freethought101/RackBotGen3/cad/src/README.md

# Models

Frame for all bay-side parts: x = across the bay (0 = centerline), y = into the bay
(0 = rack face), z = up (0 = shelf floor top). Shared numbers: `lib/dims.py`
(source of truth: `docs/spec/01-mechanical.md` §1).

| Script | Output | Purpose | Print |
| --- | --- | --- | --- |
| caddy.py | STEP/caddy.step, STL/caddy.stl | 3.5" drive caddy with hook notch and tag/QR recesses | PETG ×6, floor down, no supports |
| dummy_drive_shell.py | STEP/…, STL/dummy_drive_shell.stl | Ballast shell, 3.5" envelope, heat-set inserts | PLA ×6, floor down |
| dummy_drive_lid.py | STEP/…, STL/dummy_drive_lid.stl | Screw-on lid with label recess | PLA ×6, flat |
| bay_shelf.py | STEP/bay_shelf.step, STL/bay_shelf.stl | Bay shelf: guide walls, lead-in, back stop, switch bracket, M5 flanges | PETG ×6 (4 rack + 2 spare), floor down |
| fit_coupons.py | STEP/fit/…, STL/fit/{shelf_slice,caddy_slice,hole_coupon}.stl | Fit test 1 coupons: 40 mm shelf and caddy slices (channel clearance) and a hole-size coupon — see docs/fit-test-01.md | PETG, < 1 h each |
| bay_fit.py | STEP/bay_fit.step | Fit check: 2 shelves + caddy + dummy + 2020 stubs | — |
| dock_block.py | STEP/…, STL/dock_block.stl | Dock: V-funnel + 10 mm throat, stop at y = −30, charging-contact recesses, dock switch bracket | PETG ×2, floor down |
| tag_fin.py | STEP/…, STL/tag_fin.stl | 50 mm approach tag (ID 0 rack / ID 10 spare) on the front-right upright | PLA ×2 |
| tag_strip_rack.py | STEP/…, STL/tag_strip_rack.stl | Bay tags IDs 1–4 on the front-left upright | PLA ×1 |
| tag_strip_spare.py | STEP/…, STL/tag_strip_spare.stl | Slot tags IDs 11–12 | PLA ×1 |
| rack.py | STEP/rack.step | Rack assembly: 2020 frame, 4 shelves, caddies, dock, tags, Delta PSU/PLC placeholders | — |
| spare_station.py | STEP/spare_station.step | Spare station assembly: S1 GOOD / S2 RMA | — |

| robot/*.py | STEP/robot/…, STL/robot/… | 19 printed robot parts: nose, caster_spacer_rear (×2) + caster_spacer_front (for the bought 20 mm casters), deck, drive_bracket (×2, one mirrored), drive_hub (×2, PETG, outboard face down) + drive_tire (×2, TPU 95A), mast_collar (socket + flange + rear gusset), mast_top_plate (KFL08), z_motor_mount, z_carriage (nut block on a fin + shelf), tray_stack (print on its back plate), rail_bracket, y_idler_bracket, y_carriage (gantry plate, frame, arm, belt clamp), finger (×2, 10 mm), electronics_tray, pi_tray, battery_box | PETG |
| robot_assembly.py | STEP/robot_assembly.step | Robot at a travel pose (Z 210, extractor home) | — |
| robot_docked.py | STEP/robot_docked.step | Rack + robot docked, extracting from bay 2 (Y = Y_PULL = 177, finger B engaged) | — |

Robot frame = rack frame with the robot docked (nose tip on the stop at y = −30). Dimensions:
`lib/robot_dims.py`; assembly factory `lib/robot_build.py` (`robot_parts(Z, Y, fingers)`); purchased parts
are envelope stand-ins in `lib/vendor.py` (NEMA17, MG90S, casters, mini V-wheels, KFL08, Pi, battery…), and the motion
board is the real KiCad STEP export. Robot nested scripts run as `PYTHONPATH=src python src/robot/<part>.py`.

2020 cut list: rack 2 × 220, 4 × 320, 2 × 180; spare station 2 × 220, 4 × 215, 2 × 180;
robot 2 × 300 (rails), 3 × 110 (cross members), 1 × 285 (Y rail); 2040 × 420 (mast). 4.96 m of cuts + kerf → buy 6 × 1 m.

Build (from `cad/`): `PYTHONPATH=src python src/<model>.py` (with `python` = the cadgen uvx Python).
Checks: `PYTHONPATH=src python checks/bay_fit_check.py`, `checks/station_check.py` (station vs robot probe boxes) and
`checks/robot_check.py` (overlap **and ≥ 1 mm running clearance** for every moving pair over 42 poses incl. intermediate
Y and the hard stop; docked lift sweep carrying two caddies; full pull/push strokes at every bay and spare slot with
the caddy moving with the finger, the idle finger parked and the other caddy on the tray; push seats the caddy; camera
sight lines and FOV; mass/CG/tip-over; packing; print bed — see docs/spec/01 §6.8), and `checks/fastener_check.py`:
every screw, nut, T-nut and insert (`lib/robot_fasteners.py`, step.parts models in `cad/vendor/fasteners`) against the
parts: no fastener hits a part it does not thread into (missing / misplaced / blocked holes), heads and nuts seated,
thread engagement without bottoming out (T-nut ≥ 3 mm and short of the slot core, inserts, pilots, motor threads), and
≥ 1 mm from parts moving relative to it over 19 poses. It prints the modeled fastener bill. `robot_assembly.step`
shows the fasteners.

To verify on real hardware: 3.5" bottom hole positions (`HDD_HOLE_Y`, slotted ±3 mm),
KW11-3Z switch hole pitch and actuation point (bracket slotted ±2 mm).
