freethought101/RackBotGen3/docs/cart-batch-2.md

# Tokopedia cart, batch 2 (to add after batch 1 is checked out)

Batch 1 (≈ Rp5.2M incl. shipping, 373 units) filled most of the cart; Tokopedia allows 400 units per cart, so these
go in once batch 1 is paid. Prices are search / listing prices checked on 2026-10-24 and change often. "Min" not
checked unless stated. Rajacell is closed, so it is not used.

## Priced

| # | Item | Qty | Listing (shop, city) | Unit Rp | Line Rp | Notes |
|---|---|---|---|---|---|---|
| 1 | 2020 corner bracket (gusset) | 48 | [Angle Corner Bracket 2020 90° Gusset](https://www.tokopedia.com/rajawali3d/angle-corner-bracket-2020-90-degree-gusset-element-siku-aluminium) (Rajawali3D, Temanggung) | 1,940 | 93,120 | Confirmed on the product page; 50k+ sold |
| 2 | M3 × 8 socket head | 16 | [M3 × 8 socket head](https://www.tokopedia.com/centi-store/baut-hex-hexagonal-l-screw-socket-head-cap-m3-x-8mm-3mm-8-mm) (CENTI Store, Surakarta) | 600 | 9,600 | Alt: 3Din Jakarta DIN912 SS304, Rp700 (already in batch 1 for M5, shares shipping) |
| 4 | M3 heat-set insert, OD 4.5 × L4 | 60 | [PrintfyLabs brass M3](https://www.tokopedia.com/printfylabs/brass-hot-melt-heat-set-insert-nuts-knurled-m3-berbagai-ukuran-untuk-inset-baut-drat-3d-print-1731185180283733698) (Cimahi) | ≈ 1,450 | ≈ 87,000 | Check the M3 × 4 × 4.5 variant and whether the price is per piece |
| 5 | M5 heat-set insert, OD ≈ 7 | 15 | [Ciptakarya3d M2–M8](https://www.tokopedia.com/ciptakarya3d/brass-hot-melt-thread-inserts-nut-m2-m2-5-m3-m4-m5-m6-m8-double-twill-knurled-varian-1-x-100pcs-free-box-1729797896345322881) | ≈ 1,900 | ≈ 28,500 | M5 variant price not confirmed |
| 7 | microSD 32 GB SanDisk Ultra A1 | 1 | [EAONLINE](https://www.tokopedia.com/eaonlineofficial/sandisk-ultra-micro-sd-uhs-i-a1-120mbps-32gb-qua4) (Jakarta) | 217,300 | 217,300 | Not the official store; the official SanDisk Indonesia store shows ≈ Rp227,500. A local shop is likely cheaper (≈ Rp60–130k in sourcing-options) |
| 9 | Servo extension 30 cm, 3-pin | 3 | [Arduino Store](https://www.tokopedia.com/arduinoid/kabel-extension-sensor-servo-3pin-wire-female-to-female-10cm-30cm-50cm-1729640693361902744) (Bekasi) | 6,081 | 18,243 | Same shop as the camera cable in batch 1 |
| 11 | Pi 3 heatsink set | 1 | [Mechatron](https://www.tokopedia.com/mechatron/set-heatsink-raspberry-pi-3-thermal-tape-4pcs-pendingin-heat-sink) (Depok) | 10,500 | 10,500 | |
| 13 | Silicone wire 18 AWG, red + black 1 m | 2 | [My Aladin](https://www.tokopedia.com/alladinshop/1meter-kabel-silikon-18awg-silicone-wire-18-awg-merah-atau-hitam-awg18-rc-1730879276904908043) (Bekasi) | 7,372 | 14,744 | Red and black were **sold out** on 24 Oct; recheck or buy locally |
| 16 | Inline blade fuse holder | 1 | [pln-original](https://www.tokopedia.com/pln-original/fuse-blade-holder-waterproof-rumah-sekring-tancap-small-kecil-dengan-kabel-merah-untuk-keamanan-listrik-17338236263444982) (Bandung) | 5,099 | 5,099 | 7.5 A blade fuses not found: buy at a local auto/electrical shop |
| 17 | SS54 Schottky (SMA) | 2 | [Elektro Bar](https://www.tokopedia.com/elektrobar/ss54-1n5824-schottky-diode-sma-ss-54-1n-5824-1733751768989205551) (Jakarta Barat) | 550 | 1,100 | |
| 18 | 1N4007 | 5 | [Putra Niaga](https://www.tokopedia.com/putraniagabdg/dioda-1n4007-1a-1000v-in4007-high-quality-1730886221138658600) (Bandung) | 250 | 1,250 | Already a batch-1 shop |
| 19 | 5 × 20 fuse T3.15 A slow-blow | 3 | [Tektron, Littelfuse ceramic](https://www.tokopedia.com/tektron/fuse-3-15a-250v-littelfuse-keramik-ceramic-slowblow-5x20-5-20-3-15a) (Bandung) | 5,000 | 15,000 | |
| 20 | 22 mm pilot lamp 24 V DC, R/Y/G | 3 | [Kanglistrik, EWIG red](https://www.tokopedia.com/kanglistrik/lampu-indikator-pilot-lamp-24v-dc-22mm-premium-quality-ewig-merah) (Jakarta Barat) | 10,000 | 30,000 | Only the red listing seen; check yellow/green. Central Electrindo EWIG: min 5 per colour (≈ Rp110k for 15) |
| 22 | Brass sheet 0.5 mm, 10 × 10 cm | 1 | [SOEMBER-SUKSES](https://www.tokopedia.com/soember-suksess/plat-kuningan-0-5mm-x-10cm-x-10cm) (Jakarta Barat) | 22,000 | 22,000 | |

Priced subtotal ≈ **Rp553k** (≈ Rp336k without the microSD).

**Added to the cart on 24 Oct** (fit under the 400-unit cap): #7, 9, 11, 16, 17, 18, 19, 22 (≈ Rp290k).
**Still to add after batch 1 is paid:** #1, 2, 4, 5 (don't fit), #20 (minimum 5 per colour = 15 lamps, ≈ Rp110k),
#13 (red/black sold out; buy locally), plus everything under "Still to find".

## Still to find

| # | Item | Qty | Notes |
|---|---|---|---|
| 3 | M3 × 16 socket head + M3 nuts | 1 + ≈ 20 | 3Din Jakarta (DIN912) or Rajawali3D |
| 6 | M2 × 8 self-tapping screws | 1 pack | [Ada Hardware M2 × 8](https://www.tokopedia.com/adahardware/baut-pa-phillips-head-micro-screws-round-head-self-tapping-sekrup-elektronik-kayu-ujung-runcing-m2-m2-8-c9490) (from sourcing-options, price not rechecked) |
| 8 | Micro-USB male pigtail, bare wires | 1 | Search found only full cables; cutting a cheap micro-USB cable works |
| 10 | Heat-shrink assortment | 1 | Candidates: mutiaratokped (580 pcs), CASTA (164/328/530 pcs) |
| 12 | Drag chain 7 × 7 or 10 × 10 mm, 1 m | 1 | Lajarus only has 20–35 mm wide ones (Rp140k, too big) |
| 14–15 | 22 AWG and 26 AWG wire | few m | Local electronics shop is fine |
| 21 | 8-ch optocoupler 24 V → 3.3 V | 1 | None in stock; an 8-ch PC817 board (≈ Rp24k, seller not captured) or PC817 ×10 + resistors |
| 23–24 | 4-core and 2-core 0.75 mm² cable | 2 m each | Local electrical shop |
| 25 | XT60 female with 14 AWG lead | 1 | Not found at Pit stop hobby; cut one end off a spare XT60 pigtail or buy locally |
| 26 | JST-XH crimp tool SN-28B | 1 | Optional, only if the team has none |
