freethought101/RackBotGen3/docs/poster/poster.html

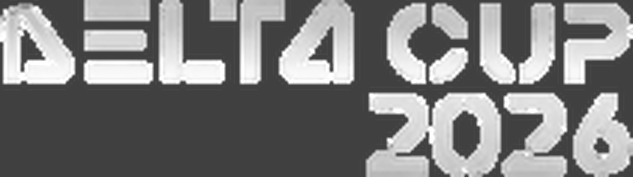
[picture p9: docs/poster/img/deltacup.png]
Delta Cup 2026
AUTOMATION TRACK 

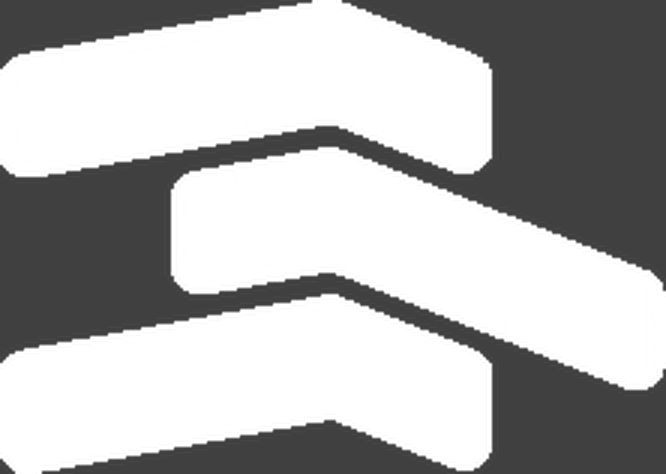
[picture p10: docs/poster/img/logo.png]


# CORVIN

Reducing manual downtime in data centers with an autonomous robot that replaces failed hard drives, with real-time operator control

The problem

### Drives fail, people walk

Until a technician swaps the drive, the RAID array runs without redundancy.

Our solution

### Corvin swaps them itself

It fetches a spare, swaps the drive and returns the failed one for RMA.

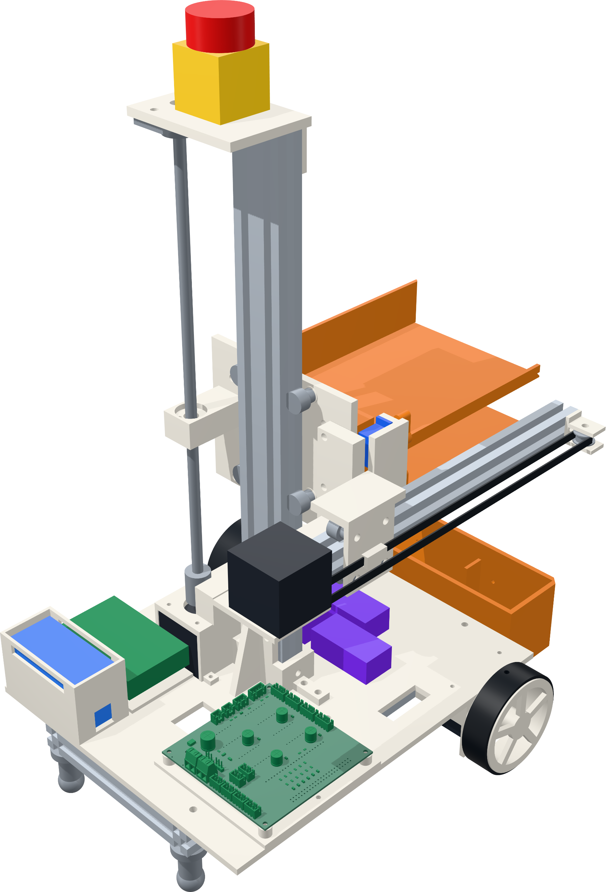
[picture p11: docs/poster/img/robot.png]
Corvin robot CAD render


Corvin at the rack

CAD model · docked at a 4-bay rack

One swap, start to finish

1

DetectDashboard flags a failing drive in bay N.

2

Pick the sparePulls a good drive into the upper slot.

3

Drive and dockAprilTag approach, V-funnel to ±2 mm.

4

ExtractChecks the caddy tag, pulls the failed drive.

5

InsertLift drops 45 mm, pushes the spare in.

6

Return for RMALeaves the failed drive in the RMA slot.

7

Charge and logCharges on the dock, logs time and Wh.

System architecture

Delta inside

### Industrial-style control

- Delta 24 V PSU: rack and dock power
- ESP32 controller: 24 V I/O, safety
- Same Modbus TCP map as a Delta PLC

IIoT + energy

### Every swap, live

- Bays, jobs and camera, 5 updates/s
- Energy (Wh) measured per swap
- Sleeps on the dock between jobs

≤3min

per full swap
(107 s simulated)

48/50

swaps with no help:
our test target

±2mm

docking repeatability
with the V-funnel

2

trips per job:
home → rack → home

50Wh

battery, under the
100 Wh flight limit

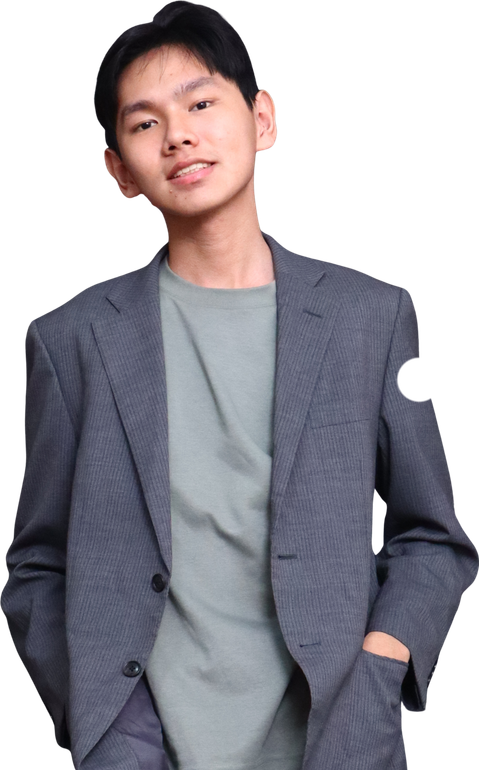
[picture p12: docs/poster/img/richard.png]
richard


Richard

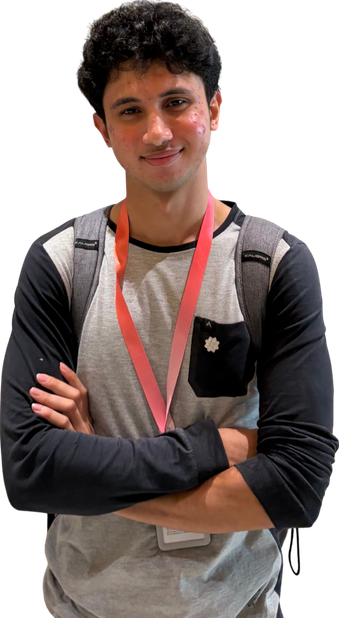
[picture p13: docs/poster/img/saleh.png]
saleh


Saleh

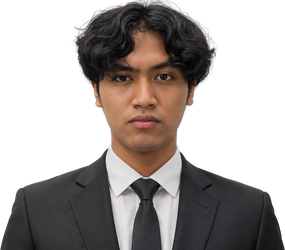
[picture p14: docs/poster/img/bagus.png]
bagus


Bagus

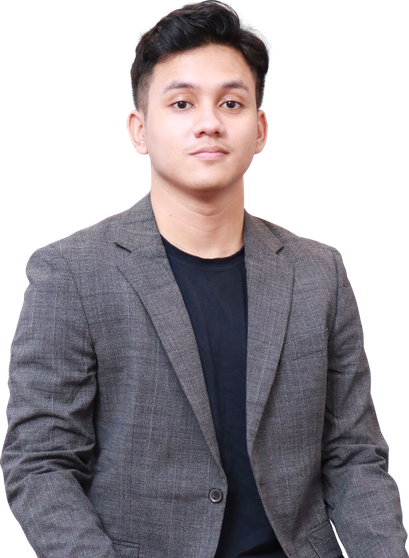
[picture p15: docs/poster/img/rangga.png]
rangga


Rangga

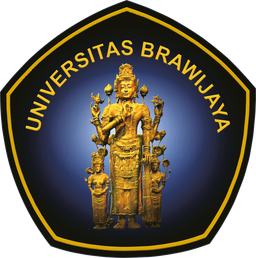
[picture p16: docs/poster/img/ub.png]
Universitas Brawijaya


Team

## Boys Go To Thailand

University of Brawijaya, Indonesia
