freethought101/RackBotGen3/pcb/system/rbg3-system.pdf

1 | 2 | 3 | 4 | 5 | 6
1 | 2 | 3 | 4 | 5 | 6

AB

C

D

AB

C

### D Date: 2026-10-24

Size: A4 | Rev: 1
KiCad E.D.A. 10.0.5 | Id: 1/4

# Title: RBG3 system wiring: overview

### File: rbg3-system.kicad_sch

### Sheet: /

## RackBotGen3 (Delta Cup 2026)

### Generated by pcb/system/scripts/gen_system.py; edit the script, not these files

### Board-level circuit: pcb/motion-board/rbg3-motion.kicad_sch

Robot harness File: robot.kicad_sch | Rack and spare station

File: rack.kicad_sch

ESP32 rack controller (PLC fallback) File: rack-esp32.kicad_sch

# RackBotGen3 (Corvin) system wiring

Sheet 2: robot harness (battery, fuse, switch, INA226, E-stop relay, bucks, charger, Pi, motion board connectors, motors, switches, servos, LED, buzzer).
Sheet 3: rack and spare station (mains, 24 V PSU, rack controller terminals, bay switches, E-stop, dock relay, lamps, station cables, dock contacts and station switches).
Sheet 4: ESP32 rack controller, the PLC fallback (P40), wired to the same terminal names. The two sides meet only at the spare-station dock: robot pads J102 ↔ station contacts J202

(24 V charging, switched by the rack's dock relay), and over Wi-Fi (Pi AP RACKBOT ↔ rack controller).

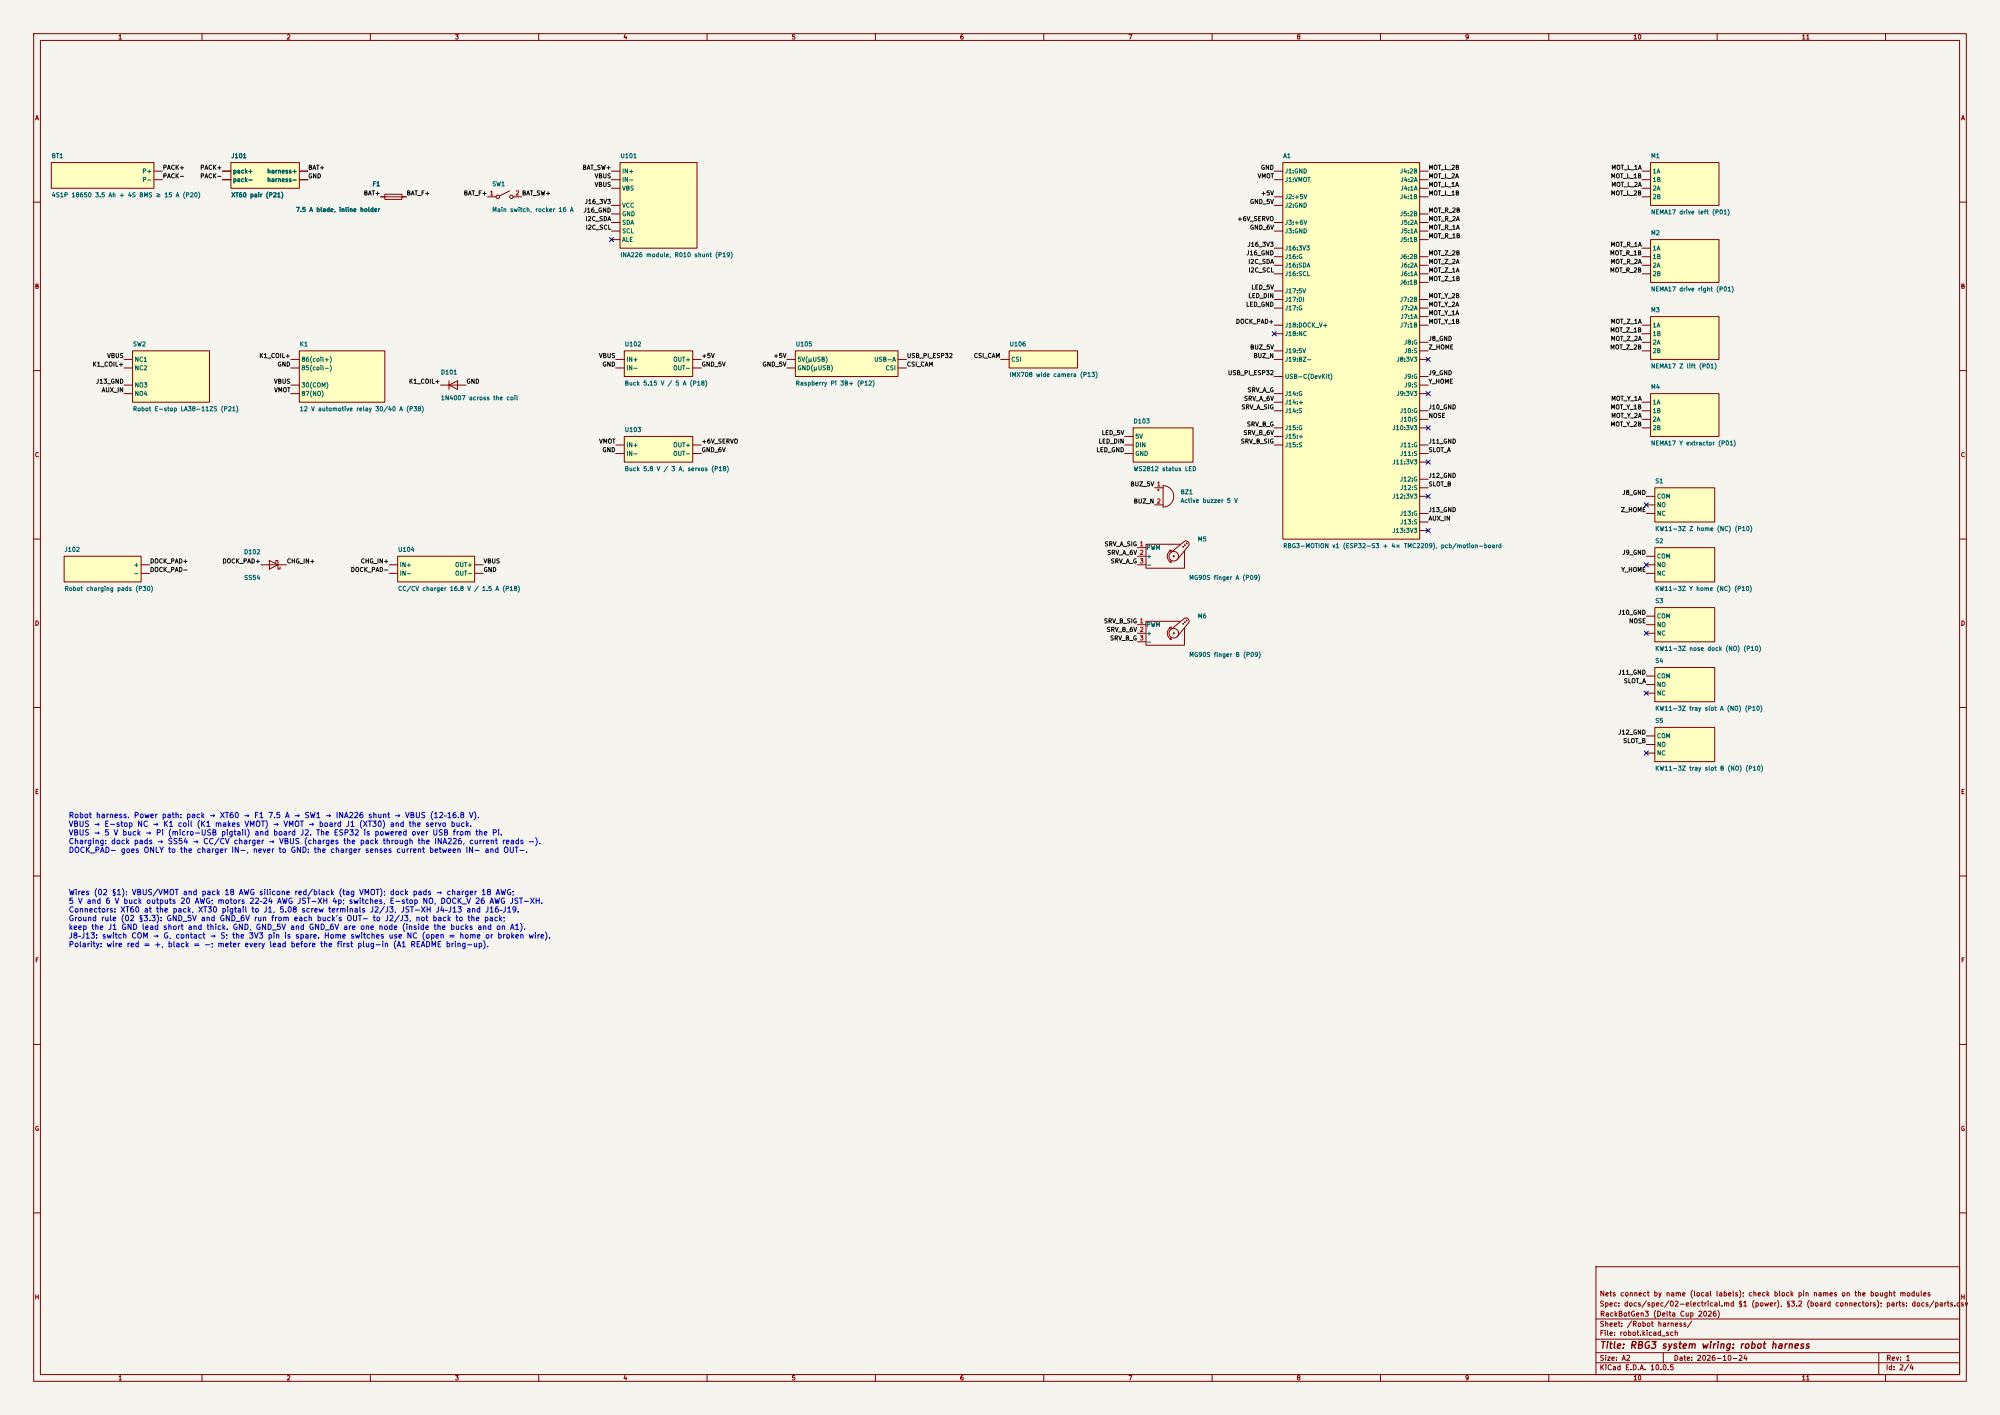
[picture p20: page 2]

A1RBG3-MOTION v1 (ESP32-S3 + 4× TMC2209), pcb/motion-board 1

SRV_A_6V Robot harness. Power path: pack → XT60 → F1 7.5 A → SW1 → INA226 shunt → VBUS (12–16.8 V).

VBUS → E-stop NC → K1 coil (K1 makes VMOT) → VMOT → board J1 (XT30) and the servo buck.
VBUS → 5 V buck → Pi (micro-USB pigtail) and board J2. The ESP32 is powered over USB from the Pi.
Charging: dock pads → SS54 → CC/CV charger → VBUS (charges the pack through the INA226, current reads −).
DOCK_PAD− goes ONLY to the charger IN−, never to GND: the charger senses current between IN− and OUT−.

Wires (02 §1): VBUS/VMOT and pack 18 AWG silicone red/black (tag VMOT); dock pads → charger 18 AWG;
5 V and 6 V buck outputs 20 AWG; motors 22–24 AWG JST-XH 4p; switches, E-stop NO, DOCK_V 26 AWG JST-XH.
Connectors: XT60 at the pack, XT30 pigtail to J1, 5.08 screw terminals J2/J3, JST-XH J4–J13 and J16–J19.
Ground rule (02 §3.3): GND_5V and GND_6V run from each buck's OUT− to J2/J3, not back to the pack;
keep the J1 GND lead short and thick. GND, GND_5V and GND_6V are one node (inside the bucks and on A1).
J8–J13: switch COM → G, contact → S; the 3V3 pin is spare. Home switches use NC (open = home or broken wire).
Polarity: wire red = +, black = −; meter every lead before the first plug-in (A1 README bring-up).

Nets connect by name (local labels); check block pin names on the bought modules
Spec: docs/spec/02-electrical.md §1 (power), §3.2 (board connectors); parts: docs/parts.csv
RackBotGen3 (Delta Cup 2026)
Sheet: /Robot harness/
File: robot.kicad_sch
Title: RBG3 system wiring: robot harness

1 | 2 | 3 | 4 | 5 | 6 | 7 | 8
1 | 2 | 3 | 4 | 5 | 6 | 7 | 8

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
### F Date: 2026-10-24

Size: A3 | Rev: 1

# Title: RBG3 system wiring: rack and spare station

### File: rack.kicad_sch

### Sheet: /Rack and spare station/

## RackBotGen3 (Delta Cup 2026)

### Spec: docs/spec/02-electrical.md §4 (rack), §5 (safety); 03 §4 (Modbus); 01 §5 (stations)

### U201 terminals are the PLC's; the ESP32 fallback (sheet 4) exposes the same functions

LN

PE

J201 Mains 220 V cord + plug | COM

NO
NC

S207 KW11-3Z S2 RMA present (X7) (P10) COM NO
NC

S206 KW11-3Z S1 GOOD present (X6) (P10) COM NO
NC

S205 KW11-3Z dock: robot home (X4) (P10) H203 RED 24 V 22 mm (P27) DOCK+

DOCK−

DOCK+
DOCK−

W202

2-core 0.75 mm² dock lead ≈ 1.5 m (P30) +24V X4

X6

X7 | +24V X4
| X6

X7 W201

4-core signal cable ≈ 1.5 m (P30) | H202

YELLOW 24 V 22 mm (P27) H201 GREEN 24 V 22 mm (P27) 24V 0VS/S

X0
X1
X2
X3
X4
X5
X6
X7 | UP ZP
| Y0 Y1 Y2 Y3
| LAN

U201 Rack controller: Delta DVP-12SE11T (P25) or ESP32 fallback (P40) NC-A1 NC-A2 NC-B1 NC-B2

SW201 Rack E-stop 2 × NC (P28) COM NO
NC

S204 KW11-3Z bay 4 caddy present (P10) COM NO
NC

S203 KW11-3Z bay 3 caddy present (P10)

+(right)

−(left) J202 Dock contacts, spare station (P30)

F201

3.15 A slow-blow, UK5-HESI DC+ DC−
IN

COM
NO
NC

K201
24 V relay module, low-level trigger (P26) COM NO
NC

S202 KW11-3Z bay 2 caddy present (P10) COM NO
NC
S201 KW11-3Z bay 1 caddy present (P10) | LN
PE | +V −V PS201 Delta DRL-24V120W1EN 24 V 5 A (P24) X3

STN_X7

AC_N

PE | 0V

Y0

AC_L AC_N

PE | +24V DOCK_RLY_24V0V

Y0 +24V X0

STN_DOCK−

+24V X1

0V+24V

Y1 +24V | +24V_F | +24V +24V_F DOCK+

X7

0V +24V | STN_24V +24V | X6

X2

X5

X4

0V X0 DOCK_RLY_24V +24V X5 +24V

X3

STN_X4

STN_DOCK+ Y1 +24V

Y3 | +24V Y2 | +24V Y3

# Y2 +24V X4

X6

# X7 DOCK+

0V | STN_DOCK−

STN_24V
STN_X4
STN_X6
STN_X7

X2

STN_DOCK+

X1

STN_24V STN_X6

STN_24V

AC_L

LAN: only with the PLC (Wi-Fi client bridge to
the Pi AP RACKBOT, 02 §4.3). The ESP32 uses Wi-Fi. Rack DIN rail: PSU, U201, K201, F201, terminal blocks for +24V / 0V. Spare station: S205–S207 and J202.

Inputs: switches connect +24V to Xn, S/S to 0V (sourcing). Outputs Y0–Y3 sink (NPN): lamps and K201 IN go between +24V and Yn. UP = +24V, ZP = 0V power the PLC's transistor outputs.
Dock power: K201 closes only while Y0 = M0 AND X4 AND X5 AND watchdog OK (ladder, 03 §4). The E-stop's second NC contact feeds K201's DC+, so a pressed E-stop drops the relay in hardware.
J202 mates with the robot's charging pads (robot sheet J102): + on the right, − on the left, viewed from the robot. 24 V reaches the pads only while the robot is docked and X4 is closed.
The rack's own dock has no switch and no contacts (01 §4): the robot's NOSE switch confirms docking there.
PE: also bond the aluminium rack frame to PE. | H202
YELLOW 24 V 22 mm (P27) | H203 RED 24 V 22 mm (P27)

1 | 2 | 3 | 4 | 5 | 6 | 7 | 8
1 | 2 | 3 | 4 | 5 | 6 | 7 | 8

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
### F Date: 2026-10-24

Size: A3 | Rev: 1

# Title: RBG3 system wiring: ESP32 rack controller (PLC fallback)

### File: rack-esp32.kicad_sch

### Sheet: /ESP32 rack controller (PLC fallback)/

## RackBotGen3 (Delta Cup 2026)

### Spec: docs/spec/02-electrical.md §4.4; parts: P40

### GPIO choice is a proposal: confirm it when the rack firmware is written

IN1
IN2
IN3
IN4
IN5
IN6
IN7
IN8 COM

# OUT1 OUT2 OUT3 OUT4 OUT5 OUT6 OUT7 OUT8

VCC

GND U303

8-ch 24 V opto input board (P40) | DC+ DC−
| TRIG1
TRIG2 GND | OUT1− OUT2−

U304 Dual MOSFET D4184 (P40): Y0, Y1

VIN(5V) GND

3V3 GPIO32 GPIO33 GPIO25 GPIO26 GPIO27 GPIO14 GPIO13 GPIO4 | GPIO16 GPIO17 GPIO18 GPIO19 U302

ESP32 DevKit V1 WROOM-32 (P40) +24V 0VX0

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
X301

Terminal row = rack sheet U201 terminals

IN+
IN−

OUT+
OUT−
U301 Buck 24 → 5 V (P40) | DC+

DC−

TRIG1

TRIG2 GND | OUT1− OUT2−

U305

0V | Dual MOSFET D4184 (P40): Y2, Y3

0V X2
X3
X4
X5
X6
X7

0V

IN_X0
IN_X1
IN_X2

# IN_X3 +3V3

X0

IN_X4
IN_X5
IN_X6
IN_X7
0V +24V | Y0

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
IN_X5

X5
X6
X7
Y2 +5V | +5V0V +3V3

IN_X6
IN_X7

0V

IN_X0
IN_X1
IN_X2
IN_X3
IN_X4

TRIG_Y3

TRIG_Y0
TRIG_Y1
TRIG_Y2 | +24V0V

TRIG_Y0
TRIG_Y1

Y0 +24V

Y3

0V

Y1 +24V | Y2

0V

TRIG_Y2
TRIG_Y3

X1 Replaces U201 on the rack sheet: the wires that went to the PLC's X0–X7, Y0–Y3, 24V and 0V land on X301.

Inputs: opto IN1–IN8 take the +24 V switch signals with COM to 0V; the opto outputs pull the GPIOs low when an input is on (use INPUT_PULLUP if the board has no pull-ups; check its jumper/polarity).
Outputs: the D4184 modules sink like the PLC's NPN outputs, so lamps and the dock relay module (low-level trigger) keep their +24V common wiring. GPIO16–19 drive the triggers (3.3 V logic).

Proposed pins avoid the ESP32 strapping pins 0, 2, 5, 12, 15 and the flash pins 6–11; GPIO34–39 are left
free (input-only, no pull-ups). The firmware exposes the same Modbus TCP map as the PLC (03 §4) over Wi-Fi. Module pin names vary by vendor: check the bought boards before wiring.
