freethought101/RackBotGen3/.deck-publish/video/corvin-pitch-still.jpg

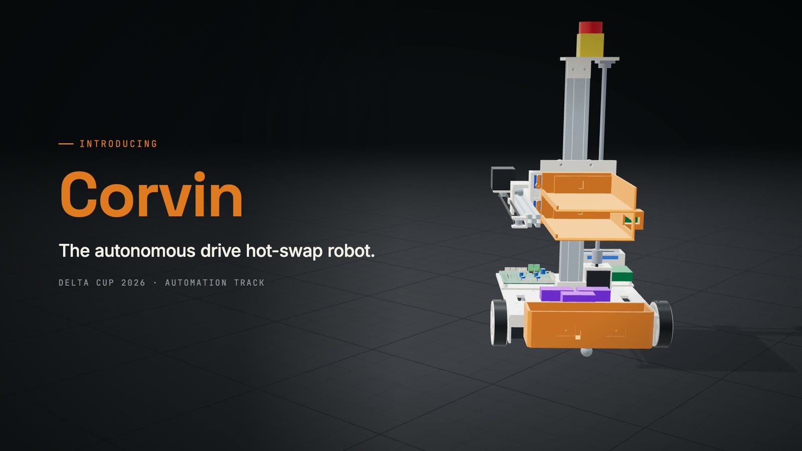
.deck-publish/video/corvin-pitch-still.jpg
