freethought101/RackBotGen3/.deck-publish/video/sheet.jpg

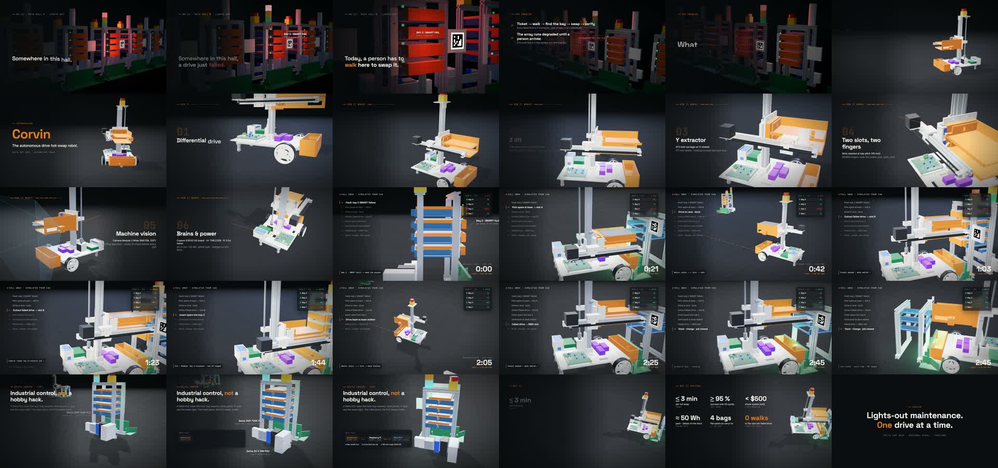
.deck-publish/video/sheet.jpg
