freethought101/RackBotGen3/.deck-publish/video/title-check.jpg

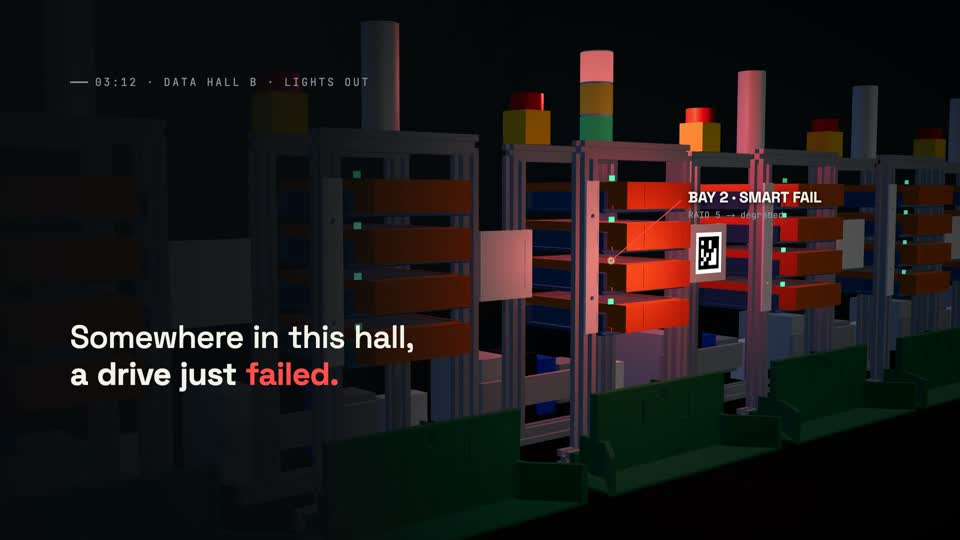
.deck-publish/video/title-check.jpg
