freethought101/RackBotGen3/docs/datasheets/P05_anti-backlash-nut-block_drawing.jpg

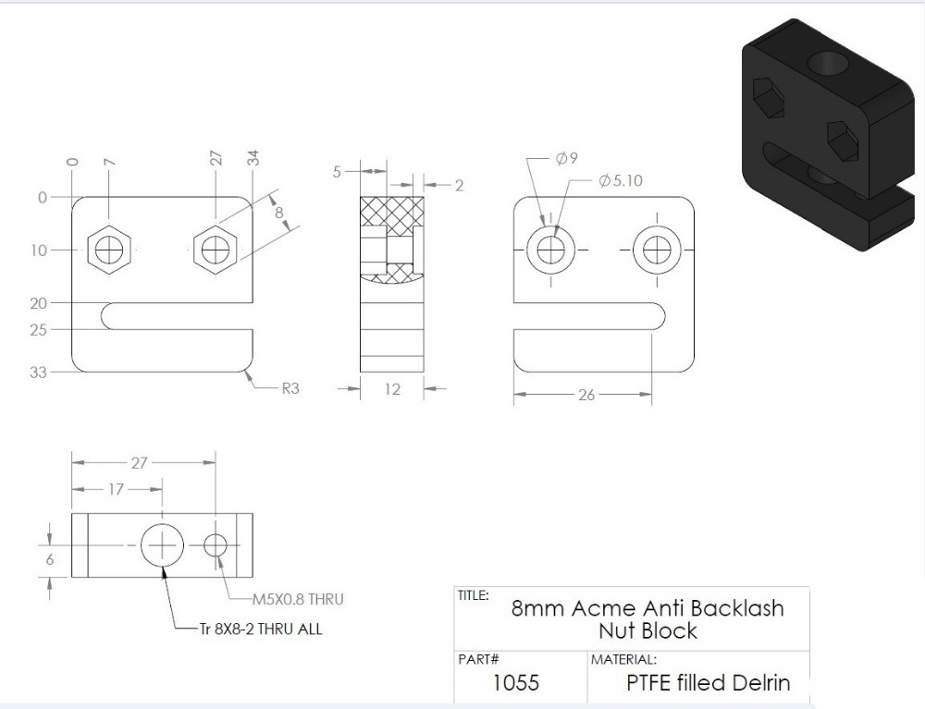
docs/datasheets/P05_anti-backlash-nut-block_drawing.jpg
