freethought101/RackBotGen3/docs/datasheets/P11_heat-set-inserts_3din.jpg

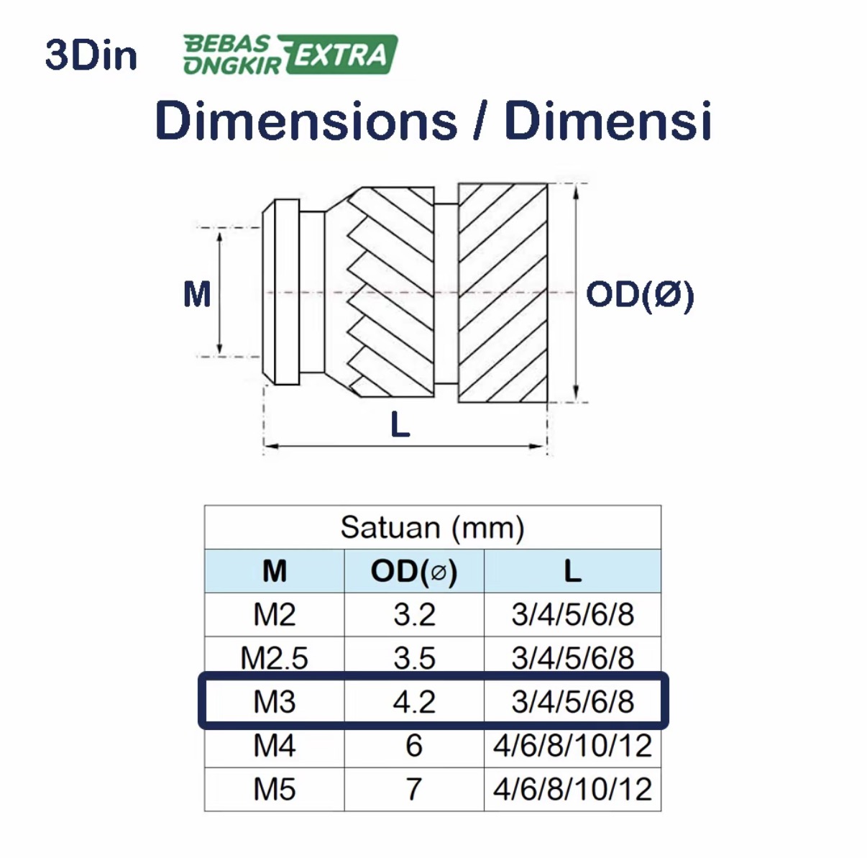
docs/datasheets/P11_heat-set-inserts_3din.jpg
