freethought101/RackBotGen3/docs/poster/Corvin-poster-A2.png

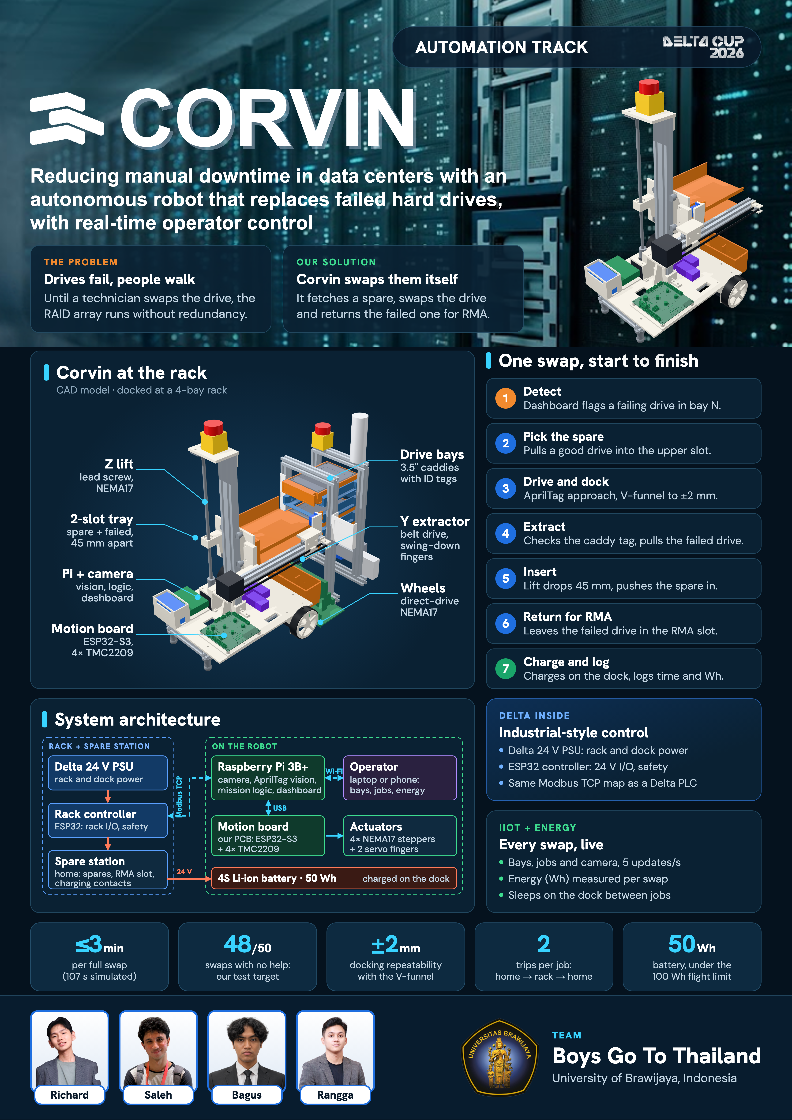
docs/poster/Corvin-poster-A2.png
