freethought101/RackBotGen3/docs/poster/img/bg.png

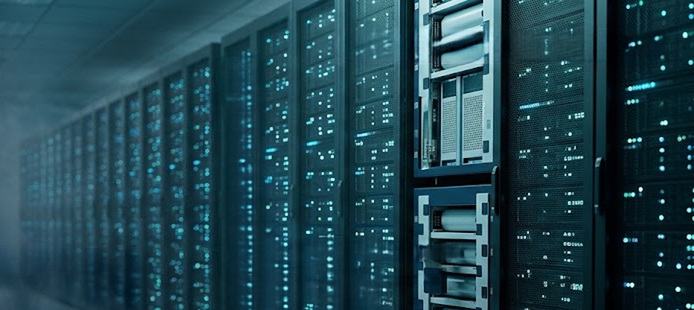
docs/poster/img/bg.png
