freethought101/RackBotGen3/docs/poster/img/docked.png

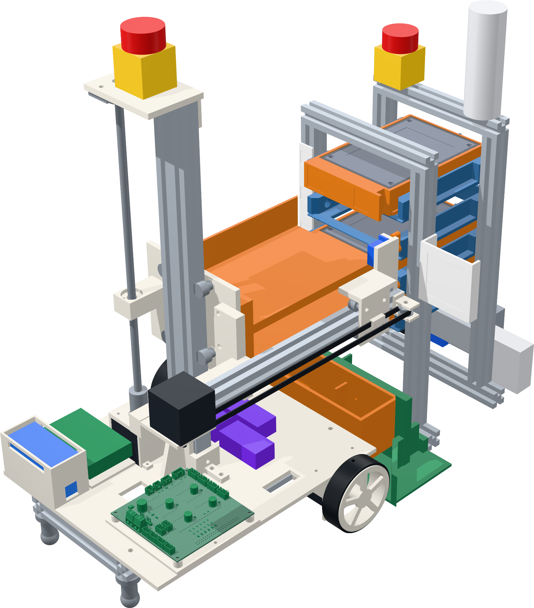
docs/poster/img/docked.png
