freethought101/RackBotGen3/docs/review/img/robot-simple.png

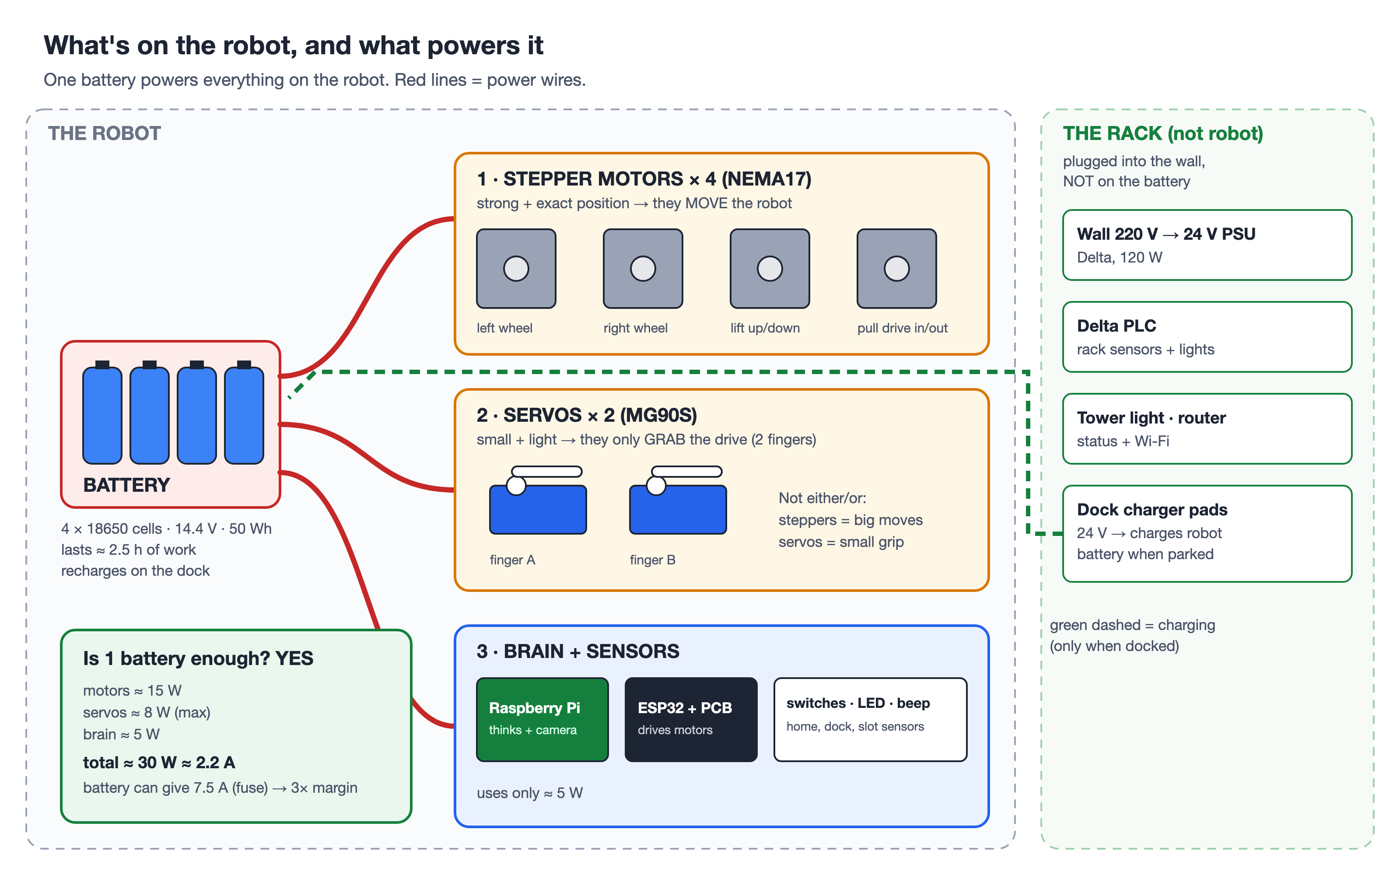
docs/review/img/robot-simple.png
