freethought101/RackBotGen3/docs/review/img/system-map.png

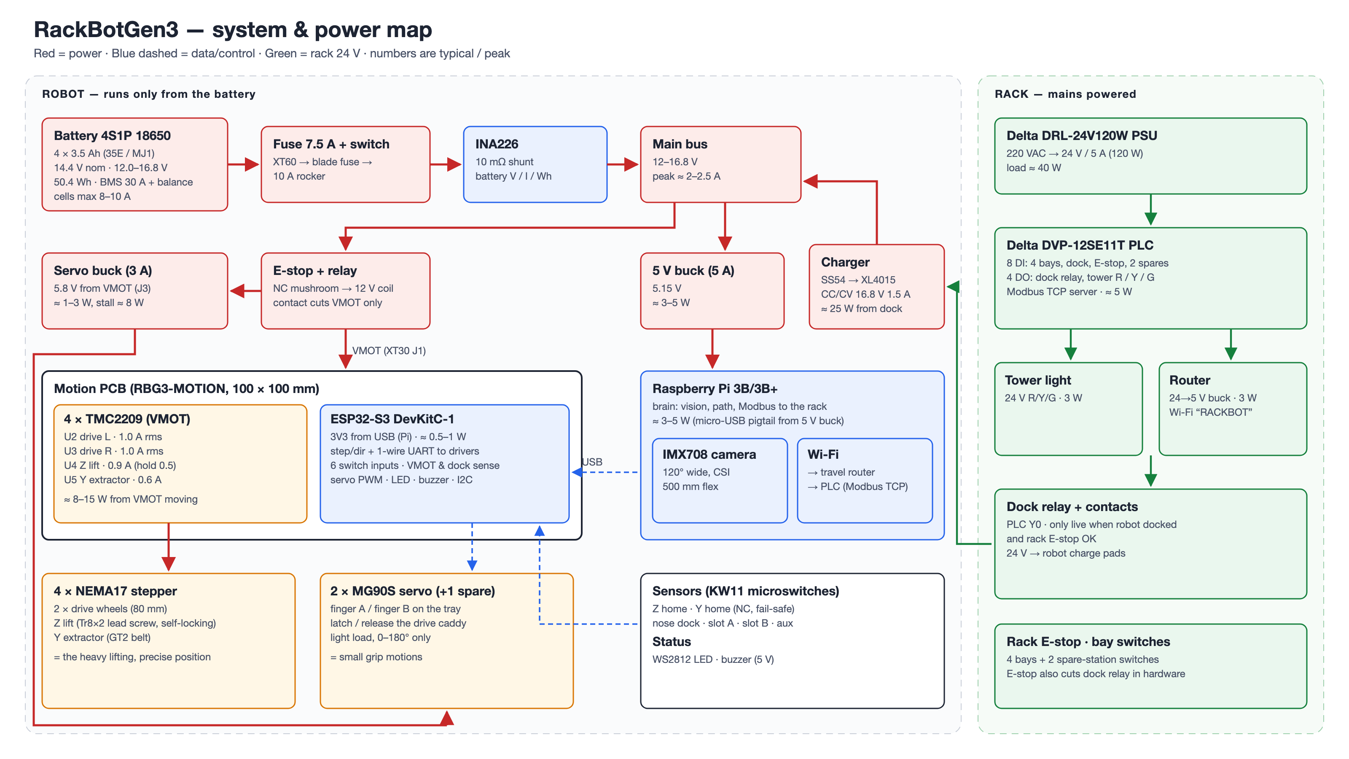
docs/review/img/system-map.png
