freethought101/RackBotGen3/pcb/motion-board/fab/rbg3-motion-3d-top.png

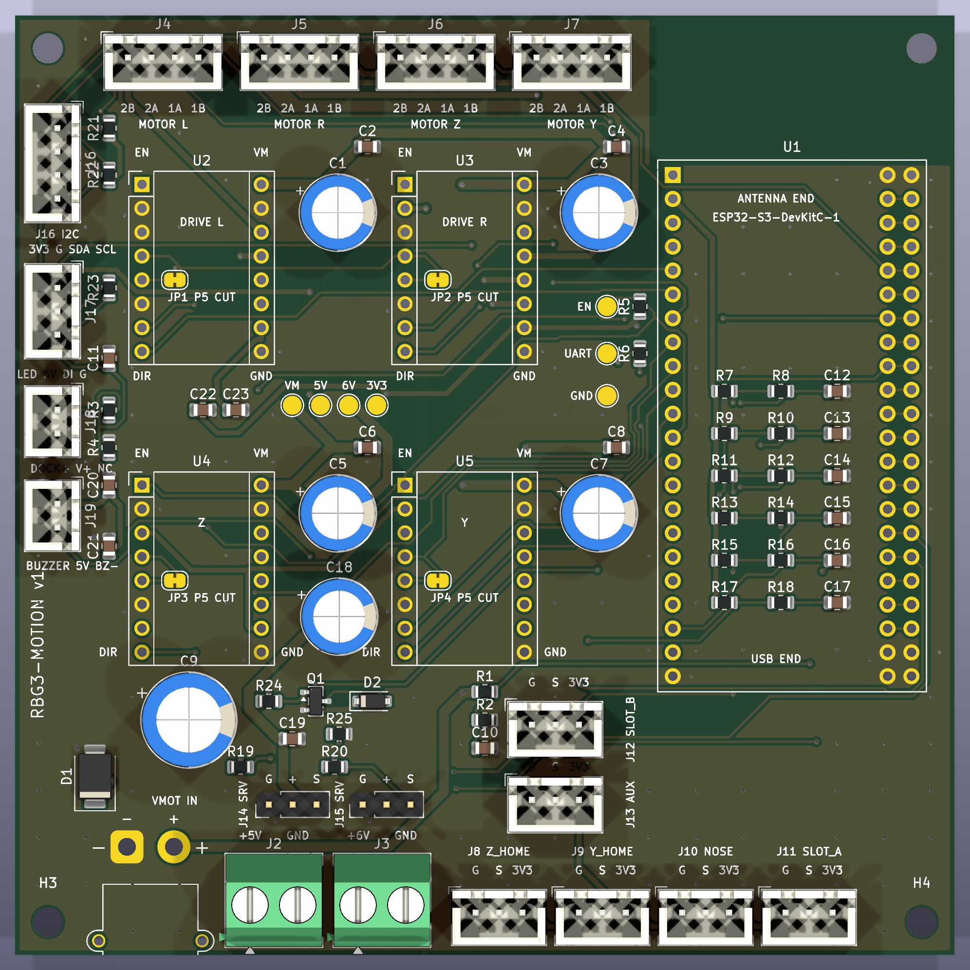
pcb/motion-board/fab/rbg3-motion-3d-top.png
