freethought101/RackBotGen3/docs/parts.csv

id | part | category | qty | est_cost_usd | spec | used_in | supplier | status | order_by | link | spec_rev
P01 | NEMA17 stepper motor | Robot mechanical | 4 | 42 | 42x42x40 mm, >= 0.4 N·m holding, 1.5-1.7 A, 5 mm D-shaft >= 22 mm, 31 mm hole pitch; Tokopedia: JK42HS40-1704 (1.7 A, 40 mm), ~Rp168k each | Drive L/R (direct drive), Z lift, Y extractor | Tokopedia | To order | 2026-10-08 |  | v0.1.12
P02 | 2020 V-slot extrusion | Robot mechanical | 6 | 19 | ~4.96 m total + ~3 mm kerf per cut (5.02 m) -> buy 6 x 1 m (or cut-to-length). Cuts: rack 2x220 4x320 2x180; spare 2x220 4x215 2x180; robot 2x300 3x110 1x285; Tokopedia: Lajarus Teknik 2020 V-slot per metre (~Rp50k/m) or per 10 cm cut to the list | Rack frame, spare station frame, robot chassis, Y rail | Tokopedia | To order | 2026-10-08 |  | v0.1.16
P03 | 2040 V-slot extrusion | Robot mechanical | 1 | 4 | 1 x 420 mm; Tokopedia: Lajarus Teknik 2040 V-slot per 10 cm (~Rp13k), cut to 420 mm | Robot mast | Tokopedia | To order | 2026-10-08 |  | v0.1.16
P04 | Mini V-wheel kit | Robot mechanical | 8 | 10 | 8 mini V-wheels with 105zz, for 20xx V-slot; axle stack plate -> 6 mm spacer -> 1 mm shim -> wheel: 4 mini eccentric spacers (8 mm hex, 6 mm, 5 mm bore, boss for a 7.12 mm hole), 4 plain 6 mm M5 spacers, 10 precision shims 5 x 8 x 1 (inner ring only); Tokopedia: Rajawali3D mini V-wheel with 105zz (~Rp13k each) + Rajawali3D mini eccentric spacer 8HEX (~Rp7k each); plain spacers and shims ~Rp30k | Z carriage (4), Y carriage (4) | Tokopedia | To order | 2026-10-08 |  | v0.1.23
P05 | Tr8x2 lead screw set | Robot mechanical | 1 | 7 | Tr8x2 (lead 2 mm) x 350 mm + anti-backlash nut + 5-8 mm flexible coupler + KFL08 2-bolt flange bearing (not KP08 pillow block); Tokopedia, all Lajarus Teknik: T8 1-start lead 2 mm screw per 10 cm (cut to 350 mm, ~Rp67k), anti-backlash nut block lead 2 (OpenBuilds 1055 copy, 34 x 33 x 12, 2 x M5 20 apart), KFL08, 5x8 coupler; ~Rp118k total | Z lift | Tokopedia | To order | 2026-10-08 |  | v0.1.31
P06 | GT2 belt drive set (Y axis) | Robot mechanical | 1 | 3 | GT2 6 mm open belt >= 1 m, 20T pulley 5 mm bore, GT2 idler (toothless, M5 / 5 mm bore); Tokopedia: Lajarus Teknik GT2 6 mm belt per metre (~Rp20k) + toothless idler 20T bore 5 W10 (~Rp15k); Rajawali3D 20T 5 mm pulley for 6 mm belt (~Rp12k) | Y extractor | Tokopedia | To order | 2026-10-08 |  | v0.1.16
P07 | Wheel 80 mm with 5 mm hub | Robot mechanical | 2 | 0 | Ø80 x ~24 mm rubber wheel, 5 mm set-screw hub (or printed hub + TPU tire); v0.1.13: replaced by a printed PETG hub (M3 set screw + insert on the D-shaft) and a TPU 95A tire, 80 x 24 mm, from P32/P34 | Drive wheels (direct on motor shaft) | AliExpress | Not needed | 2026-10-08 |  | v0.1.13
P08 | Ball caster | Robot mechanical | 3 | 3 | Metal ball caster; rear total height 42 mm (x2), front anti-tip 23.5 mm (x1; 6.5 mm under the nose floor so it clears the 3 mm dock plate); spacers OK; Tokopedia: bought: bustan ball caster, 20 mm tall, Ø15 ball, 48 x 32 base, 2 holes 40 apart; printed PETG spacers (caster_spacer.py) 22 mm rear / 3.5 mm front, holes slotted +/-2 mm | Robot base | Tokopedia | To order | 2026-10-08 |  | v0.1.31
P09 | MG90S metal-gear micro servo | Robot mechanical | 3 | 4 | 22.8x12.2x28.5 mm, 2 + 1 spare; Tokopedia: TowerPro MG90S, ~Rp23k each | Extractor fingers A/B | Tokopedia | To order | 2026-10-08 |  | v0.1.12
P10 | KW11-3Z lever microswitch | Robot mechanical | 15 | 3 | 20x10x6.4 mm, 3-pin (COM/NO/NC), lever; 12 + 3 spare; Tokopedia: Rajacell micro limit switch, lever, 5 A SPDT 3-pin (~Rp3.5k each) | 4 bays, 2 spare slots, spare-station dock (the rack dock has no switch), robot nose, tray slots A/B, Z/Y home (12) + 3 spare | Tokopedia | To order | 2026-10-08 |  | v0.1.22
P11 | Fastener kit | Robot mechanical | 1 | 30 | Buy list (v0.1.31; robot quantities from the CAD fastener model, cad/checks/fastener_check.py, 115 joints; rack/dock/dummy/bracket counts estimated from the CAD). M2 self-tapping pan head: x6 (10; 4 used, finger to horn), x8 (10; 4, servo tabs), x10 (30; 10 robot switches + ~14 shelf and dock switches); M2.5x6 self-tapping (10; 4, Pi). M3: set screw x5 (4; 2, drive hubs); socket x6 (6) + button x6 (24, dummy-drive lids) = 40; socket x8 (25; 16 NEMA17 + 4 deck to drive brackets); self-tapping x8 (30; 24, caddy floor to dummy drives); socket x10 (5; 2, belt clamp); socket x12 (15; 8 deck to Z mount, trays, battery box + 4 rear casters); socket x16 (10; 2 front caster + ~4 dock contacts); hex nuts (25; ~18). M4: socket x16 + hex nut (4 + 4; 2 + 2, KFL08, its holes are 4.8 mm, too small for M5). M5 button head (ISO 7380): x8 (100; ~96, 2 per 2020 inside corner bracket, ~48 brackets); x10 (50; ~41: deck, drive brackets, top plate tab, nose, bay shelves 6x4, docks 2x2); x10 countersunk (2; 1, idler bracket); x12 (20; ~18: mast collar, rear caster spacers, tags); x16 (15; 11: collar, 7 tray bolts, rail bracket); x20 (4; 2, nut block); x25 (6; 4: 3 tray bolts through the rail bracket + idler axle); x30 (10; 8, V-wheel axles). M5 drop-in T-nuts slot 6 (170; ~160: 28 robot + ~96 brackets + 24 shelves + 4 docks + ~8 tags); M5 nylock (15; 11). 2020 inside corner brackets ~48 (count the frame joints). Heat-set inserts 3Din (Tokopedia): M3 x4, OD 4.2 (50; 38: 14 robot, 24 dummy drives), 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 | Everything | Local store | To order | 2026-10-08 |  | v0.1.31
P12 | Raspberry Pi 3B/3B+ | Robot electronics | 1 | 70 | Not team-owned after all (23 Oct): buy a Raspberry Pi 3 Model B+, Tokopedia ~Rp1.06-1.19M (~70 USD; tokosalim, Rajacell or Keranjang IT, see sourcing-options P12); avoid the very cheap listings | Robot compute | Tokopedia | To order |  |  | v0.1.27
P13 | IMX708 camera board, 120° FOV (Camera Module 3 Wide class) | Robot electronics | 1 | 37 | Sony IMX708 12 MP, ~120° diagonal / ~102° H FOV, CSI 15-pin (Pi 3); AF if fitted, else fixed focus set at ~150 mm; confirm board size/hole pattern fits the tray camera mount (25 x 24 mm Pi camera pattern). Tokopedia wirogix Rp595k; backups in docs/sourcing-options.md | Robot vision | Tokopedia | To order | 2026-10-08 |  | v0.1.11
P14 | microSD 32 GB A1 | Robot electronics | 1 | 8 | SanDisk Ultra or Samsung microSD 32 GB A1 from a known shop (avoid unbranded cards) | Pi OS | Local store | To order | 2026-10-08 |  | v0.1.17
P15 | CSI camera cable 1 m | Robot electronics | 1 | 1 | 15-pin 1 mm pitch FFC, 1 m (v0.1.31: the route from the tray down the drag chain to the Pi is ~530 mm at Z max, so 500 mm is too short); Tokopedia ~Rp15-25k: the Rajacell listing stops at 50 cm, find a 1 m listing | Camera on the moving carriage | Tokopedia | To order | 2026-10-08 |  | v0.1.31
P16 | ESP32-S3-DevKitC-1 | Robot electronics | 2 | 14 | 1 + 1 spare; N8R2 (8 MB flash, 2 MB quad PSRAM) or N16R8: the firmware needs 8 MB flash and no PSRAM; NOT the -V (1.8 V) variants (R8V/R16V); the listed boards are a 2x USB-C DevKitC-1 clone ("ESP32-23 V1.3", same pin order) with the RGB LED on GPIO48 = BUZZER (leave its RGB jumper open); measure header row spacing on arrival; Tokopedia: Rajacell ESP32-S3 N8R2 (~Rp112.5k; N16R8 sold out 23 Oct), ordered with the motors | Motion controller | Tokopedia | To order | 2026-10-08 |  | v0.1.28
P17 | TMC2209 StepStick driver | Robot electronics | 5 | 15 | BTT v1.3 / FYSETC style, UART on PDN pin; 4 + 1 spare; Tokopedia: MKS TMC2209 V2.0, ~Rp49k each (UART on pin 5: JP1-JP4 are bridged on the board by default) | Motion board U2-U5 | Tokopedia | To order | 2026-10-08 |  | v0.1.28
P18 | Buck converters + charger | Robot electronics | 1 | 4 | 5 V / 5 A buck (Pi + board), 5.8 V / 3 A buck (servos; MG90S max 6.0 V), CC/CV 16.8 V / 1.5 A charger (XL4015-type); on arrival check charger IN- to OUT- (low-side shunt) before wiring; Tokopedia: XY-3606 5 V/5 A fixed (EasyWare), 2 x XL4015 5 A CC/CV (CNC Store Bandung): one as the charger, one set to 5.8 V CV with CC at max for the servos (the MP2482/SY8205 module is fixed at 5 V); ~Rp69k total | Robot power | Tokopedia | To order | 2026-10-08 |  | v0.1.29
P19 | INA226 module | Robot electronics | 1 | 2 | Must be the 10 mOhm (R010) shunt version, +/-8 A; many listings ship R100 (+/-0.8 A); Local modules ship the R100 shunt: buy any INA226 module (~Rp22k) + a 2512 R010 1 % shunt (WKH Elektronik, ~Rp3k) and swap the shunt before use | Energy logging | Tokopedia | To order | 2026-10-08 |  | v0.1.13
P20 | Battery: 4S1P 18650 pack | Robot electronics | 1 | 33 | 4 x 18650 3.5 Ah (Samsung 35E / LG MJ1) + 4S BMS >= 15 A + nickel strip = 50.4 Wh; cells from a local battery shop (genuine ~Rp100-140k each; they spot-weld the pack); 4S 30 A BMS from Rajacell (~Rp27k); pure nickel strip 0.12 x 8 mm from CNC Store Bandung (~Rp21k / 10 m) | Robot power (airline < 100 Wh) | Local store | To order | 2026-10-08 |  | v0.1.17
P21 | Connectors & wiring | Robot electronics | 1 | 25 | XT60 pair and XT30 pair as ready-made pigtails (leads soldered at the factory, red/black, 14-16 AWG; removes the main reverse-polarity risk), 7.5 A blade fuse (+ spares) + holder, 10 A rocker switch, robot E-stop (mushroom, twist release, 1 NO + 1 NC: NC switches the VMOT relay coil, NO to motion board J13 so the firmware sees a press at once), SS54, silicone wire 18/22/26 AWG, JST-XH crimp kit; Tokopedia: XT30/XT60 (teknoza), JST-XH 230 pcs kit (easy-go-512), robot E-stop LA38-11ZS 22 mm self-locking (CNC Store Bandung ~Rp14k; use both contacts); 16 A 3-pin rocker switch (CNC Store Bandung ~Rp3k); 18 AWG silicone wire (alladinshop ~Rp7.4k/m); blade fuse + inline holder and SS54 from a local electronics shop | Robot power + harness | Tokopedia | To order | 2026-10-08 |  | v0.1.26
P22 | Motion PCB (JLCPCB) | Robot electronics | 5 | 40 | pcb/motion-board/fab/rbg3-motion-gerbers.zip; 2 layers, 1.6 mm, 1 oz, 100x100 mm; + Economic SMD assembly of 2 boards (45 parts: fab/rbg3-motion-jlc-bom.csv + -jlc-cpl.csv; Q1/D1/D2 orientation checked in the preview); ordered 23 Oct, FedEx, paid 32 USD after discount (43 USD list) incl. assembly, extended-part fees and shipping | Motion board | JLCPCB | Ordered | 2026-10-14 |  | v0.1.27
P23 | Motion PCB components | Robot electronics | 1 | 5 | Per pcb/motion-board/fab/rbg3-motion-bom.csv, through-hole parts (the SMD parts, 0805 R/C, SMBJ18A, MMBT3904 and 1N4148W, are assembled by JLCPCB on 2 boards, P22; buy them only to build a bare spare): StepStick sockets 2x8 (x8), 1x22 female headers (x2), 1x3 male headers (x2, servo), 100 µF/35 V (x4), 470 µF/35 V, 220 µF/25 V (servo rail), JST-XH 2/3/4-pin, 5.08 terminals (x2), XT30PW-M, WS2812, buzzer; Tokopedia, itemised in docs/sourcing-options.md §3.1: Putra Niaga Bandung (passives, THT elcos incl. 470 µF and 220 µF/25 V, SMBJ18A, MMBT3904, 5.08 terminals, 1x40 female + male headers); buzzer from CNC Store Bandung; XT30PW-M, 1N4148W and WS2812 from other shops; JST-XH board headers from the P21 kit; ~Rp55k + shipping | Motion board | Tokopedia | To order | 2026-10-08 |  | v0.1.25
P24 | Delta 24 V DIN-rail PSU | Rack electrical | 1 | 39 | 24 V, >= 75 W, universal 100-240 VAC input; chosen: Delta LYTE II DRL-24V120W1EN (24 V / 5 A, 120 W); Mitra Otomasi ~Rp622k or the Delta distributor | Rack power + charging dock (spare station) | Delta distributor | To order | 2026-10-08 |  | v0.1.22
P25 | Delta DVP-12SE11T PLC | Rack electrical | 1 | 0 | 8 DI / 4 DO (NPN), Ethernet Modbus TCP; any DVP-SE/AS with Ethernet OK. Loan requested; backup if it fails: Tokopedia DVP12SE11T ~Rp2.6-3.3M (~165-210 USD, e.g. panelplcinverter Rp2.62M); not in the budget | Rack controller | Delta loan | To order | 2026-10-13 |  | v0.1.16
P26 | DIN rail + terminal blocks + relay | Rack electrical | 1 | 5 | 35 mm DIN rail ~250 mm, terminal blocks, 24 V relay module (>= 5 A), UK5-HESI fuse terminal + 3.15 A slow-blow 5x20 fuse (+ spare) on the dock + line; Tokopedia, CNC Store Bandung: DIN rail 1 m (~Rp18k, cut), UK5N terminal blocks x10 (~Rp25k), 24 V relay module (~Rp27k, Songle SRD relay); UK5-HESI + 5x20 fuses from the same shop or a local electrical store (no local polyfuse rated >= 30 V was found, so the fuse terminal replaces it) | Rack electronics | Tokopedia | To order | 2026-10-08 |  | v0.1.28
P27 | Rack status lamps (R/Y/G) | Rack electrical | 1 | 3 | v0.1.27: replaces the tower light. 3 x 22 mm panel indicator lamps AD16-22DS, 24 V DC LED (red, yellow, green; EWIG ~Rp6-7.5k each) in a 3-hole 22 mm plastic control box (~Rp20k); common +24 V, sunk by Y1-Y3 | Rack status | Tokopedia | To order | 2026-10-23 |  | v0.1.27
P28 | Rack E-stop | Rack electrical | 1 | 3 | Mushroom, 2 x NC contacts; Tokopedia: 22 mm E-stop + box + gland (~Rp32k); confirm 2 x NC or add a second NC contact block | Rack safety + dock power interlock | Tokopedia | To order | 2026-10-08 |  | v0.1.13
P29 | 24 V to 5 V USB buck | Rack electrical | 1 | 0 | Not needed (v0.1.27): the travel router is dropped; the ESP32 rack controller buck is part of P40 | Travel router power | Tokopedia | Not needed |  |  | v0.1.27
P30 | Dock contacts + station cables | Rack electrical | 1 | 9 | Brass strip or 10 mm pogo pins, copper sheet for robot pads, 4-core signal cable ~1.5 m (+24 V, X4, X6, X7), 2-core 0.75 mm2 dock power lead ~1.5 m (rack relay to the spare-station dock, ~Rp15k); brass sheet 0.5 mm from a hardware store (online: soember-suksess 10 x 10 cm ~Rp22k) | Charging dock at the spare station, spare-station switches | Local store | To order | 2026-10-08 |  | v0.1.22
P31 | Travel router | Rack electrical | 1 | 0 | Not needed (v0.1.27): the Raspberry Pi is the Wi-Fi access point (AP RACKBOT) and the ESP32 rack controller joins it. If the Delta PLC loan comes through after all, its Ethernet port needs a Wi-Fi client bridge (borrow any router that supports client/WISP mode) | Rack Wi-Fi network | Tokopedia | Not needed |  |  | v0.1.27
P32 | PETG filament | Printing & demo | 2 | 36 | 2 kg | Structural printed parts | Local store | To order | 2026-10-08 |  | v0.1.5
P33 | PLA filament | Printing & demo | 1 | 15 | 1 kg | Dummy drives, tag carriers | Local store | To order | 2026-10-08 |  | v0.1.5
P34 | TPU 95A filament | Printing & demo | 1 | 8 | 0.25 kg; only if printing tires / bumper strip | Wheel tires, nose strip | Local store | To order | 2026-10-08 |  | v0.1.5
P35 | Steel ballast + epoxy | Printing & demo | 1 | 8 | ~530 g steel per dummy drive x 6 | Dummy drives | Local store | To order | 2026-10-08 |  | v0.1.5
P36 | Tag/label printing + table mat | Printing & demo | 1 | 10 | AprilTag tag36h11 + QR labels, matte vinyl; >= 1200x600 mat | Rack, spare station, caddies, arena | Local store | To order | 2026-10-08 |  | v0.1.5
P37 | USB-A to USB-C cable, right-angle C end | Robot electronics | 1 | 2 | 0.3 m, data-capable; 90° USB-C plug with the cable exiting up/away from the board (a straight plug hits connectors J10/J11); Tokopedia: USB-A to USB-C 90° L-shape data cable (~Rp29k); local ones are 1 m, coil the excess | Pi 3 -> ESP32 DevKit (power + serial) | Tokopedia | To order | 2026-10-08 |  | v0.1.13
P38 | VMOT relay (E-stop) | Robot electronics | 1 | 2 | 12 V automotive relay, SPST-NO 30/40 A, 4-pin, with socket/pigtail; + 1N4007 flyback diode across the coil; Tokopedia: Bosch 12 V 4-pin relay + ceramic socket (~Rp23k) | Robot E-stop: the E-stop opens the coil, the contact cuts VMOT | Tokopedia | To order | 2026-10-08 |  | v0.1.13
P39 | Claude Pro, 1 month | Printing & demo | 1 | 23 | Claude Pro subscription for 1 month, Rp360k (~23 USD at Rp16k/USD) | Design, CAD, firmware and documentation work | Anthropic (claude.ai) | To order |  |  | v0.1.27
P40 | ESP32 rack controller (PLC fallback) | Rack electrical | 1 | 18 | Contingency, likely needed (no PLC access expected): ESP32 DevKit V1 WROOM-32 30-pin (~Rp75k) + 8-ch 24 V to 3.3 V optocoupler input board (~Rp150k, thana maju / Lisu Instrument) + 2x dual MOSFET D4184 module, 3.3 V trigger, 5-36 V 15 A (~Rp15k each; low-side, same sinking wiring as the PLC NPN outputs) + 24 V to 5 V buck (~Rp15k); same Modbus TCP register map as the PLC (02 §4.4). Order with the 23 Oct batch unless the PLC loan is confirmed | Rack controller if no PLC (X0-X7, Y0-Y3) | Tokopedia | To order | 2026-10-23 |  | v0.1.27
P41 | Harness extras (robot) | Robot electronics | 1 | 6 | GPIO power lead for the Pi 3 (5 V buck -> header pins 2/4 + GND 6, 2 x 0.5 mm² into a 3-pin female Dupont housing; the micro-USB faces the battery box, 02 §2), servo extension leads 30 cm (x3), stepper extension cables 1 m (x2, only if the bought motor leads don't reach the board from the Z/Y carriages), heat-shrink assortment, Pi 3 heatsink set; Tokopedia, ~Rp100k total | Robot harness | Tokopedia | To order | 2026-10-24 |  | v0.1.31
P42 | Cable carrier (drag chain) 7x7 mm, 1 m | Robot mechanical | 1 | 2 | 7x7 or 10x10 mm plastic drag chain, 1 m, with end mounts (zip-tie to the mast and carriage); carries the Y motor, servo, switch and camera leads over 193 mm of Z travel; Tokopedia ~Rp30k | Z/Y moving harness | Tokopedia | To order | 2026-10-24 |  | v0.1.28
P43 | JST-XH crimp tool | Robot electronics | 1 | 7 | SN-28B or SN-2549 ratchet crimper for JST-XH / Dupont pins (the P21 kit has housings and pins only); skip if the team or lab has one; Tokopedia ~Rp100k | Robot harness | Tokopedia | To order | 2026-10-24 |  | v0.1.28
P44 | Tethered power lead (battery fallback) | Rack electrical | 1 | 2 | 2 m 2-core 0.75 mm2 lead with an XT60 female pigtail, from the rack 24 V to the robot charger input (~25 W); risk R7 fallback if the pack can't fly (04 §3); ~Rp30k | Robot power without the battery | Local store | To order | 2026-10-24 |  | v0.1.28
