freethought101/RackBotGen3/pcb/motion-board/fab/rbg3-motion-bom.csv

Reference | Value | Footprint | QUANTITY | DNP
C1,C3,C5,C7 | 100uF 35V | Capacitor_THT:CP_Radial_D8.0mm_P3.50mm | 4
C2,C4,C6,C8,C10-C17,C19,C21,C23 | 100nF | Capacitor_SMD:C_0805_2012Metric | 15
C9 | 470uF 35V | Capacitor_THT:CP_Radial_D10.0mm_P5.00mm | 1
C18 | 220uF 25V | Capacitor_THT:CP_Radial_D8.0mm_P3.50mm | 1
C20,C22 | 10uF | Capacitor_SMD:C_0805_2012Metric | 2
D1 | SMBJ18A | Diode_SMD:D_SMB | 1
D2 | 1N4148W | Diode_SMD:D_SOD-123 | 1
J1 | VMOT_IN XT30 (after E-stop) | Connector_AMASS:AMASS_XT30PW-M_1x02_P2.50mm_Horizontal | 1
J2 | 5V_IN (from 5V buck) | TerminalBlock_Phoenix:TerminalBlock_Phoenix_MKDS-1,5-2-5.08_1x02_P5.08mm_Horizontal | 1
J3 | 6V_SERVO_IN (from 6V buck) | TerminalBlock_Phoenix:TerminalBlock_Phoenix_MKDS-1,5-2-5.08_1x02_P5.08mm_Horizontal | 1
J4 | MOTOR_L | Connector_JST:JST_XH_B4B-XH-A_1x04_P2.50mm_Vertical | 1
J5 | MOTOR_R | Connector_JST:JST_XH_B4B-XH-A_1x04_P2.50mm_Vertical | 1
J6 | MOTOR_Z | Connector_JST:JST_XH_B4B-XH-A_1x04_P2.50mm_Vertical | 1
J7 | MOTOR_Y | Connector_JST:JST_XH_B4B-XH-A_1x04_P2.50mm_Vertical | 1
J8 | SW_Z_HOME | Connector_JST:JST_XH_B3B-XH-A_1x03_P2.50mm_Vertical | 1
J9 | SW_Y_HOME | Connector_JST:JST_XH_B3B-XH-A_1x03_P2.50mm_Vertical | 1
J10 | SW_NOSE | Connector_JST:JST_XH_B3B-XH-A_1x03_P2.50mm_Vertical | 1
J11 | SW_SLOT_A | Connector_JST:JST_XH_B3B-XH-A_1x03_P2.50mm_Vertical | 1
J12 | SW_SLOT_B | Connector_JST:JST_XH_B3B-XH-A_1x03_P2.50mm_Vertical | 1
J13 | SW_AUX_IN | Connector_JST:JST_XH_B3B-XH-A_1x03_P2.50mm_Vertical | 1
J14 | SERVO_A (GND,6V,SIG) | Connector_PinHeader_2.54mm:PinHeader_1x03_P2.54mm_Vertical | 1
J15 | SERVO_B (GND,6V,SIG) | Connector_PinHeader_2.54mm:PinHeader_1x03_P2.54mm_Vertical | 1
J16 | I2C INA226 (3V3,GND,SDA,SCL) | Connector_JST:JST_XH_B4B-XH-A_1x04_P2.50mm_Vertical | 1
J17 | WS2812 (5V,DIN,GND) | Connector_JST:JST_XH_B3B-XH-A_1x03_P2.50mm_Vertical | 1
J18 | DOCK_V+ (dock + pad, before SS54; pin 2 NC) | Connector_JST:JST_XH_B2B-XH-A_1x02_P2.50mm_Vertical | 1
J19 | BUZZER (5V, low-side) | Connector_JST:JST_XH_B2B-XH-A_1x02_P2.50mm_Vertical | 1
Q1 | MMBT3904 | Package_TO_SOT_SMD:SOT-23 | 1
R1,R3 | 100k | Resistor_SMD:R_0805_2012Metric | 2
R2 | 18k | Resistor_SMD:R_0805_2012Metric | 1
R4,R5,R7,R9,R11,R13,R15,R17,R25 | 10k | Resistor_SMD:R_0805_2012Metric | 9
R6,R8,R10,R12,R14,R16,R18,R24 | 1k | Resistor_SMD:R_0805_2012Metric | 8
R19,R20,R23 | 330 | Resistor_SMD:R_0805_2012Metric | 3
R21,R22 | 4.7k | Resistor_SMD:R_0805_2012Metric | 2
U1 | ESP32-S3-DevKitC-1 | rbg3:ESP32-S3-DevKitC-1_Socket | 1
U2 | TMC2209 DRV_L addr0 | Module:Pololu_Breakout-16_15.2x20.3mm | 1
U3 | TMC2209 DRV_R addr1 | Module:Pololu_Breakout-16_15.2x20.3mm | 1
U4 | TMC2209 Z addr2 | Module:Pololu_Breakout-16_15.2x20.3mm | 1
U5 | TMC2209 Y addr3 | Module:Pololu_Breakout-16_15.2x20.3mm | 1
