freethought101/RackBotGen3/docs/datasheets/P16_esp32-s3-devkitc-1_reference-design/05_BOM/BOM(V0.3)_ESP32-S3-DevKitC-1_XX_TTNNVV.xlsx

BOM(V0.3)_ESP32-S3-DevKitC-1
Item Number | Quantity | Part Reference | Value | PCB Footprint | Part Type | Description | Manufacturer | Manufacturer Part #
1 | 3 | C2,C8,C9 | 0.1uF/50V(10%) | C0402 | Capacitor | MLCC, X5R, H0.5, -55℃~85℃ | EYANG | C0402X5R104K500NTC
 |  |  |  |  | Capacitor | MLCC, X5R, H0.5, -55℃~85℃ | Sumsang | CL05A104KB5NNNC
 |  |  |  |  | Capacitor | MLCC, X7R, H0.5, -55℃~125℃ | muRata | GRM155R71H104KE14D
2 | 2 | C6,C12 | 1uF/16V(10%) | C0402 | Capacitor | MLCC, X6S, H0.5, -55℃~105℃ | muRata | GRM155C81C105KE11D
3 | 5 | C1,C3,C7,C10,C11 | 10uF/25V(20%) | C0603 | Capacitor | MLCC, X5R, H0.8, -55℃~85℃ | muRata | GRM188R61E106MA73D
4 | 5 | R7,R8,R9,R13,R17 | 0(1%) | R0402 | Resistor | Thick Film Resistors, SMD, 0(1%), 1/16w, H0.35, -55℃~155℃ | UniOhm | 0402WGF0000TCE
 |  |  |  |  | Resistor | Thick Film Resistors, SMD, 0(1%), 1/16w, H0.35, -55℃~155℃ | YAGEO | RC0402FR-070RL
5 | 1 | R24 | 0(1%) | R0603 | Resistor | Thick Film Resistors, SMD, 1, 1/10w, H0.45, -55℃~155℃ | UniOhm | 0603WAF0000T5E
 |  |  |  |  | Resistor | Thick Film Resistors, SMD, , 1/10w, H0.45, -55℃~155℃ | YAGEO | RC0603FR-070RL
6 | 1 | R16 | 1K(1%) | R0402 | Resistor | Thick Film Resistors, SMD, 1K(1%), 1/16w, H0.35, -55℃~155℃ | UniOhm | 0402WGF1001TCE
 |  |  |  |  | Resistor | Thick Film Resistors, SMD, 1K(1%), 1/16w, H0.35, -55℃~155℃ | YAGEO | RC0402FR-071KL
7 | 1 | R11 | 5.1K(1%) | R0402 | Resistor | Thick Film Resistors, SMD, 5.1K(1%), 1/16w, H0.35, -55℃~155℃ | UniOhm | 0402WGF5101TCE
 |  |  |  |  | Resistor | Thick Film Resistors, SMD, 5.1K(1%), 1/16w, H0.35, -55℃~155℃ | YAGEO | RC0402FR-075K1L
8 | 3 | R5,R10,R12 | 10K(1%) | R0402 | Resistor | Thick Film Resistors, SMD, 10K(1%), 1/16w, H0.35, -55℃~155℃ | UniOhm | 0402WGF1002TCE
 | 3 | R5,R10,R12 |  |  | Resistor | Thick Film Resistors, SMD, 10K(1%), 1/16w, H0.35, -55℃~155℃ | YAGEO | RC0402FR-0710KL
9 | 1 | R19 | 22.1K(1%) | R0402 | Resistor | Thick Film Resistors, SMD, 22.1K(1%), 1/16w, H0.35, -55℃~155℃ | UniOhm | 0402WGF2212TCE
 |  |  |  |  | Resistor | Thick Film Resistors, SMD, 22.1K(1%), 1/16w, H0.35, -55℃~155℃ | YAGEO | RC0402FR-0722K1L
10 | 1 | R18 | 47.5K(1%) | R0402 | Resistor | Thick Film Resistors, SMD, 47.5K(1%), 1/16w, H0.35, -55℃~155℃ | UniOhm | 0402WGF4752TCE
 |  |  |  |  | Resistor | Thick Film Resistors, SMD, 47.5K(1%), 1/16w, H0.35, -55℃~155℃ | UniOhm | 0402WGF4752TCE
11 | 2 | D1,D7 | 1N5819HW-7-F | SOD123 | Diode | Schottky Barrier Diodes,Vrms=40V,If=1.0A,Vf=0.45V,Ifsm=25A, H1.35, Tj-65℃~+125℃ | Diodes Incorporated | 1N5819HW-7-F
12 | 6 | D2,D3,D4,D8,D9,D10 | LESD5D5.0CT1G | SOD523 | Diode | ESD,Bidirectional,Vrwm=5.0V,Vbr=7.8V,Cd=15pF, H0.7, -40℃~+125℃ | LRC | LESD5D5.0CT1G
13 | 1 | D5 | RED LED | LED0603 | Diode | Light-Emitting Diode:Red LED, IF=25mA, VR=5V, 65mW, H0.6, -30℃~85℃ | NationStar | FC-DA1608HRK-620D
 |  |  |  |  | Diode | Light-Emitting Diode:Red LED, IF=20mA, VR=5V, 50mW, H0.6, -40℃~85℃ | 贝益达电子 | BD-PT0603R6C-C01-4T
14 | 1 | D6 | SK68XXMINI-HS | LED3535B | Diode | Light-Emitting Diode: 1-wire RGB: Intelligent Control LED Integrated Light Source, 3535, H1.9, -25℃~85℃ | Worldsemi | WS2812B-Mini-V3
15 | 2 | J1,J3 | CON22X1 | CON22X1_2P54 | Connector | Male Pin Header, 单排排针, 22Pins, 间距 2.54mm, 镀金 1U | - | -
16 | 2 | J2,J4 | MICRO USB | USB_5P_MICRO_F_ML | Connector | Micro USB 5P,Female, 4-DipLeg, H3.0, -30℃~+85℃ | 敏乐 | 1110-205001
 |  |  |  |  | Connector | Micro USB 5P,Female, B Type, 插板7.2有柱, 脚长1.1, 四脚全插, 加长0.75（卷边）, H2.61, -30℃~+80℃ | U-wilcome | I42-0531-3121
17 | 2 | Q1,Q2 | L8050QLT1G | SOT23-3 | Transistor | NPN,Ic.max=0.8A,Vbe(sat)=0.5V@Ic=800mA&Ib=80mA, H1.11, Tj-55℃~+150℃ | LRC | L8050QLT1G
18 | 2 | SW1,SW2 | NTC013-AT1J-A160T | SW4-4P2X3P2X2P5-SMT | Tact Switch | Tact Switch: SMT, 4P, operation force 1.57N, Stem Black Color, 4.2x3.2x2.5, SMD, -40℃~85℃ | TAIWAN MISAKI | NTC013-AT1J-A160T
19 | 1 | U2 | SGM2212-3.3XKC3G/TR | SOT223 | Power ICs | LDO,Input.max=20V,Iout.max=800mA,Fixed-Output=3.3V,Vdrop=0.42V@Iout=0.8A,H1.8,-40~+125°C | SG Micro | SGM2212-3.3XKC3G/TR
20 | 1 | U3 | CP2102N-A02-GQFN28 | QFN28_0P5_5 | Interface ICs | USB-TO-UART,USB2.0 full speed,data rate up to 3Mbaud,H0.8, -40°C~+85°C | SiliconLabs | CP2102N-A02-GQFN28
21 | 1 | U4 | ESP32-S3-WROOM-1 | ESP32-S3-WROOM_NEW | Module | 根据客供模组型号进行贴件 | Espressif Systems | ESP32-S3-WROOM-1/ESP32-S3-WROOM-2
22 | 1 | PCB | - | - | - | ESP32-S3-DevKitC-1_V1.1_20220429, 2L, 62.74*25.4*1.6mm, 哑光黑色阻焊, 白色字符, 化学沉金,USB 走线 90R 阻抗管控 | - | -
