freethought101/RackBotGen3/docs/3d-models/P04_mini-v-wheel_delrin-assembly_openbuilds.step

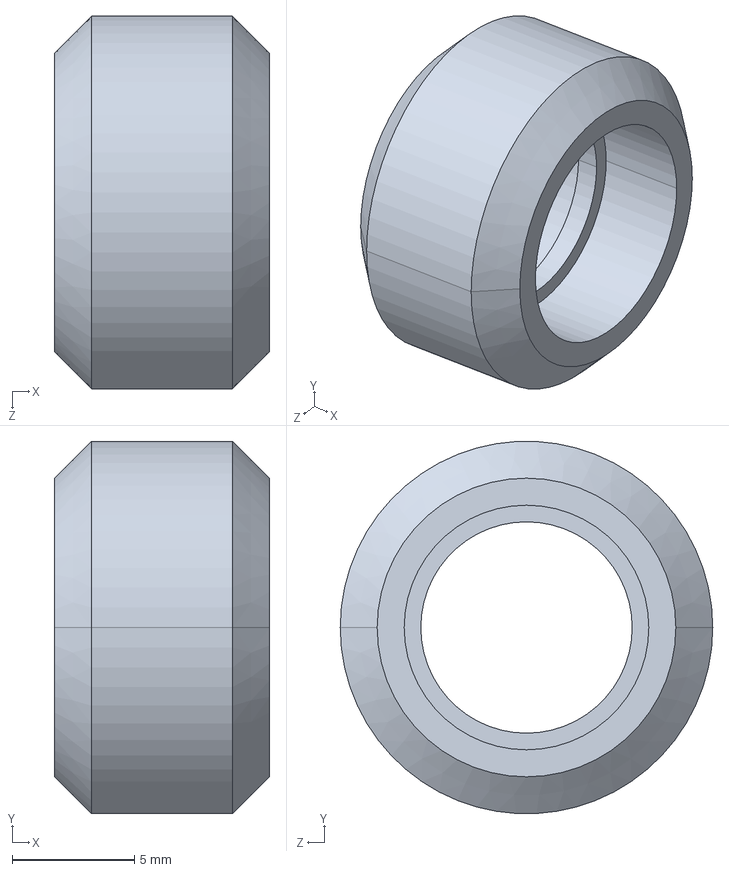
[picture p59: CAD file, 2026-10-25]
docs/3d-models/P04_mini-v-wheel_delrin-assembly_openbuilds.step
8.80 x 15.2 x 15.2 mm
