freethought101/RackBotGen3/cad/DXF/robot/deck.dxf

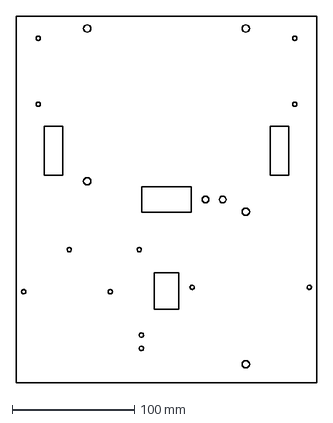
[picture p60: CAD file, 2026-11-02]
cad/DXF/robot/deck.dxf
246.0 x 300.0 mm
