freethought101/RackBotGen3/docs/datasheets/P16_esp32-s3-devkitc-1_v1.1_dimensions.dxf

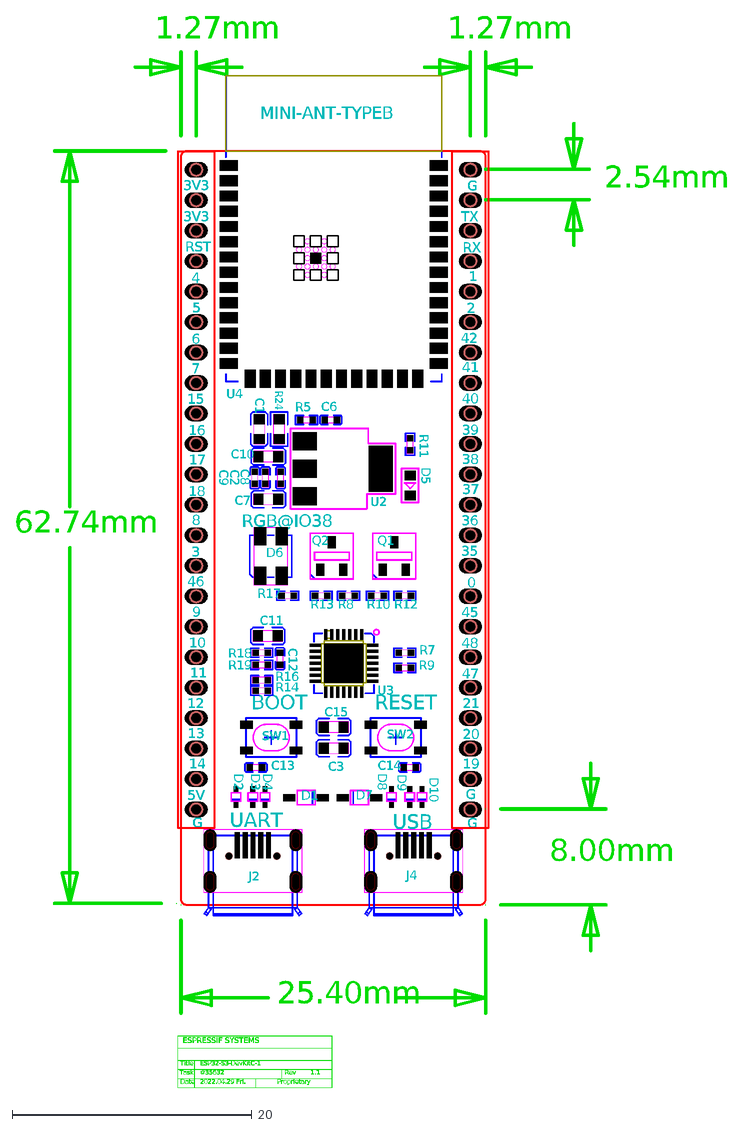
[picture p61: CAD file, 2026-10-25]
docs/datasheets/P16_esp32-s3-devkitc-1_v1.1_dimensions.dxf
BOOT
RGB@IO38
Date
Task
Title
ESPRESSIF SYSTEMS
Proprietary
2022.04.29 Fri.
#35632
ESP32-S3-DevKitC-1
1.1
Rev
UART
USB
RESET
3V3
RST
4
5
6
7
15
16
17
18
8
3
46
9
10
11
12
13
14
5V
G
TX
RX
19
20
21
47
48
45
35
36
0
40
39
38
37
1
2
42
41
62.74mm
1.27mm
2.54mm
25.40mm
8.00mm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
