freethought101/RackBotGen3/pcb/motion-board/fab/rbg3-motion.step

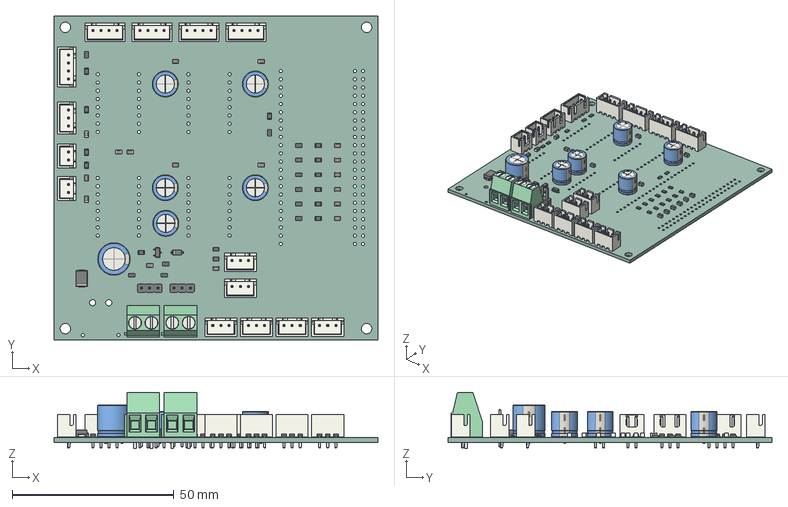
[picture p62: CAD file, 2026-10-23]
pcb/motion-board/fab/rbg3-motion.step
100.0 x 100.0 x 17.3 mm
JST_B3B_XH_A x 7
JST_B4B_XH_A x 5
JST_B2B_XH_A x 2
C_0805_2012Metric x 17
CP_Radial_D80mm_P350mm x 5
R_0805_2012Metric x 25
SOT-23
CP_Radial_D100mm_P500mm
D_SMB
TerminalBlock_Phoenix_MKDS-1,5-2-5.08_1x02_P5.08mm_Horizontal x 2
PinHeader_1x03_P254mm_Vertical x 2
D_SOD-123
rbg3-motion_PCB
