freethought101/RackBotGen3/docs/3d-models/P10_kw11-3z-hinge-lever.step

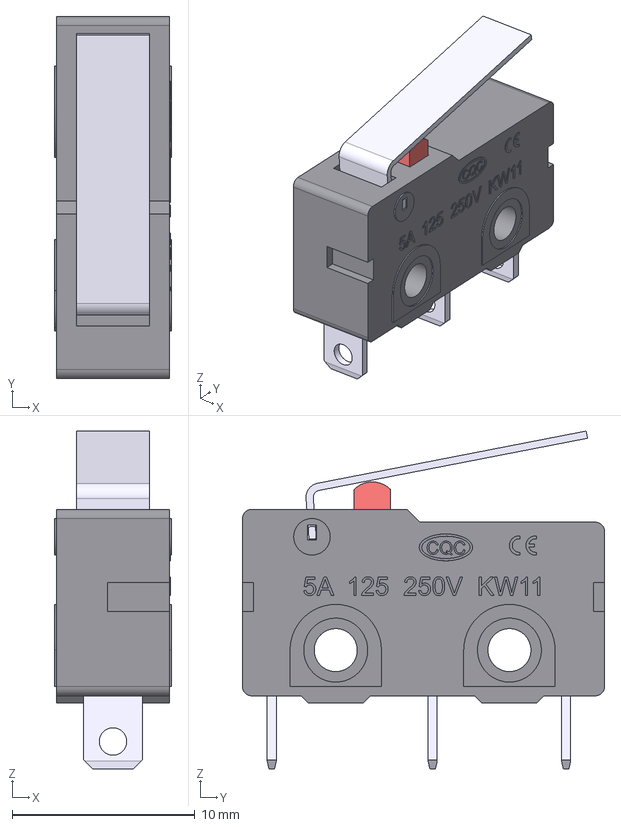
[picture p63: CAD file, 2026-10-28]
docs/3d-models/P10_kw11-3z-hinge-lever.step
6.40 x 19.8 x 18.5 mm
Knob
blade001
blade002
blade003
Body_w_text
Hinge_lever
