freethought101/RackBotGen3/docs/3d-models/P02_vslot_2020_l0300_openbuilds.step

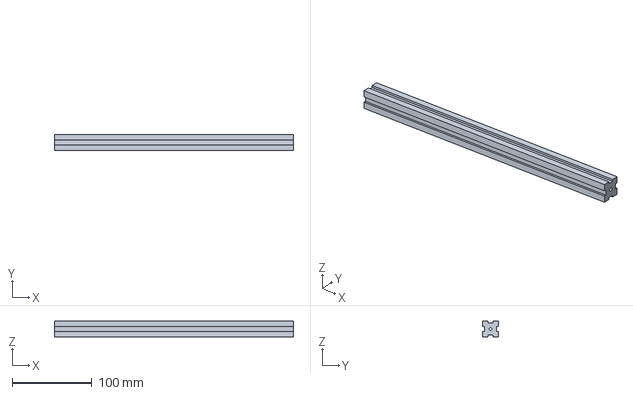
[picture p64: CAD file, 2026-10-28]
docs/3d-models/P02_vslot_2020_l0300_openbuilds.step
300.0 x 20.0 x 20.0 mm
