freethought101/RackBotGen3/docs/3d-models/P12_raspberry-pi-3b.step

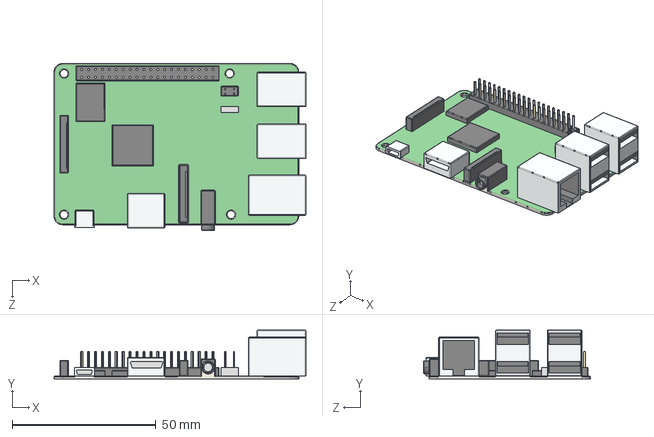
[picture p65: CAD file, 2026-10-28]
docs/3d-models/P12_raspberry-pi-3b.step
87.5 x 17.0 x 58.0 mm
