freethought101/RackBotGen3/docs/3d-models/P03_vslot_2040_l0500_openbuilds.step

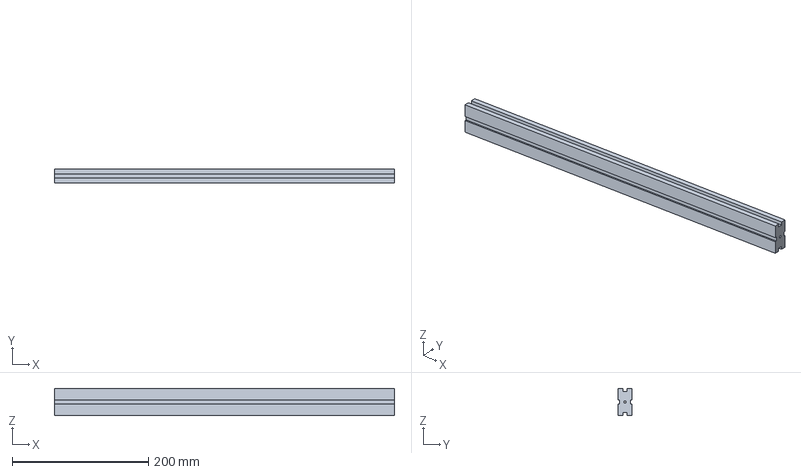
[picture p66: CAD file, 2026-10-28]
docs/3d-models/P03_vslot_2040_l0500_openbuilds.step
500.0 x 20.0 x 40.0 mm
