freethought101/RackBotGen3/docs/3d-models/P01_nema17_openbuilds.step

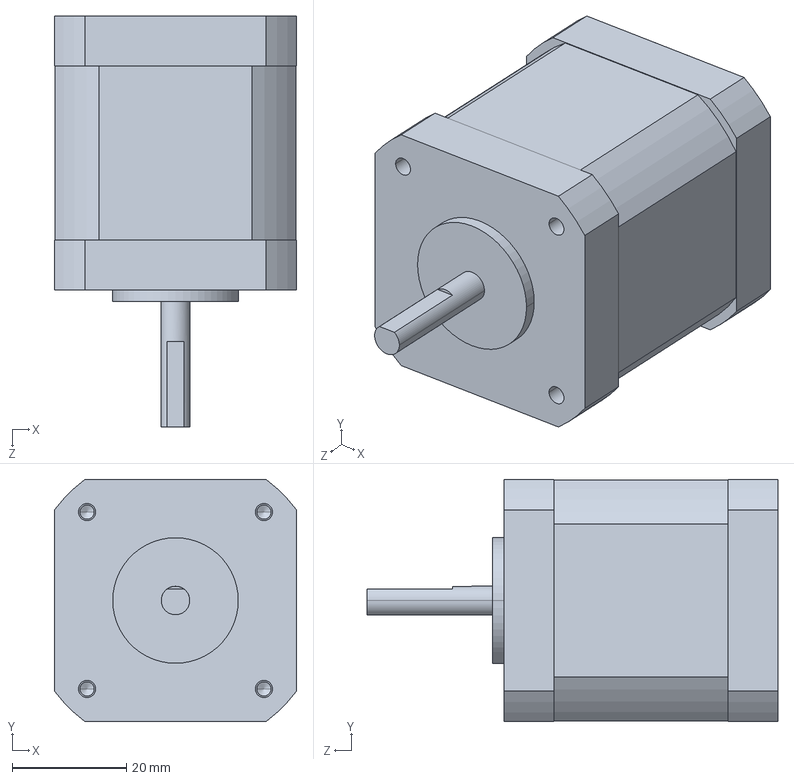
[picture p67: CAD file, 2026-10-25]
docs/3d-models/P01_nema17_openbuilds.step
42.4 x 42.4 x 72.0 mm
