freethought101/RackBotGen3/docs/3d-models/P10_micro-limit-switch_openbuilds.step

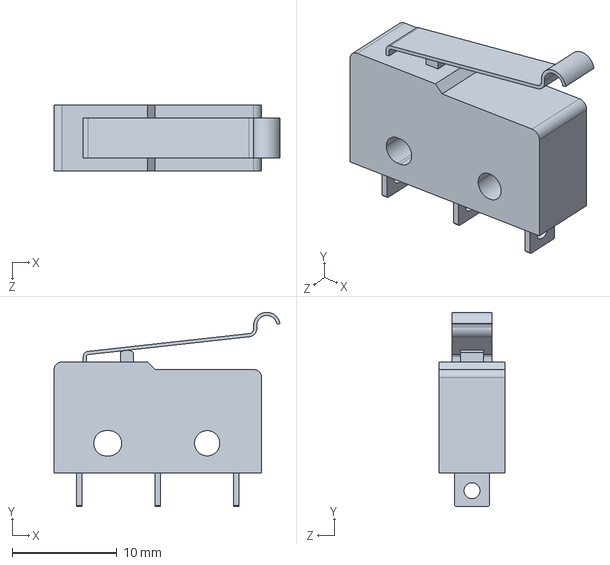
[picture p68: CAD file, 2026-10-25]
docs/3d-models/P10_micro-limit-switch_openbuilds.step
21.6 x 18.6 x 6.35 mm
