freethought101/RackBotGen3/docs/3d-models/P04_mini-eccentric-spacer-6mm_openbuilds.step

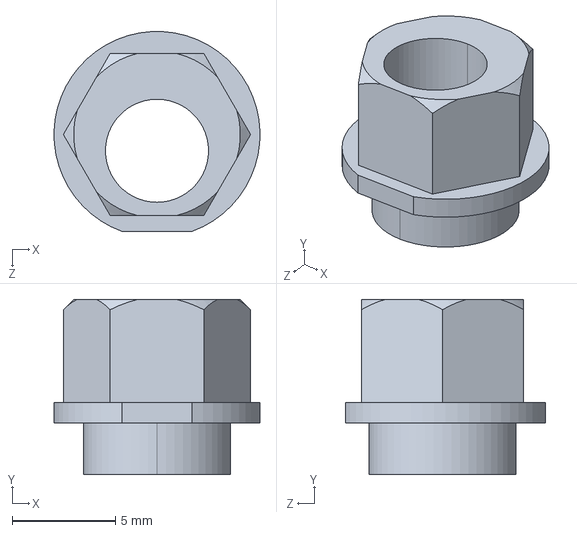
[picture p69: CAD file, 2026-10-25]
docs/3d-models/P04_mini-eccentric-spacer-6mm_openbuilds.step
10.00 x 8.50 x 9.69 mm
