freethought101/RackBotGen3/docs/3d-models/P06_idler-smooth_openbuilds.step

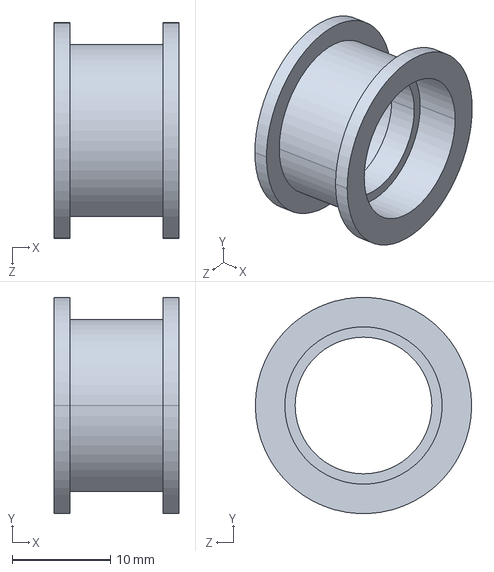
[picture p70: CAD file, 2026-10-25]
docs/3d-models/P06_idler-smooth_openbuilds.step
12.7 x 22.0 x 22.0 mm
