freethought101/RackBotGen3/docs/3d-models/P04_precision-shim-8x5x1_openbuilds.step

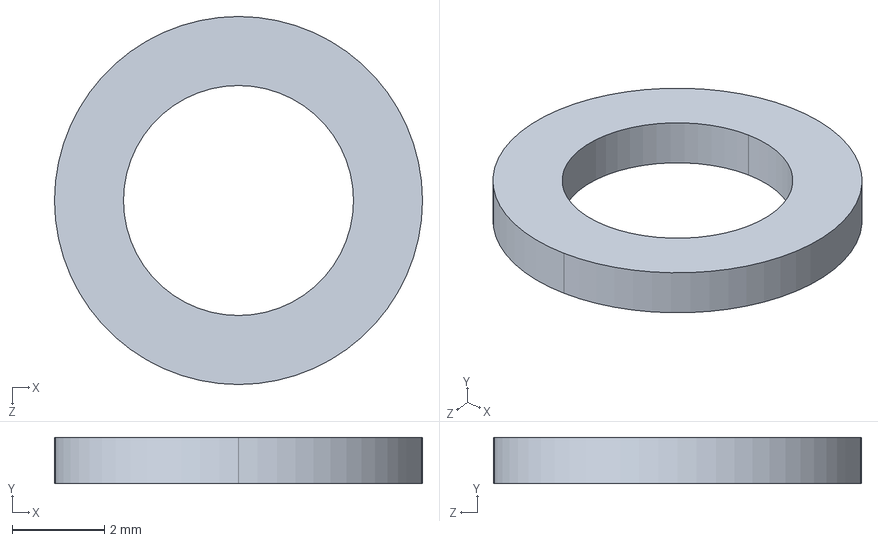
[picture p71: CAD file, 2026-10-25]
docs/3d-models/P04_precision-shim-8x5x1_openbuilds.step
8.00 x 1.00 x 8.00 mm
