freethought101/RackBotGen3/docs/3d-models/P05_kfl08.step

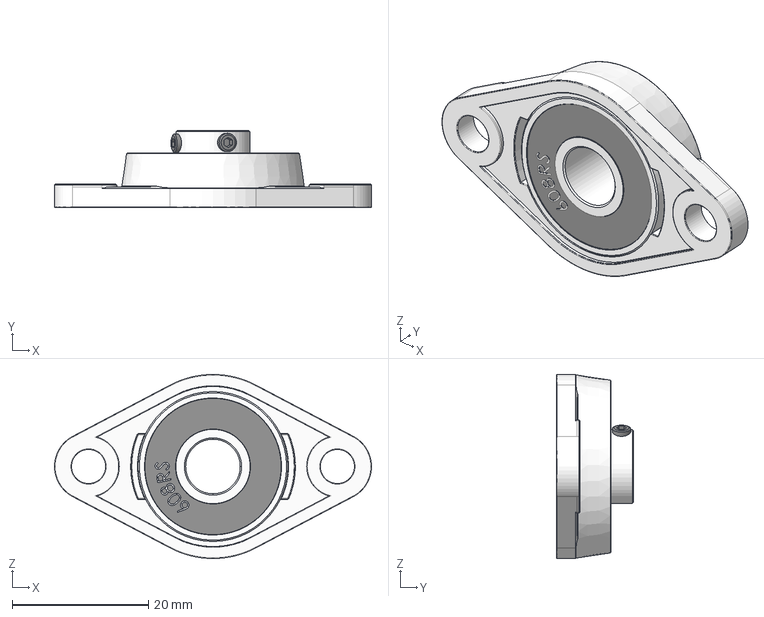
[picture p73: CAD file, 2026-10-25]
docs/3d-models/P05_kfl08.step
46.5 x 11.4 x 27.0 mm
