freethought101/RackBotGen3/docs/3d-models/P04_spacer-6mm_openbuilds.step

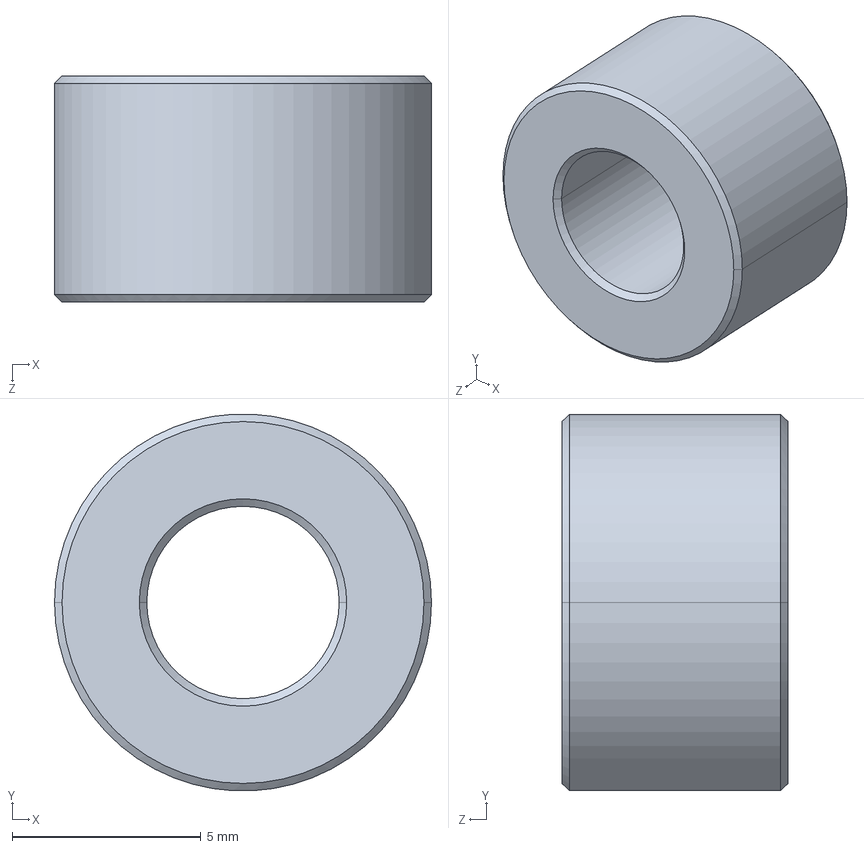
[picture p74: CAD file, 2026-10-25]
docs/3d-models/P04_spacer-6mm_openbuilds.step
10.0 x 9.99 x 6.00 mm
