freethought101/RackBotGen3/docs/3d-models/P04_bearing-105zz_openbuilds.step

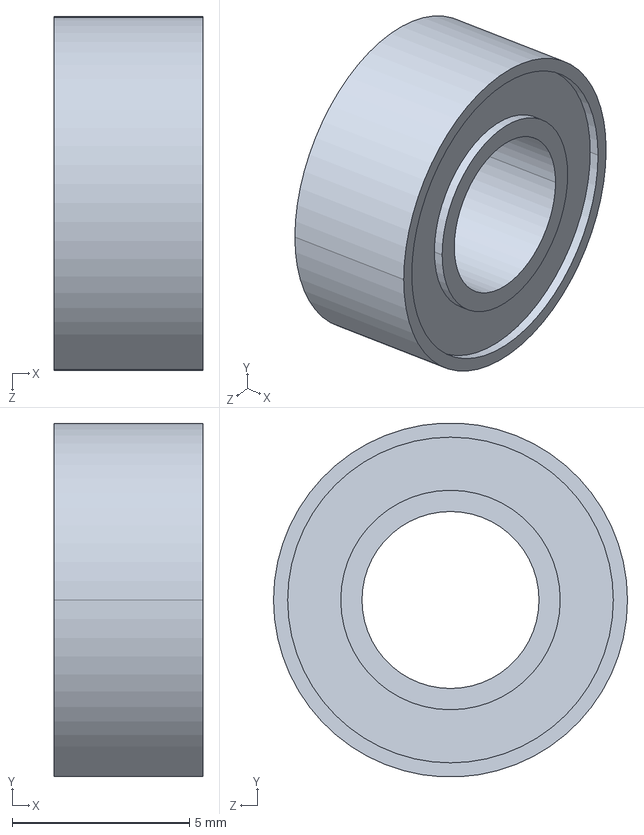
[picture p75: CAD file, 2026-10-25]
docs/3d-models/P04_bearing-105zz_openbuilds.step
4.20 x 9.99 x 10.0 mm
