freethought101/RackBotGen3/docs/3d-models/P09_mg90s.step

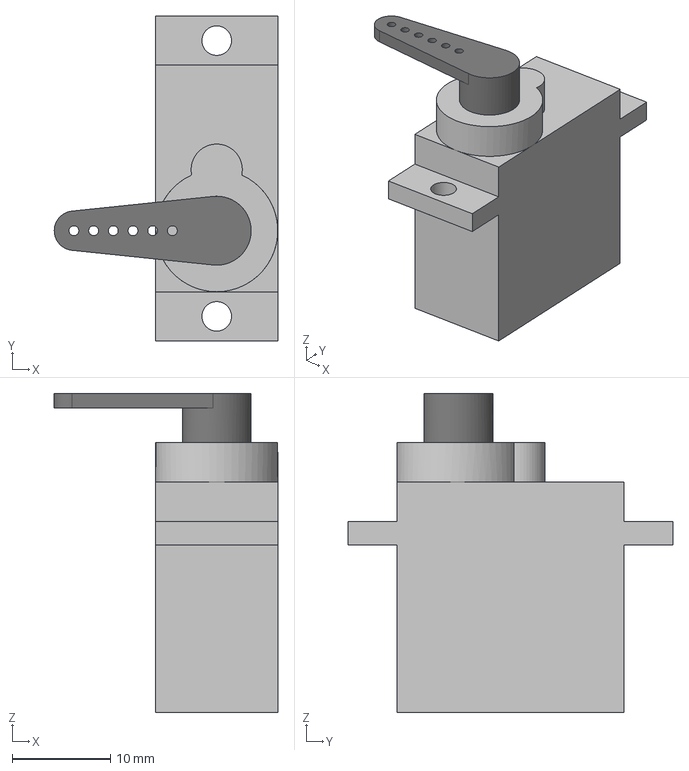
[picture p76: CAD file, 2026-10-25]
docs/3d-models/P09_mg90s.step
22.7 x 33.0 x 32.4 mm
