freethought101/RackBotGen3/docs/3d-models/P06_gt2-pulley-20t_openbuilds.step

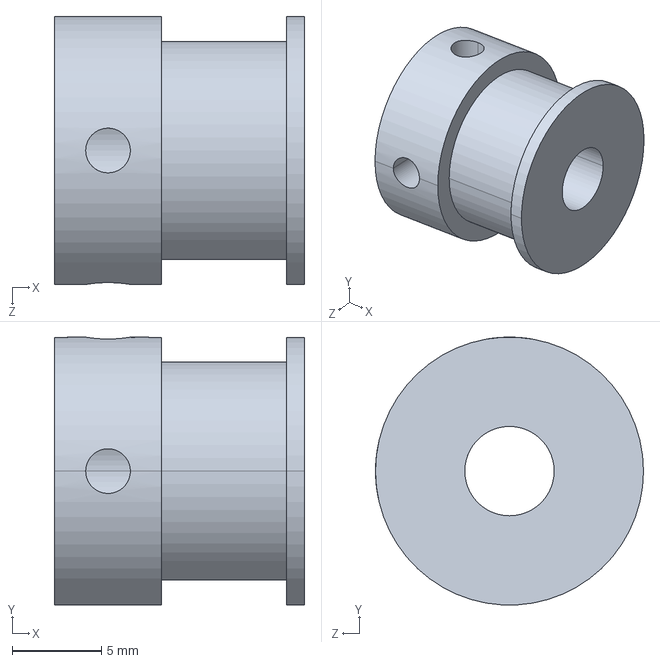
[picture p77: CAD file, 2026-10-25]
docs/3d-models/P06_gt2-pulley-20t_openbuilds.step
14.0 x 15.0 x 15.0 mm
