freethought101/RackBotGen3/(list of files, cad)

Other CAD files:
docs/3d-models/P04_mini-v-wheel_xtreme_openbuilds.step
docs/3d-models/P05_anti-backlash-nut-block_openbuilds.step
docs/3d-models/stl/P01_nema17_openbuilds.stl
docs/3d-models/stl/P02_vslot_2020_l0300_openbuilds.stl
docs/3d-models/stl/P03_vslot_2040_l0500_openbuilds.stl
docs/3d-models/stl/P04_bearing-105zz_openbuilds.stl
docs/3d-models/stl/P04_mini-eccentric-spacer-6mm_openbuilds.stl
docs/3d-models/stl/P04_mini-v-wheel_delrin-assembly_openbuilds.stl
docs/3d-models/stl/P04_mini-v-wheel_xtreme_openbuilds.stl
docs/3d-models/stl/P04_precision-shim-8x5x1_openbuilds.stl
docs/3d-models/stl/P04_spacer-6mm_openbuilds.stl
docs/3d-models/stl/P06_gt2-pulley-20t_openbuilds.stl
docs/3d-models/stl/P06_idler-smooth_openbuilds.stl
docs/3d-models/stl/P10_micro-limit-switch_openbuilds.stl
