freethought101/RackBotGen3/docs/datasheets/P16_esp32-s3-devkitc-1_reference-design/04_PCB Fabrication Requirements/Fabrication_Requirements_ESP32-S3-DevKitC-1_20220429.xls

Sheet: PCB Fabrication Requirements
PCB加工工艺要求说明书 PCB Fabrication Requirements |  |  |  |  |  |  |  |  |  |  | I. 板料及叠层可参考如下，板材 FR-4 TG150 无卤。PP 型号如有更换，请邮件通知。防止波纹布显露，选用的 PP 材料的 RC 含量不要低于50%。 Material and Stackup follow the design.FR-4 TG150 Halogen Free, If the PP model is changed, please inform us via email.To avoid texure condition,the resin content of PP material 7628 should not be lower than 50%.
文件名： File Name: |  | PCB_ESP32-S3-DevKitC-1_V1.1_20220429.pcb |  | 版本号： Version: |  | V1.1 | 物料名称： Material: | PCB |  |  | 层数 | 材质 | 钻孔结构 | 基铜厚度(OZ） | 各层厚度(mil)
PCB 加工要求： PCB Processing Requirements:
 |  |  |  |  |  |  |  |  |  |  | CM |  |  |  | 0.4 | 4 | 线宽/线距-距铜
 |  |  |  |  |  |  | 附图 Attachment |  |  |  | L1 | 基铜 |  | 0.33 | 1.18min |  | 9.4/5.6-5.8
 | 1.数 量： Order Quantity： |  | TBD | 块 PCS |  |  | 12.交货日期： Delivery Date:
 | 2.层 数： Number of Layers: |  |  |  |  |  |  |  |  |  |  | 芯板 |  |  | 57.9 | 4.47
 | 3.尺 寸： Dimension： |  | 62.74 |  | mm | 25.4 | mm |  | 详见 Gerber 文件尺寸 Refer to the Gerber file
 | 4.板 厚： Board Thickness： |  |  |  |  |  |  |  |  |  | L2 | 基铜 |  | 0.33 | 1.18min
 | 5.材 料： Material Type： |  |  |  | 其他材料： Other Material： |  |  |  |  |  |  |  |  |  |  | 3.6
 | 6.铜箔厚度： Copper Thickness： |  | 内层 Inner-Layer |  | 外层 Outer-Layer |  | 13.表面涂层： Surface Finishing： |  |  |  | SM |  |  |  | 0.4 | 4
 | 7.阻 焊： Solder Mask: |  |  |  | 颜 色： Color: | 油墨色号见颜色图表 | 14.加工厂商标记： Manufacturer's Marking： |  |  |  | 成品板厚：1.60+/-0.16mm
 | 8.字 符： Silkscreen: |  |  |  | 颜 色： Color: |  | UL 标记 UL Marking
 | 9.过孔处理方式： Through hole processing： |  |  |  |  |  | 制作日期 Manufature Date |  |  |  | II. 下图所示高亮走线需做 90 欧姆阻抗管控。叠层结构可参考右侧所示模型：
 | 10.测 试： Test：
 | 11.设计软件及其版本： Software Version:
 | 15.交货方式： Delivery Type： |  |  | 1 | 单元/片 Unit/PCS | 拼板交货允许报废 Panelization allows scrap |  |  |  | PCS/SET
 | 16.其 他： Others:
 | 17.层次排列： Layer Sequence： |  | L1_TOP, L2_BOTTOM
 | 说明(Notes)：
 | 1.两面盖油的双面塞孔，单面开窗的半塞孔，双面开窗的过孔在芯片背面塞孔。 Double-sided plug hole with oil cover on both sides, half-plug hole with open window on one side，non-plug hole with double-side window.
 | 2.如存在金手指或是 socket，需要进行镀硬金处理。并注意焊接时焊盘不可沾锡。 If there exists gold finger or socket, hard gold plating is needed. Besides, soldering tin should be avoided on the pad.
 | 其他特殊说明：按照 PCB 文件加工，并请注意按照上面的技术要求。
 | Other special specification: please fabricate based on the PCB file and pay attention to the above technical requirements.
 | EQ表 是常见问题总结，可以参考，加工工艺要求如下:
 | A. 沉金厚：金厚：半孔板 min 0.03um，非半孔板 min 0.0254um；镍厚按 min 2.54 um；
 | 测试沉金厚度面积为 2 - 10 平方 mm 的区域，连续测 10 次的平均值！
 | B. PTH 孔：±0.075 mm ；NPTH 孔：±0.05 mm；PTH 槽孔 ±5 mil；
 | C. 孔铜:通孔：15 um (min)；
 | D. 外形公差：±0.10 mm；
 | E. 板曲：≤ 0.75%；
 | F. 板厚公差：1 mm 以下公差： ±0.1 mm ； 1 mm 及以上公差： ±10%；
 | G. 阻焊油墨：10 - 40 um；
 | H. BGA & SMD：公差：±20%； 线宽 ＜ 4 mil 公差: ±1 mil, ≥ 4mil 公差：±20%；
 | I. 孔到边公差：±0.1 mm，孔到孔公差：±0.075 mm；
 | J. 内直角及小于 R 0.5 mm 的内角按 R 0.5 mm 制作；
 | K. 其他标准，按照 IPC-A-600 CLASS II 执行。 |  |  |  |  |  |  |  |  |  | III. Date Code 请填写在方框内，格式为 YYWW. Please fill in the data code in the box in the format of YYWW.

Sheet: Color
乐鑫产品PCB 颜色标准
Model | ESP-WROOM-02，ESP-WROOM-02D，ESP-WROOM-02U等ESP8266EX 系列 | ESP-WROOM-32，ESP32-WROVER，ESP32-WROOM-32U，ESP32-WROOM-32D，ESP32-PICO-KIT，ESP32-DevKitC，ESP32_LyraT，ESP-WROVER-KIT等ESP32系列
颜色 | PMS287 PMS288 PMS294 PMS295 PMS2945 PMS2955 | （哑光黑色）Black/PMS412/PMS419/PMS426/PMS433
色卡对照区域
