freethought101/RackBotGen3/docs/poster/Corvin-poster-A2.pdf

## AUTOMATION TRACK

# CORVIN

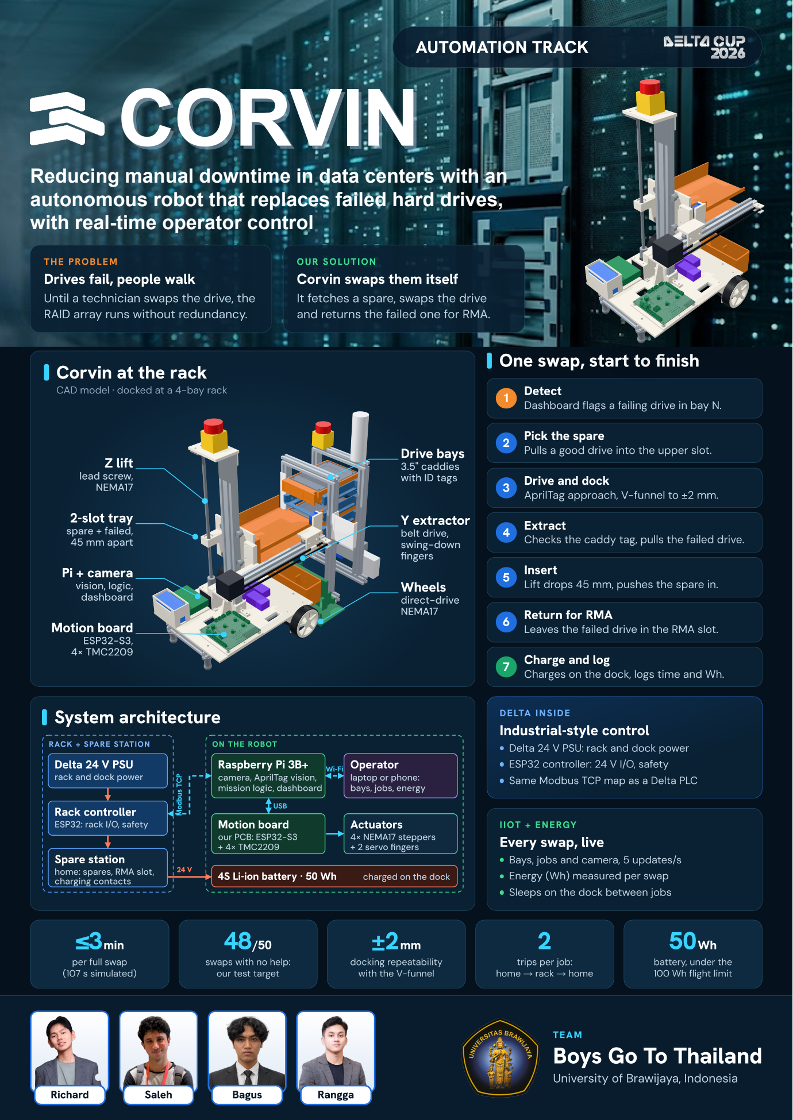
[picture p78: page 1]
System architecture; RACK + SPARE STATION; ON THE ROBOT; Delta 24 V PSU; Rack controller; Spare station; Raspberry Pi 3B+; Operator; Motion board; Actuators; ESP32: rack I/O, safety; our PCB: ESP32-S3; + 4× TMC2209; 4× NEMA17 steppers; + 2 servo fingers; USB; DELTA INSIDE; IIOT + ENERGY; ≤3min; Z lift; 2-slot tray; Pi + camera; Y extractor; Wheels; lead screw,; NEMA17; spare + failed,; 45 mm apart; vision, logic,; dashboard; ESP32-S3,; 4× TMC2209; belt drive,; swing-down; fingers; direct-drive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

Drives fail, people walk

Corvin swaps them itself

Until a technician swaps the drive, the

It fetches a spare, swaps the drive
and returns the failed one for RMA.

RAID array runs without redundancy.

One swap, start to finish

Corvin at the rack

CAD model · docked at a 4-bay rack

Detect
Dashboard flags a failing drive in bay N.

Pick the spare
Pulls a good drive into the upper slot.

Drive bays
3.5" caddies
with ID tags

Drive and dock
AprilTag approach, V-funnel to ±2 mm.

Extract
Checks the caddy tag, pulls the failed drive.

Insert
Lift drops 45 mm, pushes the spare in.

Return for RMA
Leaves the failed drive in the RMA slot.

Charge and log
Charges on the dock, logs time and Wh.

Industrial-style control

Delta 24 V PSU: rack and dock power

rack and dock power

camera, AprilTag vision,
mission logic, dashboard

laptop or phone:
bays, jobs, energy

Same Modbus TCP map as a Delta PLC

Every swap, live

Bays, jobs and camera, 5 updates/s

home: spares, RMA slot,
charging contacts

4S Li-ion battery · 50 Wh

charged on the dock

Energy (Wh) measured per swap

Sleeps on the dock between jobs

per full swap
(107 s simulated)

swaps with no help:
our test target

docking repeatability
with the V-funnel

trips per job:

battery, under the
100 Wh flight limit

home → rack → home

TEAM
Boys Go To Thailand

University of Brawijaya, Indonesia
