freethought101/RackBotGen3/pcb/motion-board/fab/rbg3-motion-schematic.pdf

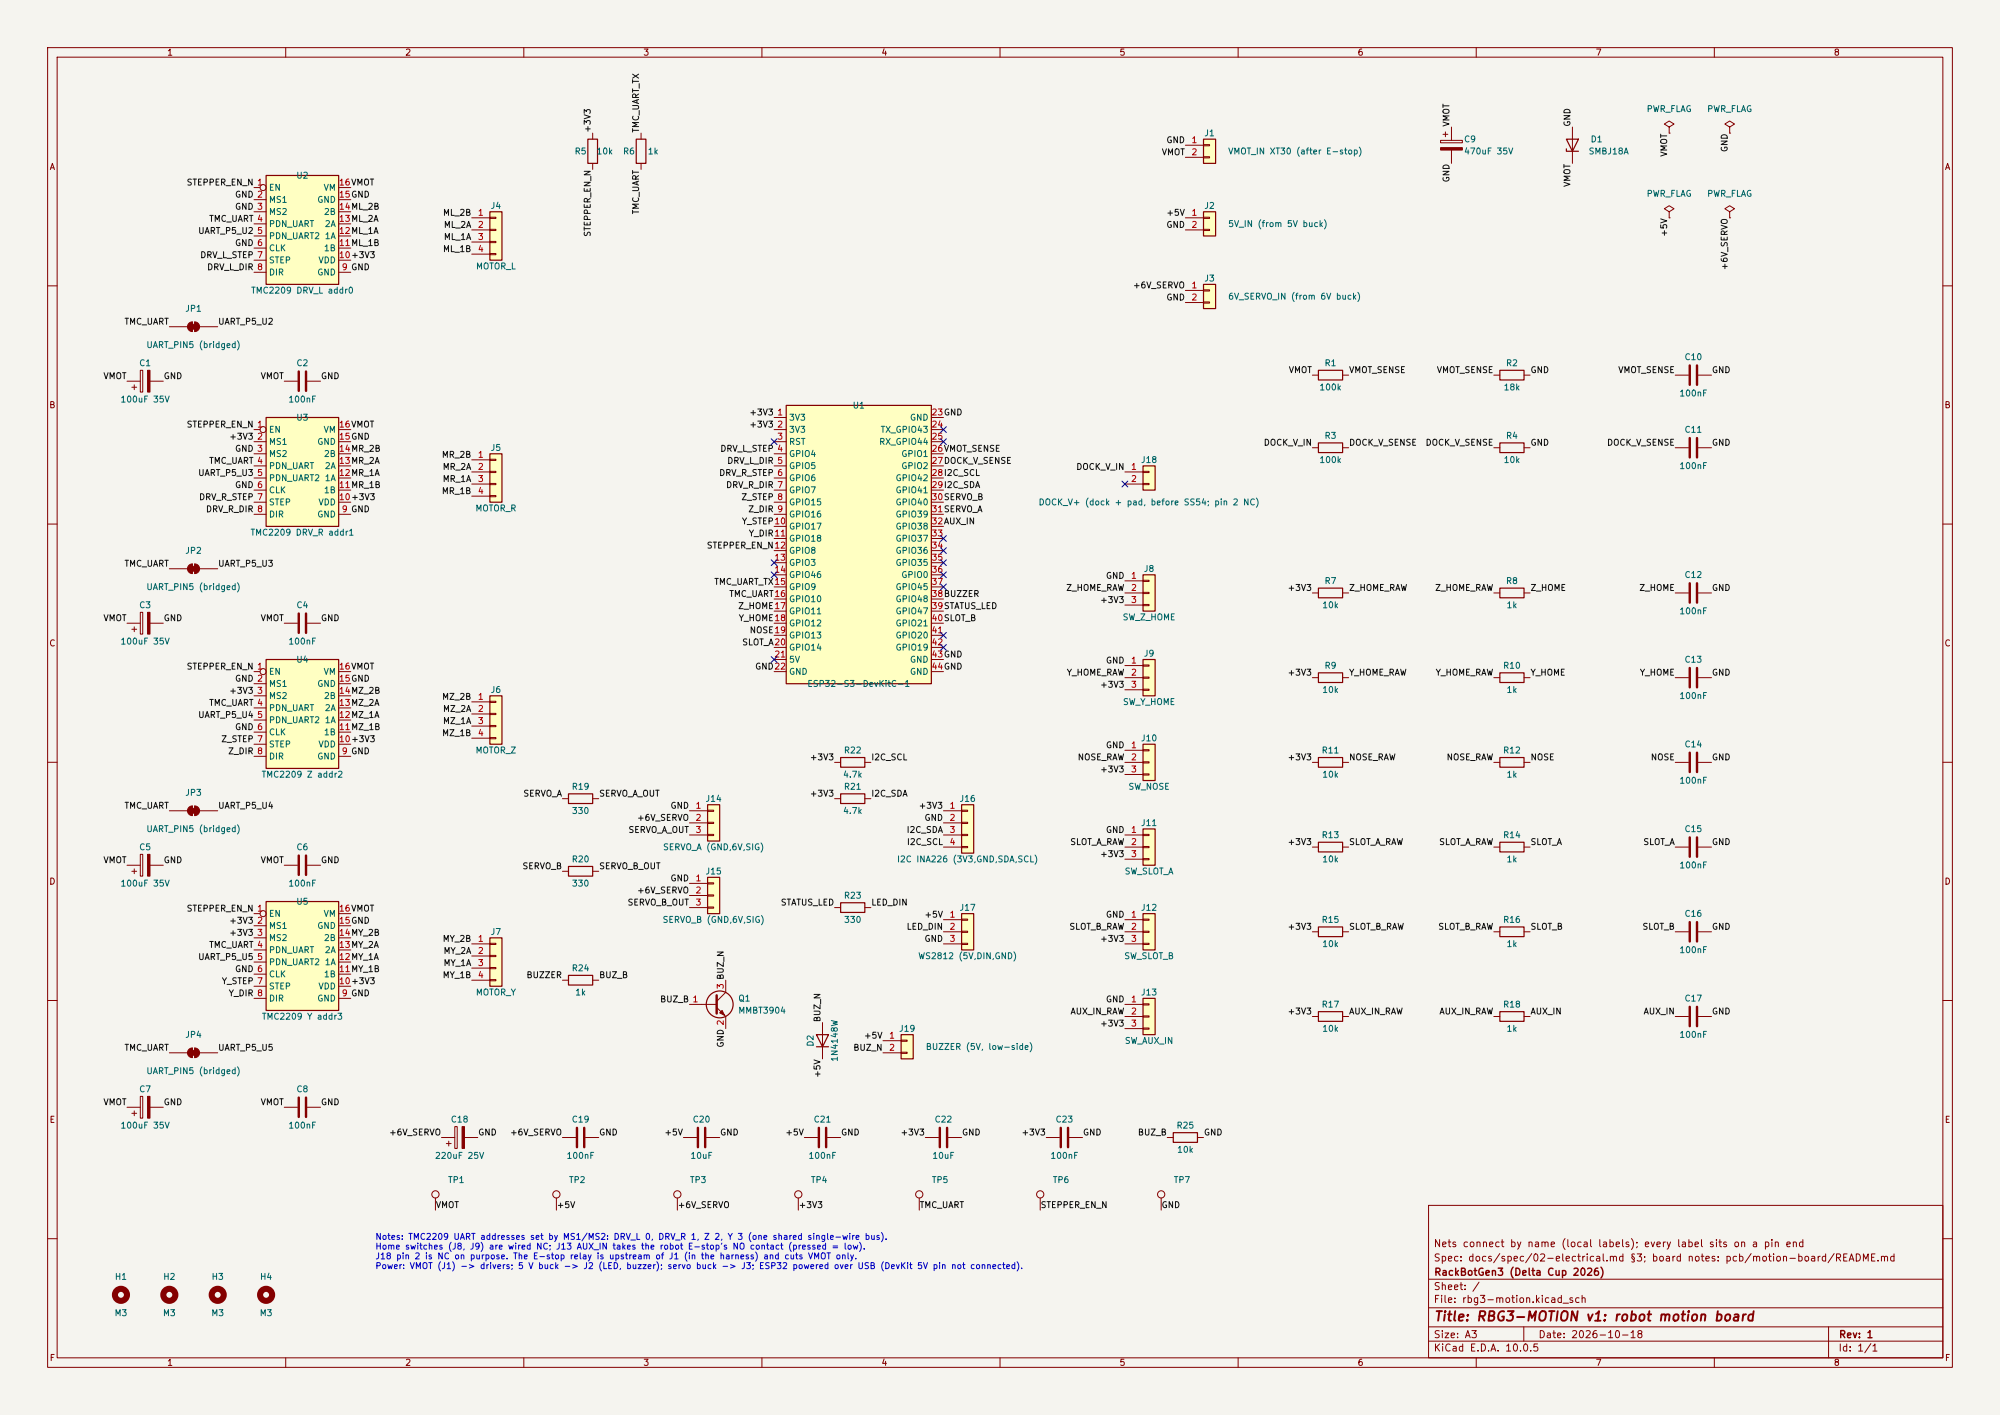
[picture p79: page 1]

Notes: TMC2209 UART addresses set by MS1/MS2: DRV_L 0, DRV_R 1, Z 2, Y 3 (one shared single-wire bus). Home switches (J8, J9) are wired NC; J13 AUX_IN takes the robot E-stop's NO contact (pressed = low). J18 pin 2 is NC on purpose. The E-stop relay is upstream of J1 (in the harness) and cuts VMOT only. Power: VMOT (J1) -> drivers; 5 V buck -> J2 (LED, buzzer); servo buck -> J3; ESP32 powered over USB (DevKit 5V pin not connected).

Nets connect by name (local labels); every label sits on a pin end
Spec: docs/spec/02-electrical.md §3; board notes: pcb/motion-board/README.md
RackBotGen3 (Delta Cup 2026)
Sheet: /
File: rbg3-motion.kicad_sch
Title: RBG3-MOTION v1: robot motion board

Size: A3 | Rev: 1 | F Date: 2026-10-18
KiCad E.D.A. 10.0.5 | Id: 1/1
