freethought101/RackBotGen3/pcb/motion-board/fab/rbg3-motion-layout.pdf

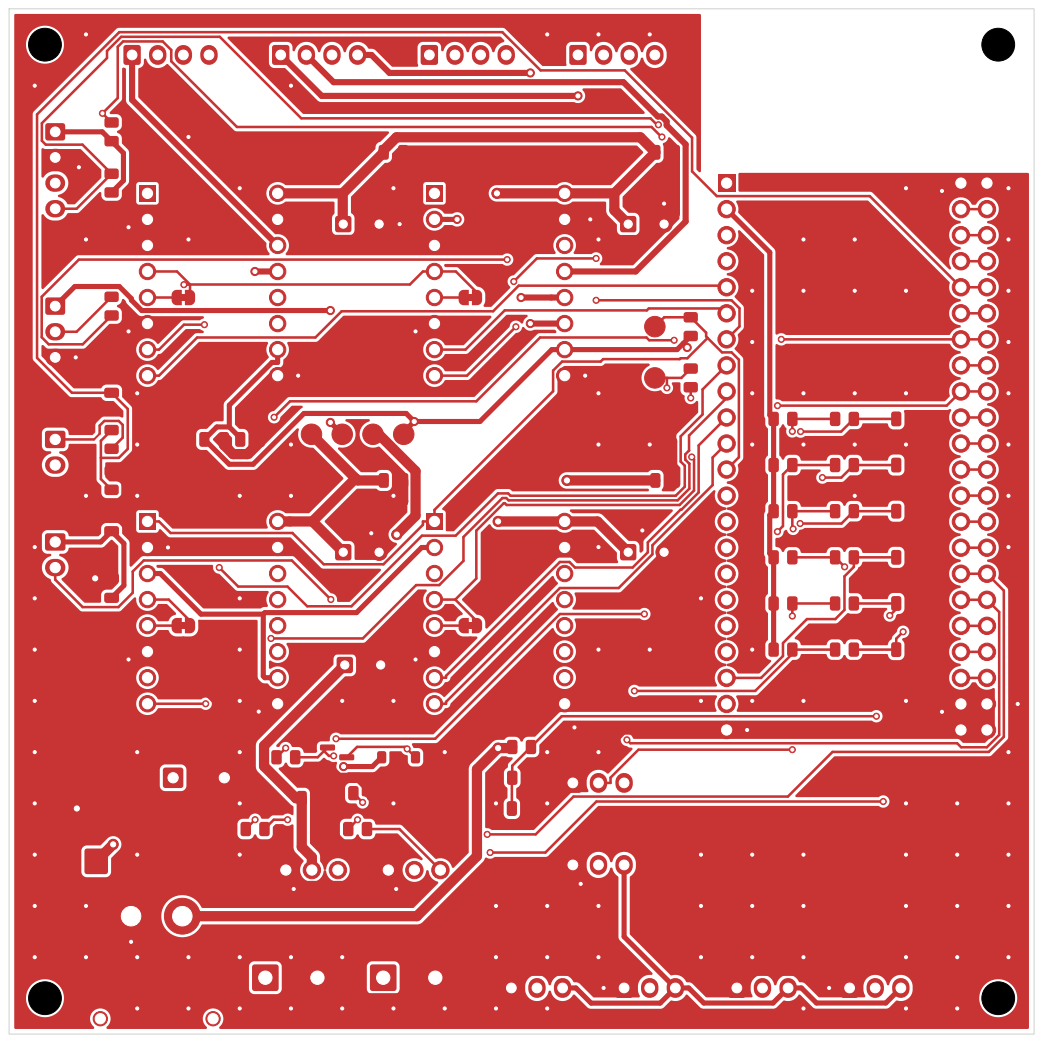
[picture p80: page 1]

2 layers, 100 x 100 mm, 1.6 mm FR-4, 1 oz copper
Spec: docs/spec/02-electrical.md §3; board notes: pcb/motion-board/README.md
RackBotGen3 (Delta Cup 2026)
Sheet:
File: rbg3-motion.kicad_pcb
Title: RBG3-MOTION v1: robot motion board

Size: A4 | Rev: 1
KiCad E.D.A. 10.0.5 | Id: 1/8

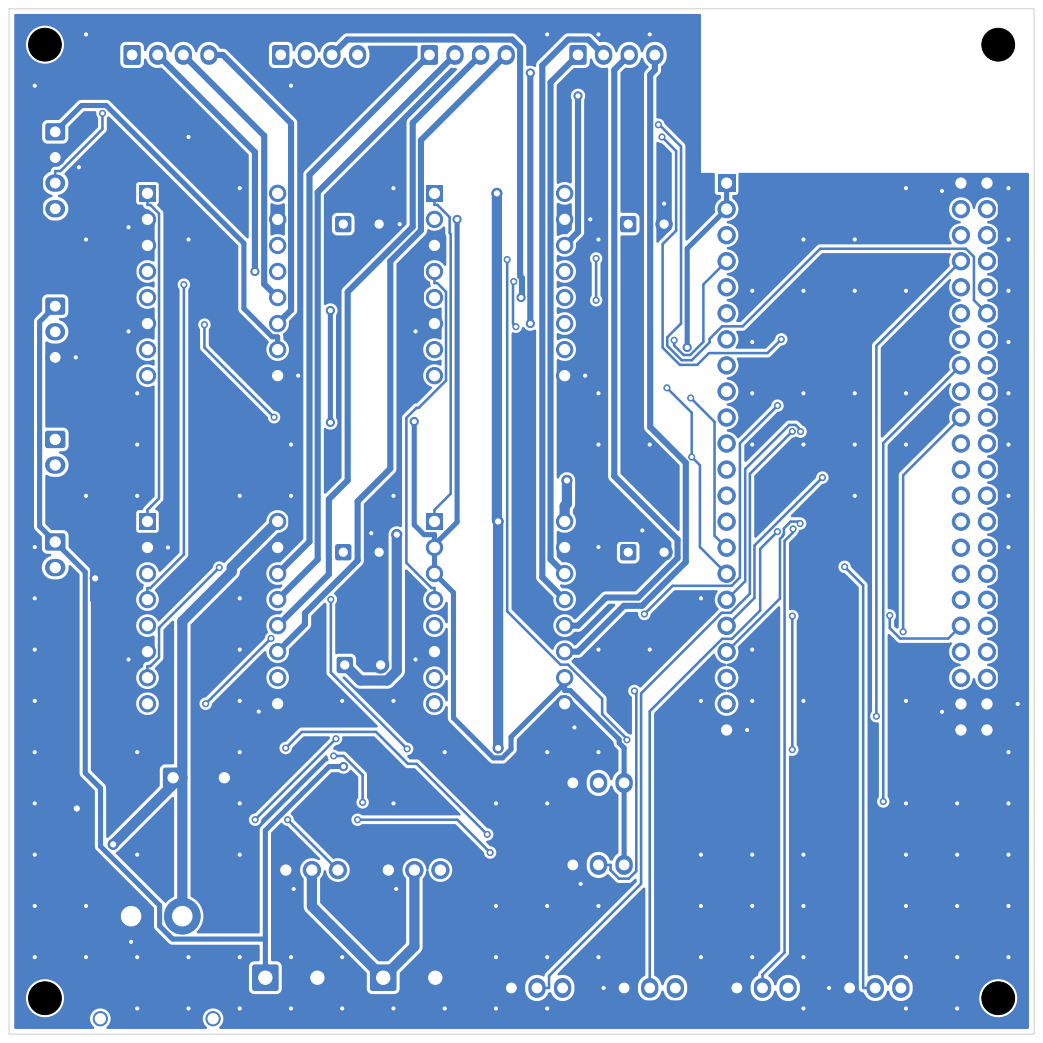
[picture p81: page 2]
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

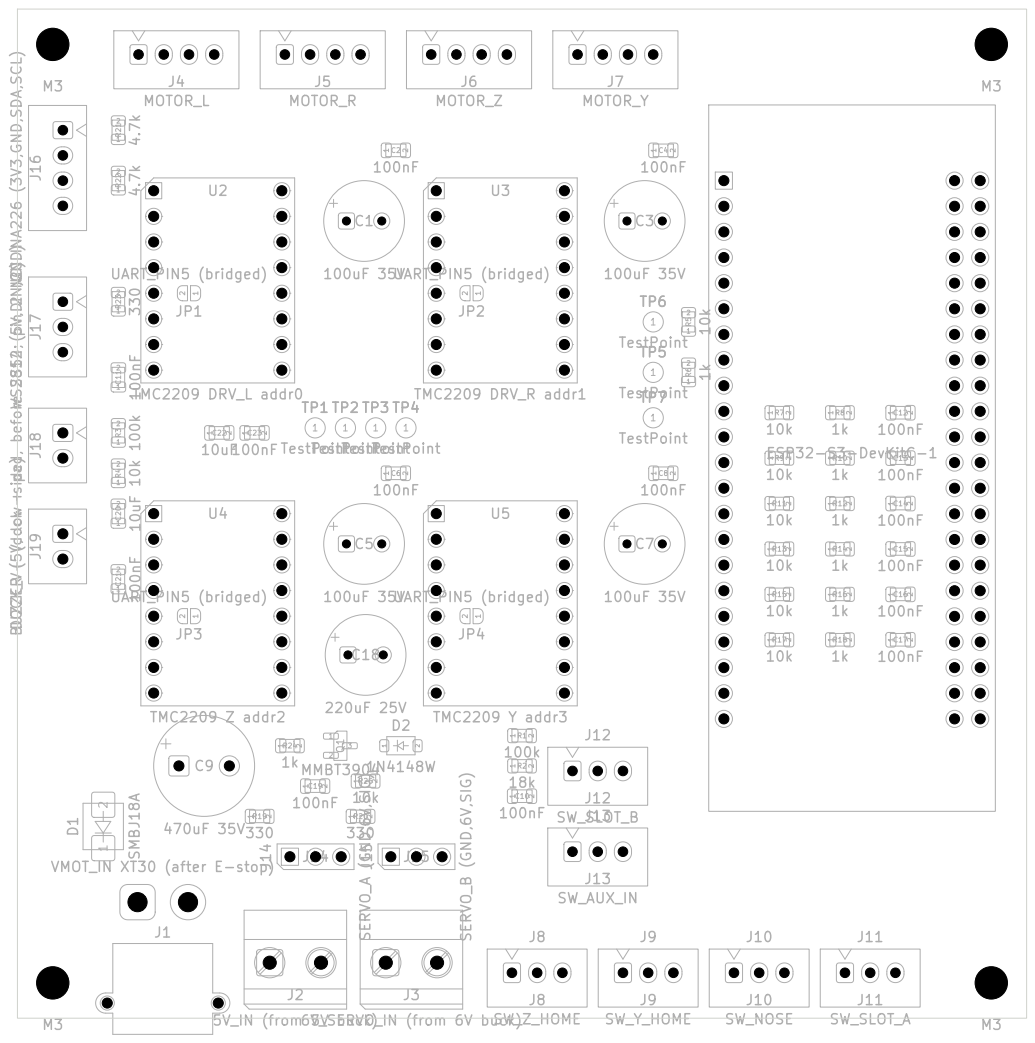
[picture p82: page 3]
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

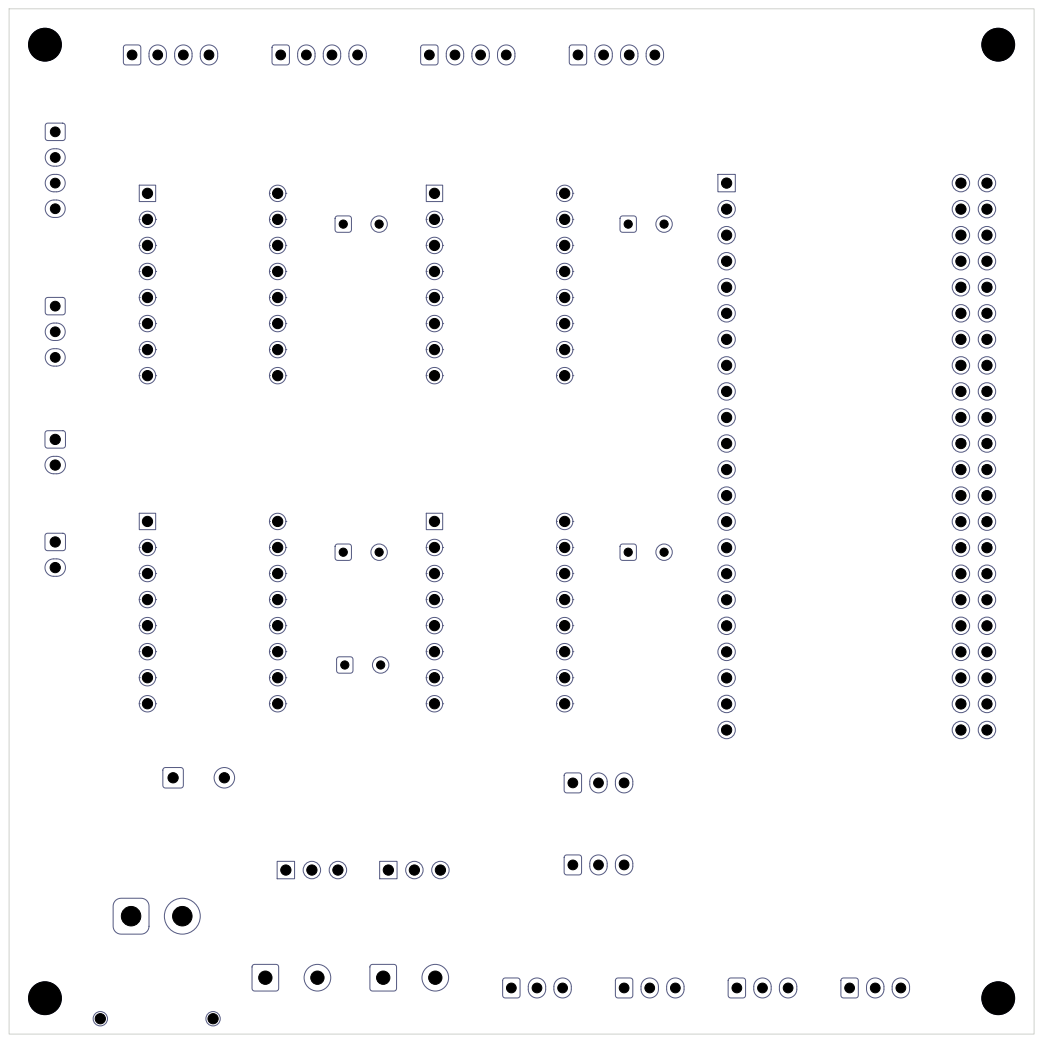
[picture p83: page 4]
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

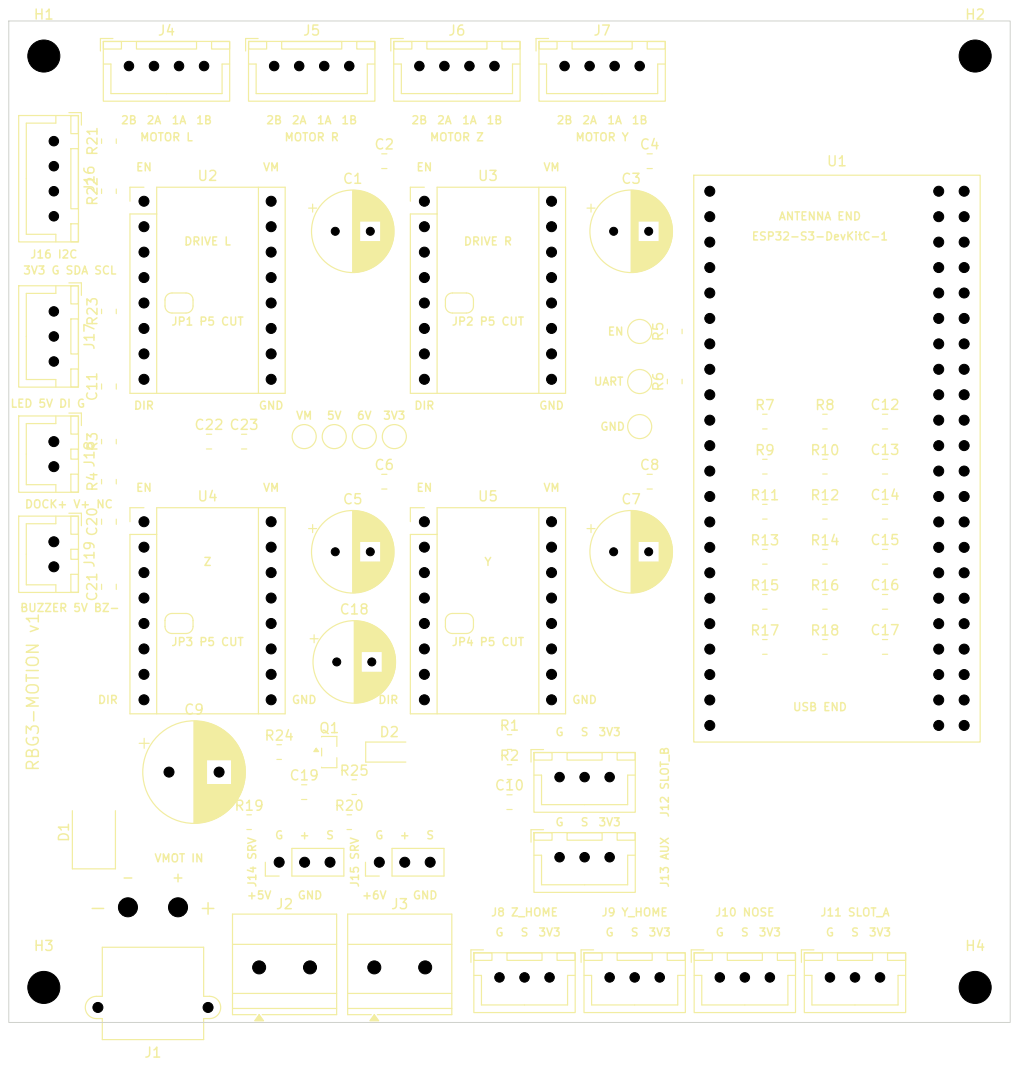
[picture p84: page 5]

BUZZER 5V BZ-
2 layers, 100 x 100 mm, 1.6 mm FR-4, 1 oz copper RBG3-MOTION v1

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

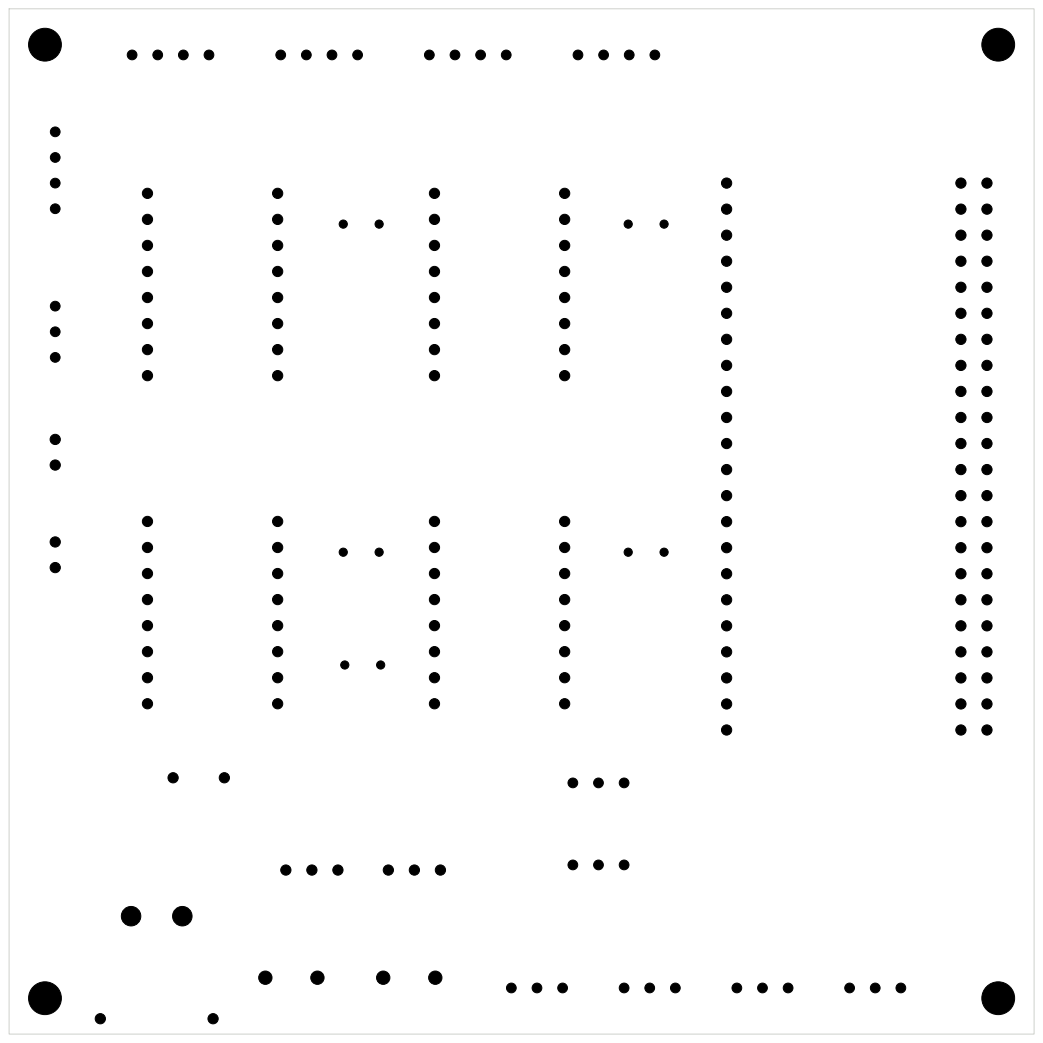
[picture p85: page 6]
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

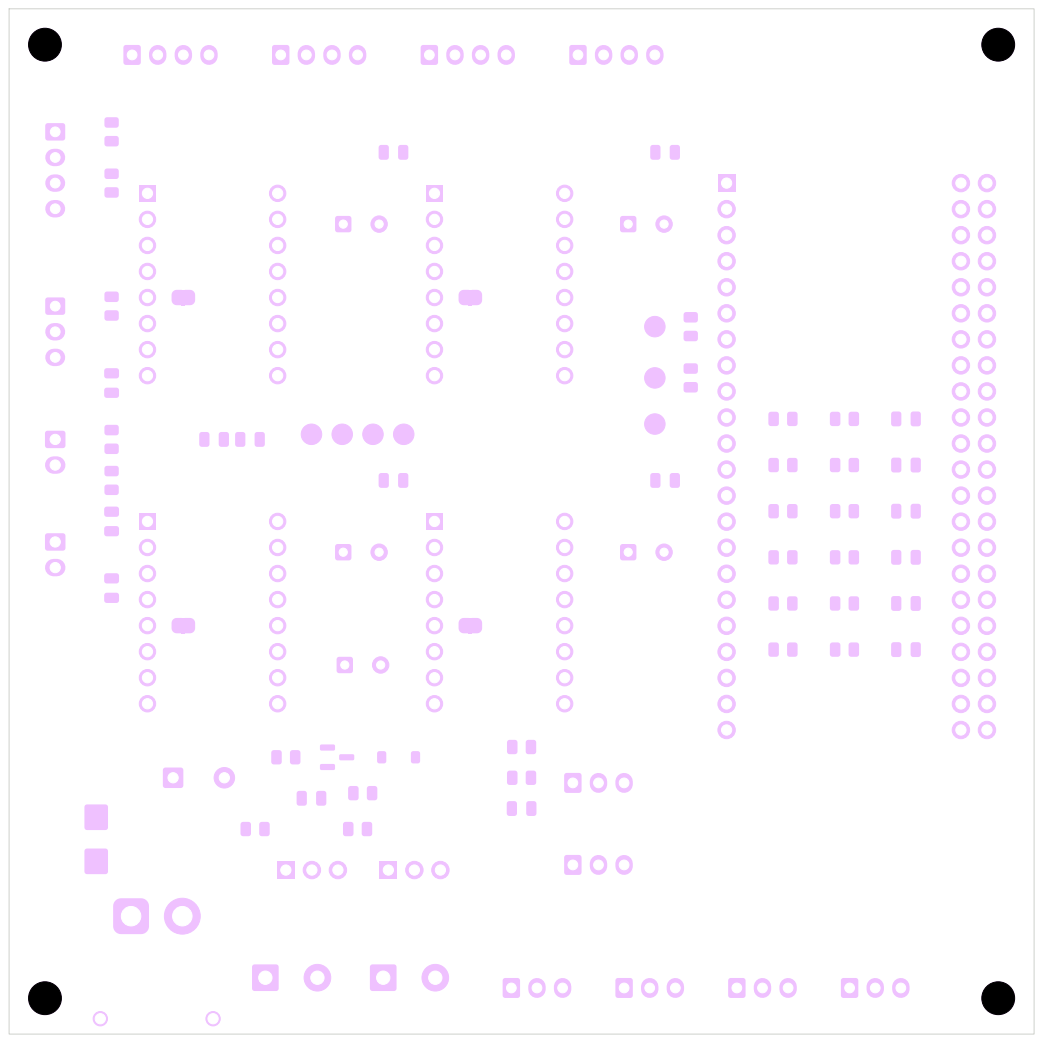
[picture p86: page 7]
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

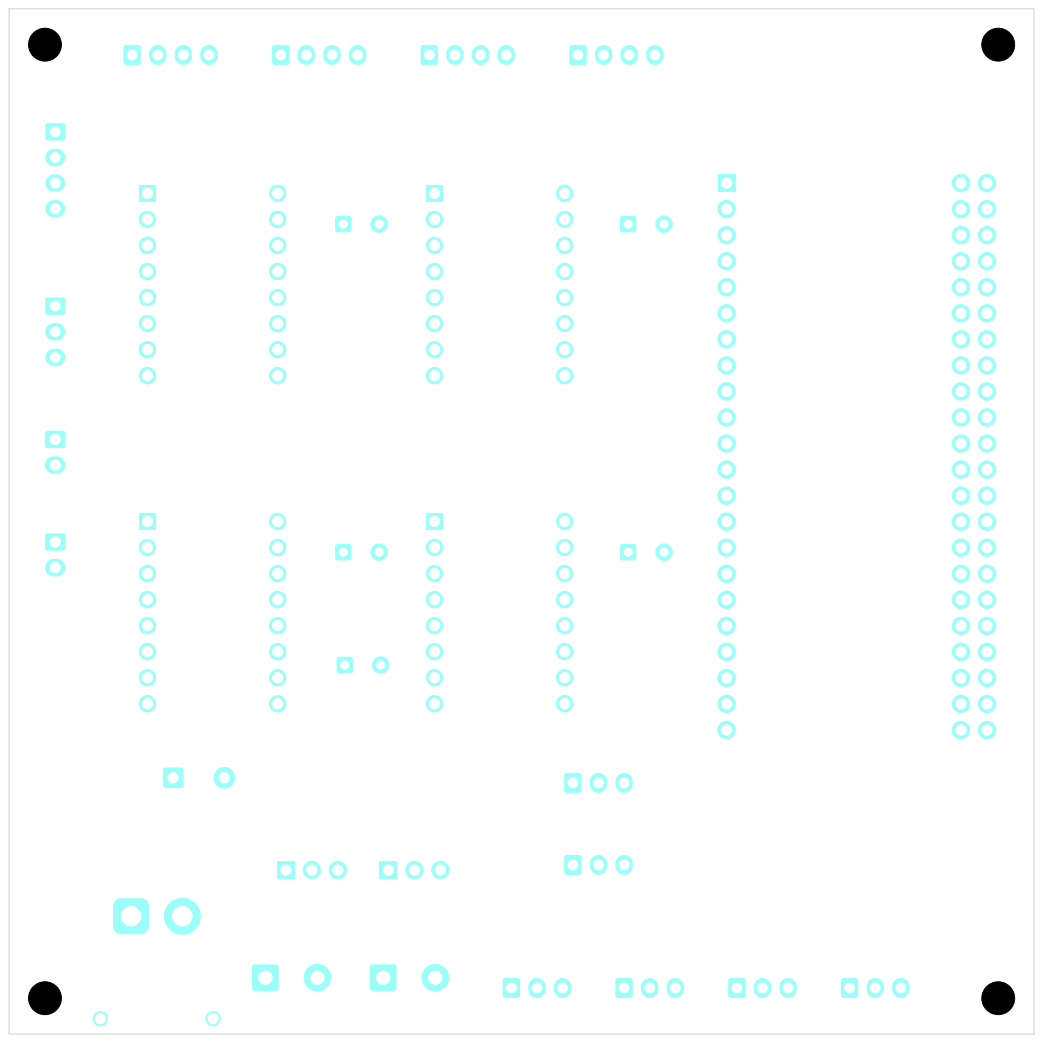
[picture p87: page 8]
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
