freethought101/RackBotGen3/(list of files, drawings)

Other design files:
docs/datasheets/P16_esp32-s3-devkitc-1_reference-design/01_Schematic/SCH_ESP32-S3-DevKitC-1_V1.1_20221130.DSN
docs/datasheets/P16_esp32-s3-devkitc-1_reference-design/02_PCB/PCB_ESP32-S3-DevKitC-1_V1.1_20220429.pcb
