freethought101/RackBotGen3/pcb/motion-board/rbg3-motion.kicad_pcb

## KiCad design pcb/motion-board/rbg3-motion.kicad_pcb (2026-10-23)

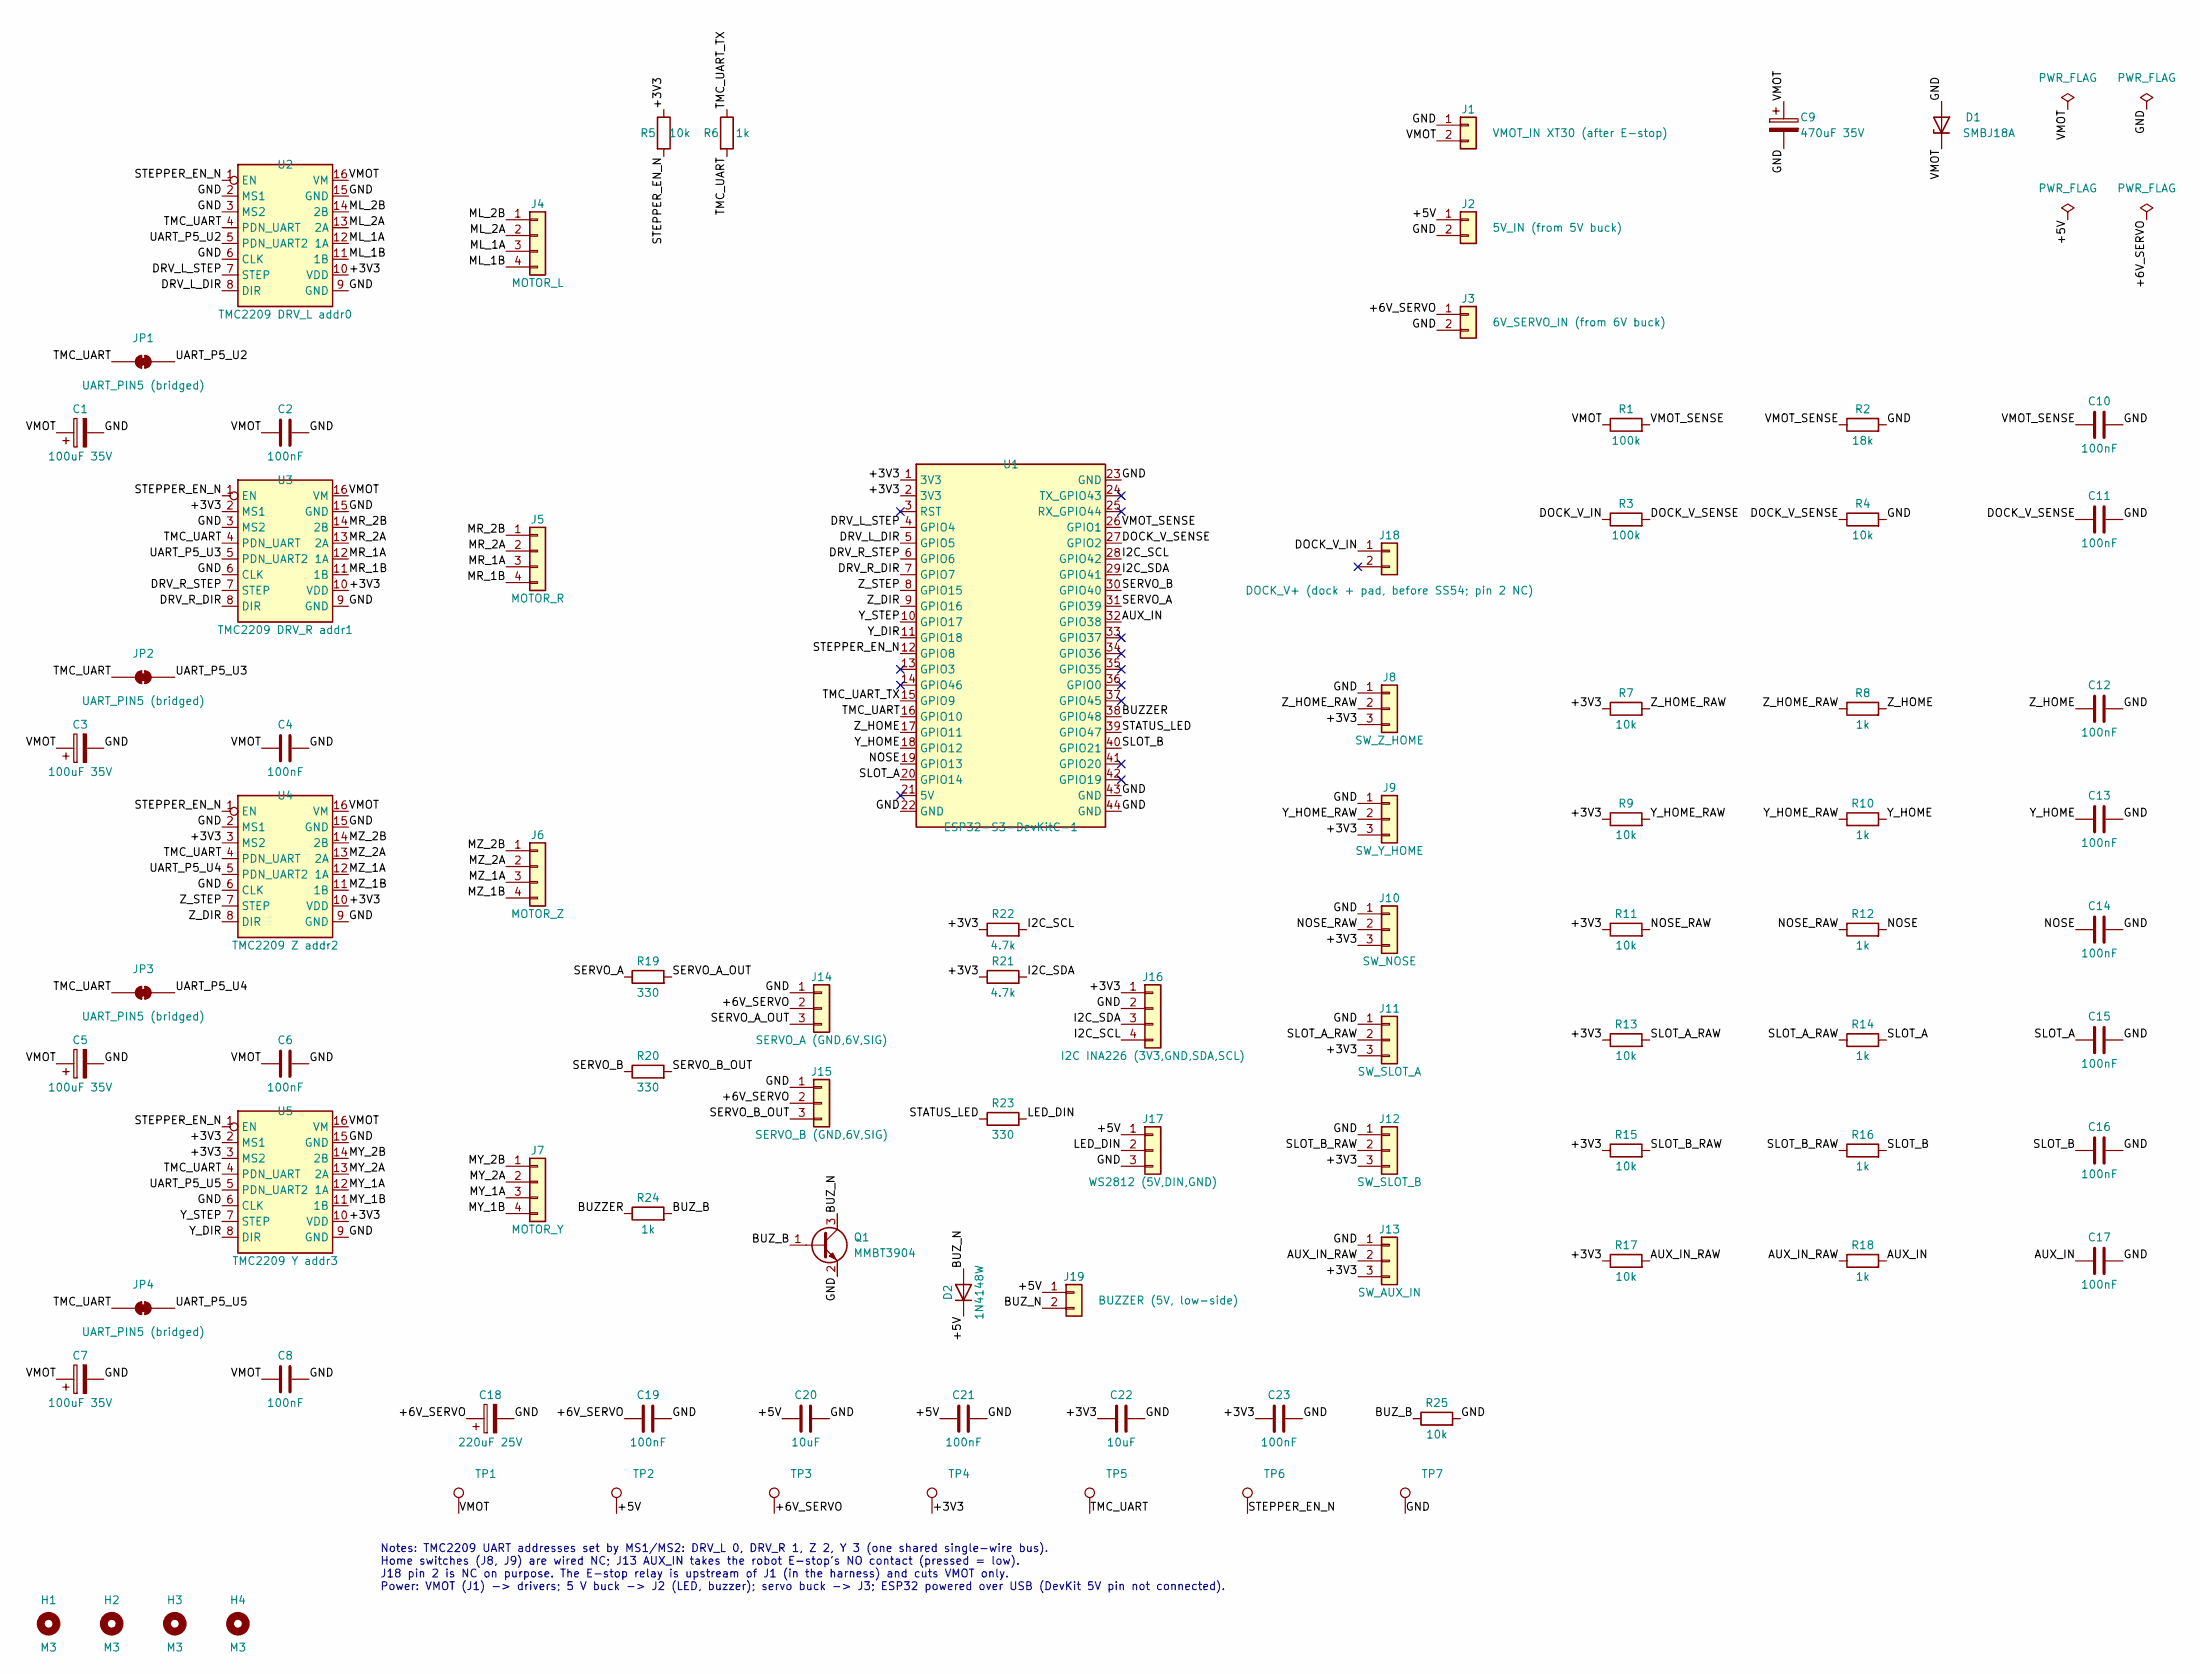
[picture p88: schematic rbg3-motion.kicad_sch, RBG3-MOTION v1: robot motion board]

Parts:
C1, C3, C5, C7: 100uF 35V; CP_Radial_D8.0mm_P3.50mm
C2, C4, C6, C8, C10, C11, C12, C13, C14, C15, C16, C17, C19, C21, C23: 100nF; C_0805_2012Metric
C9: 470uF 35V; CP_Radial_D10.0mm_P5.00mm
C18: 220uF 25V; CP_Radial_D8.0mm_P3.50mm
C20, C22: 10uF; C_0805_2012Metric
D1: SMBJ18A; D_SMB
D2: 1N4148W; D_SOD-123
H1, H2, H3, H4: M3; MountingHole_3.2mm_M3
J1: VMOT_IN XT30 (after E-stop); AMASS_XT30PW-M_1x02_P2.50mm_Horizontal
J2: 5V_IN (from 5V buck); TerminalBlock_Phoenix_MKDS-1,5-2-5.08_1x02_P5.08mm_Horizont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
J3: 6V_SERVO_IN (from 6V buck); TerminalBlock_Phoenix_MKDS-1,5-2-5.08_1x02_P5.08mm_Horizont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
J4: MOTOR_L; JST_XH_B4B-XH-A_1x04_P2.50mm_Vertical
J5: MOTOR_R; JST_XH_B4B-XH-A_1x04_P2.50mm_Vertical
J6: MOTOR_Z; JST_XH_B4B-XH-A_1x04_P2.50mm_Vertical
J7: MOTOR_Y; JST_XH_B4B-XH-A_1x04_P2.50mm_Vertical
J8: SW_Z_HOME; JST_XH_B3B-XH-A_1x03_P2.50mm_Vertical
J9: SW_Y_HOME; JST_XH_B3B-XH-A_1x03_P2.50mm_Vertical
J10: SW_NOSE; JST_XH_B3B-XH-A_1x03_P2.50mm_Vertical
J11: SW_SLOT_A; JST_XH_B3B-XH-A_1x03_P2.50mm_Vertical
J12: SW_SLOT_B; JST_XH_B3B-XH-A_1x03_P2.50mm_Vertical
J13: SW_AUX_IN; JST_XH_B3B-XH-A_1x03_P2.50mm_Vertical
J14: SERVO_A (GND,6V,SIG); PinHeader_1x03_P2.54mm_Vertical
J15: SERVO_B (GND,6V,SIG); PinHeader_1x03_P2.54mm_Vertical
J16: I2C INA226 (3V3,GND,SDA,SCL); JST_XH_B4B-XH-A_1x04_P2.50mm_Vertical
J17: WS2812 (5V,DIN,GND); JST_XH_B3B-XH-A_1x03_P2.50mm_Vertical
J18: DOCK_V+ (dock + pad, before SS54; pin 2 NC); JST_XH_B2B-XH-A_1x02_P2.50mm_Vertical
J19: BUZZER (5V, low-side); JST_XH_B2B-XH-A_1x02_P2.50mm_Vertical
JP1, JP2, JP3, JP4: UART_PIN5 (bridged); SolderJumper-2_P1.3mm_Bridged_RoundedPad1.0x1.5mm
Q1: MMBT3904; SOT-23
R1, R3: 100k; R_0805_2012Metric
R2: 18k; R_0805_2012Metric
R4, R5, R7, R9, R11, R13, R15, R17, R25: 10k; R_0805_2012Metric
R6, R8, R10, R12, R14, R16, R18, R24: 1k; R_0805_2012Metric
R19, R20, R23: 330; R_0805_2012Metric
R21, R22: 4.7k; R_0805_2012Metric
TP1, TP2, TP3, TP4, TP5, TP6, TP7: TestPoint; TestPoint_Pad_D2.0mm
U1: ESP32-S3-DevKitC-1; ESP32-S3-DevKitC-1_Socket
U2: TMC2209 DRV_L addr0; Pololu_Breakout-16_15.2x20.3mm
U3: TMC2209 DRV_R addr1; Pololu_Breakout-16_15.2x20.3mm
U4: TMC2209 Z addr2; Pololu_Breakout-16_15.2x20.3mm
U5: TMC2209 Y addr3; Pololu_Breakout-16_15.2x20.3mm

Connections:
/+3V3: C22.1, C23.1, J8.3, J9.3, J10.3, J11.3, J12.3, J13.3, J16.1, R5.1, R7.1, R9.1, R11.1, R13.1, R15.1, R17.1, R21.1, R22.1, TP4.1, U1.1 (3V3), U1.2 (3V3), U2.10 (VDD), U3.2 (MS1), U3.10 (VDD), U4.3 (MS2), U4.10 (VDD), U5.2 (MS1), U5.3 (MS2), U5.10 (VDD)
/+5V: C20.1, C21.1, D2.1 (K), J2.1, J17.1, J19.1, TP2.1
/+6V_SERVO: C18.1, C19.1, J3.1, J14.2, J15.2, TP3.1
/AUX_IN: C17.1, R18.2, U1.32 (GPIO38)
/AUX_IN_RAW: J13.2, R17.2, R18.1
/BUZZER: R24.1, U1.38 (GPIO48)
/BUZ_B: Q1.1 (B), R24.2, R25.1
/BUZ_N: D2.2 (A), J19.2, Q1.3 (C)
/DOCK_V_IN: J18.1, R3.1
/DOCK_V_SENSE: C11.1, R3.2, R4.1, U1.27 (GPIO2)
/DRV_L_DIR: U1.5 (GPIO5), U2.8 (DIR)
/DRV_L_STEP: U1.4 (GPIO4), U2.7 (STEP)
/DRV_R_DIR: U1.7 (GPIO7), U3.8 (DIR)
/DRV_R_STEP: U1.6 (GPIO6), U3.7 (STEP)
/GND: C1.2, C2.2, C3.2, C4.2, C5.2, C6.2, C7.2, C8.2, C9.2, C10.2, C11.2, C12.2, C13.2, C14.2, C15.2, C16.2, C17.2, C18.2, C19.2, C20.2, C21.2, C22.2, C23.2, D1.2 (A), J1.1, J2.2, J3.2, J8.1, J9.1, J10.1, J11.1, J12.1, J13.1, J14.1, J15.1, J16.2, J17.3, Q1.2 (E), R2.2, R4.2, R25.2, TP7.1, U1.22 (GND), U1.23 (GND), U1.43 (GND), U1.44 (GND), U2.2 (MS1), U2.3 (MS2), U2.6 (CLK), U2.9 (GND), U2.15 (GND), U3.3 (MS2), U3.6 (CLK), U3.9 (GND), U3.15 (GND), U4.2 (MS1), U4.6 (CLK), U4.9 (GND), U4.15 (GND), U5.6 (CLK), U5.9 (GND), U5.15 (GND)
/I2C_SCL: J16.4, R22.2, U1.28 (GPIO42)
/I2C_SDA: J16.3, R21.2, U1.29 (GPIO41)
/LED_DIN: J17.2, R23.2
/ML_1A: J4.3, U2.12 (1A)
/ML_1B: J4.4, U2.11 (1B)
/ML_2A: J4.2, U2.13 (2A)
/ML_2B: J4.1, U2.14 (2B)
/MR_1A: J5.3, U3.12 (1A)
/MR_1B: J5.4, U3.11 (1B)
/MR_2A: J5.2, U3.13 (2A)
/MR_2B: J5.1, U3.14 (2B)
/MY_1A: J7.3, U5.12 (1A)
/MY_1B: J7.4, U5.11 (1B)
/MY_2A: J7.2, U5.13 (2A)
/MY_2B: J7.1, U5.14 (2B)
/MZ_1A: J6.3, U4.12 (1A)
/MZ_1B: J6.4, U4.11 (1B)
/MZ_2A: J6.2, U4.13 (2A)
/MZ_2B: J6.1, U4.14 (2B)
/NOSE: C14.1, R12.2, U1.19 (GPIO13)
/NOSE_RAW: J10.2, R11.2, R12.1
/SERVO_A: R19.1, U1.31 (GPIO39)
/SERVO_A_OUT: J14.3, R19.2
/SERVO_B: R20.1, U1.30 (GPIO40)
/SERVO_B_OUT: J15.3, R20.2
/SLOT_A: C15.1, R14.2, U1.20 (GPIO14)
/SLOT_A_RAW: J11.2, R13.2, R14.1
/SLOT_B: C16.1, R16.2, U1.40 (GPIO21)
/SLOT_B_RAW: J12.2, R15.2, R16.1
/STATUS_LED: R23.1, U1.39 (GPIO47)
/STEPPER_EN_N: R5.2, TP6.1, U1.12 (GPIO8), U2.1 (EN), U3.1 (EN), U4.1 (EN), U5.1 (EN)
/TMC_UART: JP1.1 (A), JP2.1 (A), JP3.1 (A), JP4.1 (A), R6.2, TP5.1, U1.16 (GPIO10), U2.4 (PDN_UART), U3.4 (PDN_UART), U4.4 (PDN_UART), U5.4 (PDN_UART)
/TMC_UART_TX: R6.1, U1.15 (GPIO9)
/UART_P5_U2: JP1.2 (B), U2.5 (PDN_UART2)
/UART_P5_U3: JP2.2 (B), U3.5 (PDN_UART2)
/UART_P5_U4: JP3.2 (B), U4.5 (PDN_UART2)
/UART_P5_U5: JP4.2 (B), U5.5 (PDN_UART2)
/VMOT: C1.1, C2.1, C3.1, C4.1, C5.1, C6.1, C7.1, C8.1, C9.1, D1.1 (K), J1.2, R1.1, TP1.1, U2.16 (VM), U3.16 (VM), U4.16 (VM), U5.16 (VM)
/VMOT_SENSE: C10.1, R1.2, R2.1, U1.26 (GPIO1)
/Y_DIR: U1.11 (GPIO18), U5.8 (DIR)
/Y_HOME: C13.1, R10.2, U1.18 (GPIO12)
/Y_HOME_RAW: J9.2, R9.2, R10.1
/Y_STEP: U1.10 (GPIO17), U5.7 (STEP)
/Z_DIR: U1.9 (GPIO16), U4.8 (DIR)
/Z_HOME: C12.1, R8.2, U1.17 (GPIO11)
/Z_HOME_RAW: J8.2, R7.2, R8.1
/Z_STEP: U1.8 (GPIO15), U4.7 (STEP)

Notes on the sheet:
Notes: TMC2209 UART addresses set by MS1/MS2: DRV_L 0, DRV_R 1, Z 2, Y 3 (one shared single-wire bus). Home switches (J8, J9) are wired NC; J13 AUX_IN takes the robot E-stop's NO contact (pressed = low). J18 pin 2 is NC on purpose. The E-stop relay is upstream of J1 (in the harness) and cuts VMOT o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

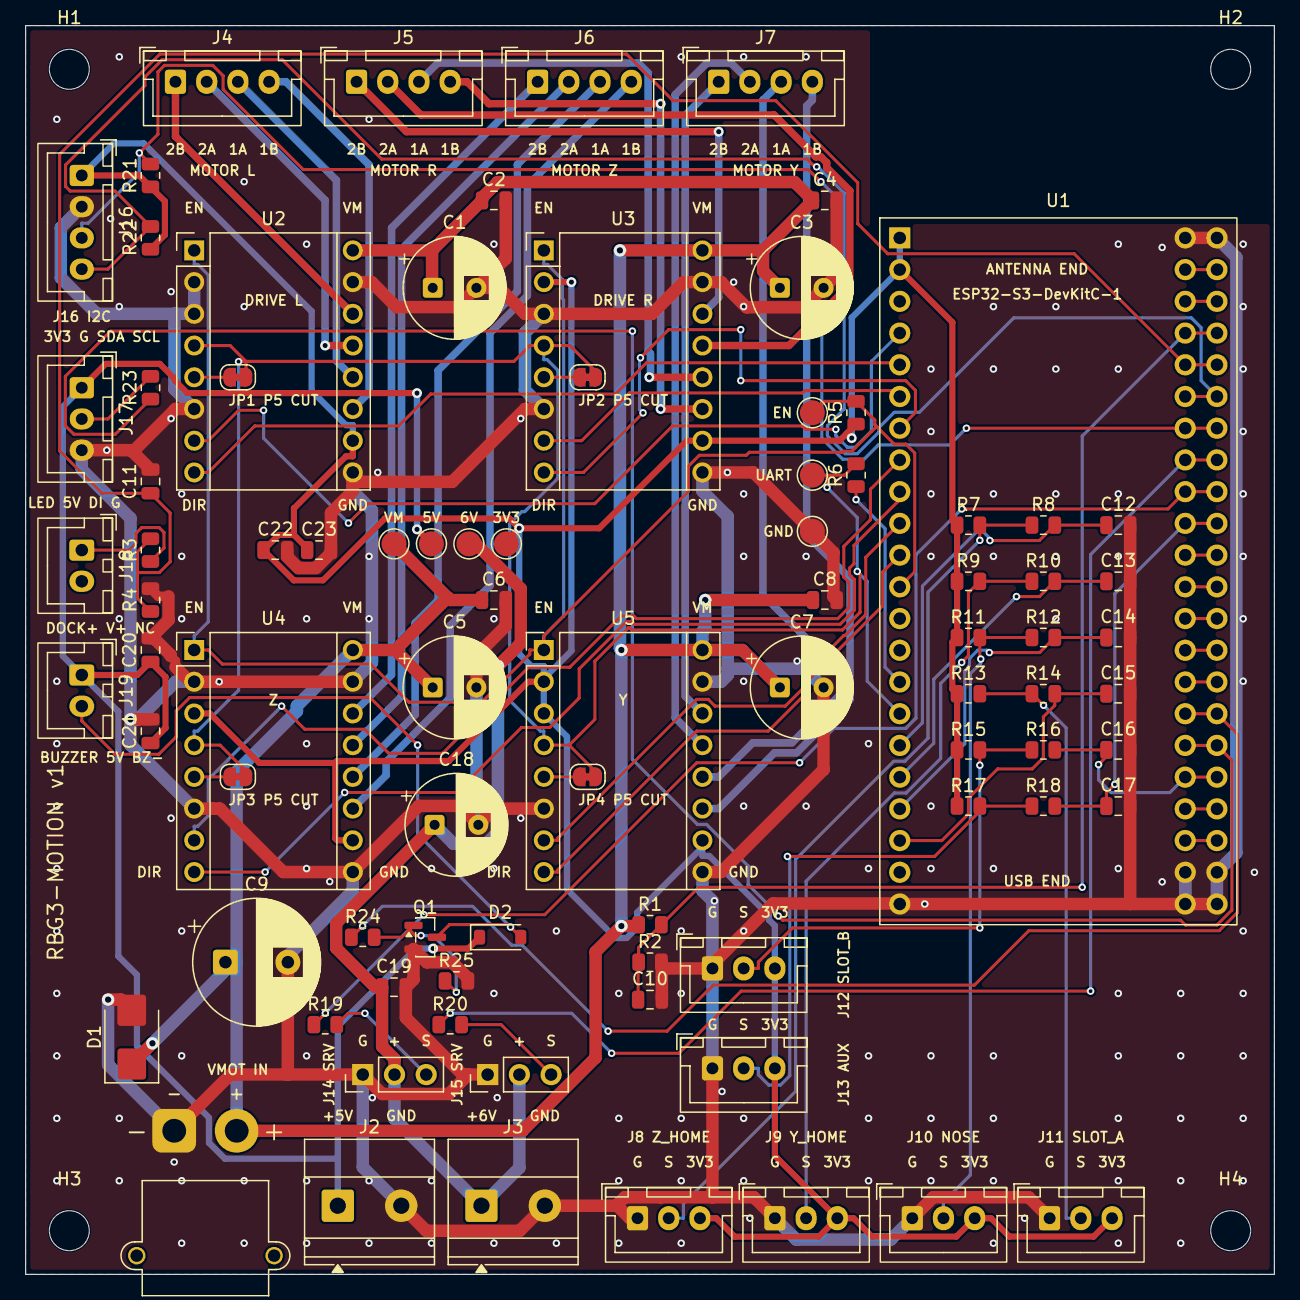
[picture p89: board rbg3-motion.kicad_pcb from above]

Board: 2 copper layers, 100.0 x 100.0 mm, 90 parts (0 on the bottom side), 62 nets.
