freethought101/RackBotGen3/cad/src/robot/drive_wheel.py

"""Drive wheel, right side: printed PETG hub + TPU 95A tire (print 2 of each; the left wheel is the same part).

Ø80 x 24 assembled, direct on the NEMA17 D-shaft (24 ± 1 mm, ends at x 142-144). The blind bore clears the longest
shaft, so the hub's position is set at assembly, not by the shaft end: fit it with a 2 mm shim against the bracket plate
(wheel centre 18 mm from the motor flange, under the 28 N radial-load rating at 20 mm). The hub clamps the shaft flat with an
M3 set screw in a radial M3 x 4 heat-set insert; an Ø8 window in the rim gives the iron and the hex key a straight
path (the tire has an Ø4 hole that is lined up with it after fitting). The web (5 spokes) is on the outboard face
so the hub prints outboard face down without supports. The tire is 0.5 mm undersize on the rim seat and is held
between two 1.5 mm lips.
"""

from cadgen import build123d as bd
from cadgen import step, stl

from lib.dims import M3_CLEAR, M3_INSERT_D, SHAFT5_BORE
from lib.prims import box, cyl_x, cyl_z
from lib.robot_dims import AXLE_Y, AXLE_Z, WHEEL_D, WHEEL_X

X0, X1 = WHEEL_X                  # 125 .. 149 (inboard .. outboard)
SHAFT_END_X = 144.0               # longest shaft: 24 + 1 mm from the motor face at x 119
LIP_W, LIP_D = 1.5, 75.0
SEAT_D = 72.0                     # rim seat under the tire
RIM_ID = 66.0                     # 3 mm rim wall under the tire seat
CORE_D = 18.0
WEB_T = 4.0                       # outboard web (print face)
SPOKES, SPOKE_W = 5, 6.0          # web cut into spokes between the core and the rim
WINDOW_R = (CORE_D / 2 + 2.0, RIM_ID / 2 - 2.0)
BORE_D = SHAFT5_BORE              # 5 mm shaft: 5.3 printed 5.08 (fit test 1), snug
FLAT_R = 2.2                      # D-flat at 2.0 from the axis (4.5 across) + 0.2 for the print shrink
SCREW_X = 132.0                   # set screw plane (mid shaft engagement)
INSERT_DEPTH = 4.5
WINDOW_D = 8.0                    # rim window for the iron and the hex key
TIRE_ID = SEAT_D - 0.5
TIRE_HOLE_D = 4.0


def _radial_z(d, x, r0, r1):
    """Cylinder along +z from radius r0 to r1 above the axle, at plane x."""
    return cyl_z(d, x, AXLE_Y, AXLE_Z + r0, AXLE_Z + r1)


@step(out="../../STEP/robot/drive_hub.step")
@stl(out="../../STL/robot/drive_hub.stl")
def drive_hub():
    hub = cyl_x(SEAT_D, X0 + LIP_W, X1 - LIP_W, AXLE_Y, AXLE_Z)
    for x0, x1 in ((X0, X0 + LIP_W), (X1 - LIP_W, X1)):
        hub += cyl_x(LIP_D, x0, x1, AXLE_Y, AXLE_Z)
    hub -= cyl_x(RIM_ID, X0 - 0.1, X1 - WEB_T, AXLE_Y, AXLE_Z)          # open inboard, web on the outboard face
    hub += cyl_x(CORE_D, X0, X1, AXLE_Y, AXLE_Z)
    windows = (cyl_x(2 * WINDOW_R[1], X1 - WEB_T - 0.1, X1 + 0.1, AXLE_Y, AXLE_Z)
               - cyl_x(2 * WINDOW_R[0], X1 - WEB_T - 0.2, X1 + 0.2, AXLE_Y, AXLE_Z))
    for i in range(SPOKES):
        spoke = bd.Box(WEB_T + 1.0, SPOKE_W, RIM_ID, align=(bd.Align.CENTER, bd.Align.CENTER, bd.Align.MIN))
        windows -= bd.Pos(X1 - WEB_T / 2, AXLE_Y, AXLE_Z) * bd.Rot(360.0 * i / SPOKES, 0, 0) * spoke
    hub -= windows                                                       # web -> 5 spokes
    bore = cyl_x(BORE_D, X0 - 0.1, SHAFT_END_X + 1.0, AXLE_Y, AXLE_Z)
    bore -= box(X0 - 0.2, SHAFT_END_X + 1.1, AXLE_Y - BORE_D, AXLE_Y + BORE_D, AXLE_Z + FLAT_R, AXLE_Z + BORE_D)
    hub -= bore                                                          # D bore, flat facing +z (the set screw)
    hub -= _radial_z(M3_CLEAR, SCREW_X, 0.0, CORE_D / 2 + 0.1)
    hub -= _radial_z(M3_INSERT_D, SCREW_X, CORE_D / 2 - INSERT_DEPTH, CORE_D / 2 + 0.1)
    hub -= _radial_z(WINDOW_D, SCREW_X, RIM_ID / 2 - 0.5, LIP_D / 2 + 0.1)
    hub.label = "drive_hub"
    return hub


@step(out="../../STEP/robot/drive_tire.step")
@stl(out="../../STL/robot/drive_tire.stl")
def drive_tire():
    tire = cyl_x(WHEEL_D, X0 + LIP_W, X1 - LIP_W, AXLE_Y, AXLE_Z)
    tire -= cyl_x(TIRE_ID, X0, X1, AXLE_Y, AXLE_Z)
    tire -= _radial_z(TIRE_HOLE_D, SCREW_X, TIRE_ID / 2 - 0.5, WHEEL_D / 2 + 0.1)
    tire.label = "drive_tire"
    return tire


if __name__ == "__main__":
    drive_hub()
    drive_tire()
