freethought101/RackBotGen3/(commit log)

2026-10-05 Initialize repo with text-to-cad plugin
    Enable the text-to-cad@earthtojake Claude Code plugin at project scope
    and add a basic .gitignore.
2026-10-05 Add CAD for caddy, dummy drive and bay shelf with fit check
    Shared dimensions in cad/src/lib/dims.py, build123d models via cadgen,
    fit-check assembly and geometry checks. Record single ownership and a
    revision history in the spec overview.
2026-10-05 Add rack and spare station CAD with dock block and tag carriers
    Dock stop moved in front of the rack (y = -30) so the robot nose clears
    the uprights; funnel gets a 10 mm parallel throat. Station checks cover
    interference, docking envelope, tray sweep and caddy extraction path.
    Spec updated to v0.1.2 (frame lengths, masses, budget).
    [rack.py]
2026-10-05 Add KiCad motion board (RBG3-MOTION v1) with fab outputs
    ESP32-S3-DevKitC-1 + 4x TMC2209 StepStick carrier, 100x100 mm 2-layer.
    ERC clean; DRC 0 errors, 0 unconnected, 0 parity (13 silkscreen-only
    items). Layout is scripted (place, Freerouting, stitching vias, pours)
    via scripts/build.sh; fab/ holds gerbers, BOM, pos, PDF, STEP. Spec 02
    updated to match the board as built.
    [rbg3-motion-bom.csv, rbg3-motion.kicad_pcb, rbg3-motion.kicad_sch, rbg3-motion.step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]
2026-10-05 Add robot CAD v0 with full fit, docking and stability checks
    13 printed robot parts plus a posed assembly factory (lift Z, extractor Y,
    finger states) with envelope stand-ins for purchased parts and the real
    motion-board STEP. checks/robot_check.py covers self-interference over 18
    poses, lift sweep while docked, extract/insert at every bay and spare
    slot with finger-in-notch, carrying two caddies, camera sight lines,
    mass/CG/tip-over, carry-on packing and print-bed fit: all pass.
    Design changes found during modeling and recorded in the spec (v0.1.4):
    direct drive (axle y -135), nose z 30-90, swing-down fingers with servos
    behind them, tray camera window, caddy tag moved left, E-stop on the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
    [mast_collar.py]
2026-10-06 Add Y belt drive to the robot CAD and a project backlog
    The Y motor's shaft pointed along the rail and no belt was modeled. Now:
    motor on a horizontal plate behind the rail end with its shaft down,
    20T GT2 pulley, idler in a new fork bracket at the rail front, belt loop
    beside the rail and a clamp on the carriage skirt. Robot checks pass
    (4.52 kg; mast unit packs at 229 of 230 mm). docs/BACKLOG.md collects
    all open checks from the spec, PCB and CAD work.
2026-10-06 Ignore KiCad local history folders
2026-10-06 Add parts list mirror and Notion sync rule
    docs/parts.csv mirrors the Notion Parts & Order List (36 parts, 478 USD,
    matching spec 04). CLAUDE.md records the rule to update both, plus the
    budget table, whenever a purchased part changes.
    [parts.csv]
2026-10-06 Apply independent design review fixes (spec v0.1.6)
    Mechanical: idle finger parked during Y strokes; 10 mm fingers (+/-1 mm
    play), Y pull/seat/push 177/178/178.5 with a hard stop at 187; gantry
    V-wheel carriages for Z and Y; rail bracket clamped by the tray screws;
    tray screws from behind into inserts; mast standing on its cross member
    with a collar socket and rear gusset; KFL08 instead of KP08; Z motor
    mount; resized battery box and module spaces; caster gap 6.5 mm.
    Checks now require 1 mm running clearance and run full pull/push strokes.
    Electrical: XT30 turned to face the board edge, SMBJ18A TVS at J1, J12/J13
    out of the USB plug path, R2 18k, 1.0 mm servo trace, separate PTH/NPTH
    drill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
    [parts.csv, rbg3-motion-bom.csv, rbg3-motion.kicad_pcb, rbg3-motion.kicad_sch, rbg3-motion.step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]
2026-10-06 Fix mast top plate fastening, add fit-test coupons (spec v0.1.7)
    - Mast top plate tab bolts into both 2040 front slots (2 x M5 at x = +/-10);
    E-stop box on 2 x M3 heat-set inserts
    - Fit-test coupons (shelf/caddy slices, hole coupon) and docs/fit-test-01.md
    - P11: M5 heat-set inserts and M5x16/x25 tray bolts; budget ~494 USD
    - Backlog: Tr8 nut flange hole pattern, E-stop box and DC rating
    Claude-Session: https://claude.ai/code/session_01GX62nVQQwzeKpipw85X2E4
    [parts.csv]
2026-10-06 Switch the robot E-stop to a VMOT relay (spec v0.1.8)
    - E-stop (NC) now opens the coil of a 12 V automotive relay whose contact
    cuts VMOT, so the button never breaks motor current; fail-safe on a
    broken wire
    - New P38 relay (3 USD), P21 E-stop spec updated; budget ~497 USD
    - Fix the unquoted comma in the P37 row of parts.csv
    - Backlog: relay placement and bench test
    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
    [parts.csv]
2026-10-07 Add the Pi application with simulation mode (rackbot/)
    Implements docs/spec/03-software.md §2-§7 as one asyncio process:
    - protocol/motion: ESP32 line protocol, SerialMotion client, MockMotion
    firmware simulator enforcing the §3 interlocks and E-stop/driver reconfig
    - rack: Modbus register map, ModbusRack client (pymodbus) and an
    in-memory PLC running the §4 ladder (dock power interlock, lamps, watchdog)
    - vision: §6.2 approach controller, SimVision, AprilTag/Picamera2 backend
    - mission: pull/push/goto primitives with retries, the swap-job state
    machine, FAULT with resume/abort, pause, E-stop recovery, auto mode
    - health, energy, SQLite store, FastAPI REST + WebSocket dashboard
    -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
    [clock.py, config.py, config.yaml, energy.py, health.py, main.py, mission.py]
2026-10-07 Add the ESP32-S3 motion firmware (firmware/motion/)
    PlatformIO project for docs/spec/03-software.md §3/§8:
    - lib/rbg3core: hardware-independent core behind a small HAL: line protocol,
    all §3 interlocks, homing with NC fail-safe, DOCK, VEL watchdog, STOP,
    VMOT E-stop with verified TMC2209 re-configuration, GSTAT.reset polling,
    10 Hz telemetry, CFG settings
    - src: ESP32 HAL (FastAccelStepper, TMCStepper single-wire UART addr 0-3,
    ESP32Servo, INA226, WS2812, ADC dividers) with the 02 §3.1 pin map
    - test/test_core: 20 Unity tests on the host (pio test -e native)
    - sim: FakeHal physics + fwsim, the core on a pseudo-terminal
    rackbot: tests/test_firmware_link.py runs SerialMotion again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
    [fake_hal.h, main.cpp, mission.py, motion.py, pins.h]
2026-10-07 Record the motion protocol details in the spec (spec v0.1.9)
    03 §3: E_STOPPED, STATUS reply, TEL busy letters, BOOT/DRIVER_RESET/SLOT/
    BADLINE events, CFG keys, busy and homed rules. §1 firmware layout, §8
    homing, E-stop recovery timing and LED. No parts change.
2026-10-07 Apply motion board review fixes (spec v0.1.10)
    Independent pre-fab review of RBG3-MOTION v1, majors 1-4:
    - Silkscreen (scripts/silk.py, run by build.sh): board name, connector
    functions and pin order, J2/J3 polarity, StepStick EN/VM/DIR/GND
    corner marks, DevKit ANTENNA/USB ends. J8-J15 and JP refs on F.Fab.
    - JP1-JP4: open solder jumpers from StepStick pin 5 to TMC_UART for
    modules with PDN_UART on pin 5; courtyards dropped (fix_text.py).
    - J18 pin 2 not connected, so dock - cannot be wired to robot GND.
    - stitch.py: extra GND via next to through-hole GND pads (fixes a
    boxed-in GND island at U2 CLK).
    - Spec 02 §3: TVS clamp and reverse-polarity wording corrected.
    Rerouted with buil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
    [rbg3-motion-bom.csv, rbg3-motion.kicad_pcb, rbg3-motion.kicad_sch, rbg3-motion.step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]
2026-10-10 Switch the camera to a local IMX708 120° board (spec v0.1.11)
    P13 is now an IMX708 120° FOV board (Camera Module 3 Wide class) from
    Tokopedia, 37 USD. The genuine module costs about 46 USD landed from
    AliExpress after Indonesian import tax. Budget is now about 499 USD.
    Backup cost-cutting options and local sources go in docs/sourcing-options.md.
    [parts.csv]
2026-10-10 Buy motors, drivers, ESP32 and servos locally (spec v0.1.12)
    P01 NEMA17, P17 TMC2209, P16 ESP32-S3-DevKitC-1 and P09 MG90S now come
    from Tokopedia. This avoids the ~30-40 % Indonesian import tax on
    AliExpress parcels over USD 3. Budget drops from about 499 to about 493 USD.
    [parts.csv]
2026-10-10 Source everything but the PCB locally; print the drive wheels (spec v0.1.13)
    - Move P04-P06, P08, P10, P15, P18, P19, P21, P23, P27-P29, P37 and P38 to
    Tokopedia. The motion PCB (P22, JLCPCB) is now the only import.
    - Local INA226 modules ship with the R100 shunt, so P19 adds a 2512 R010
    shunt to swap in.
    - Casters are set to height with printed spacers.
    - P07 (bought wheels) is no longer needed. The drive wheels are now a
    printed PETG hub (D-bore, M3 set screw in a radial heat-set insert, rim
    window for access) plus a TPU 95A tire (cad/src/robot/drive_wheel.py),
    and robot_check passes with them.
    - Budget drops from about 493 to about 440 USD.
    - docs/sourcing-options.md lists the c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
    [parts.csv]
2026-10-10 Cut the drive hub web into 5 spokes to save filament
2026-10-10 Thin the drive hub rim to 3 mm
2026-10-10 Itemise the motion board components on Tokopedia (spec v0.1.14)
    P23 is now listed line by line from the board BOM in
    docs/sourcing-options.md §3.1. Most of it comes from one shop (Putra Niaga
    Bandung), the electrolytics are through-hole, and the JST-XH headers come
    from the P21 kit. The estimate drops from 12 to 5 USD, and the budget is
    now about 433 USD.
    [parts.csv]
2026-10-10 Add component datasheets folder with README index
    Datasheets, schematics and drawings for the parts in docs/parts.csv and the
    motion-board BOM (ESP32-S3, TMC2209/MKS module, INA226, buck chips, diodes,
    connectors, Pi 3B+, camera, Delta PLC/PSU, motor catalog, cells, relay).
    README.md maps each file to its part ID and source and lists what was not found.
2026-10-10 Cross-check spec values against the datasheets (spec v0.1.15)
    Add docs/datasheets/CROSSCHECK.md (value, source page, status) and fix the
    mismatches it found: MKS TMC2209 V2.0 has UART on pin 5 (close JP1-JP4, P17),
    ESP32-S3 octal flash/PSRAM pins are 33-37, VMOT sense reads to ~19 V,
    TMC2209 29 V operating / 32 V abs max, drive force ~6 N per wheel at 1.0 A
    plus a shaft radial-load note, and DVP-12SE11T outputs need UP/ZP wired.
    Open decisions go to the backlog. No cost change.
    [parts.csv]
2026-10-10 Consolidate orders into fewer shops; buy the travel router (spec v0.1.16)
    - docs/shopping-list.md now groups the Tokopedia order into 22 shops
    (was 33). Five main shops carry most of it: Lajarus Teknik (extrusion,
    lead screw set, belt, idler), Rajacell (motors, ESP32, casters,
    switches), CNC Store Bandung (power modules, robot E-stop), Putra Niaga
    (board parts incl. headers and 470 uF) and Rajawali3D (V-wheels,
    spacers, pulley).
    - P31: the travel router is not owned. The GL.iNet GL-MT300N-V2 is now a
    purchase at 38 USD.
    - P12 Pi 3 and P25 Delta PLC: Tokopedia backup prices recorded (not in
    the budget).
    - Budget is now about 462 USD.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
    [parts.csv]
2026-10-10 Source the last generic parts and add their datasheets (spec v0.1.17)
    - BMS (Rajacell); nickel strip, rocker switch, DIN rail and UK5N terminal
    blocks (CNC Store Bandung); silicone wire (alladinshop); brass sheet; a
    microSD brand rule.
    - The battery shop spot-welds the pack.
    - New datasheets: Delta DRL-24V120W1EN (the chosen PSU; replaces the
    sample model), the Songle SRD relay used on 24 V relay modules, and the
    Amass XT60H.
    - The datasheet README now lists the generic parts that have no
    manufacturer sheet.
    - No local polyfuse rated >= 30 V was found. The proposed UK5-HESI fuse
    terminal is pending a decision.
    - Budget is now about 460 USD.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
    [parts.csv]
2026-10-12 Set the servo buck to 5.8 V (spec v0.1.18)
    The MG90S is rated 4.8-6.0 V, so 6 V sat at its maximum. The rail keeps
    its "6V" name on the board; no PCB or cost change.
    [parts.csv]
2026-10-12 Add motion board assembly checklist and JLCPCB SMD assembly files
    The README gets a hand-assembly and bring-up checklist. scripts/jlc_pcba.py
    (run by export_fab.sh) writes a JLCPCB BOM and CPL for optional Economic
    assembly of the 39 SMD parts; all LCSC matches are basic or preferred, so
    there are no extended-part fees.
    [rbg3-motion-jlc-bom.csv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]
2026-10-12 Close the datasheet cross-check open items (spec v0.1.19)
    - Motion board: JP1-JP4 are now normally bridged solder jumpers (net tie),
    since the MKS TMC2209 V2.0 has PDN_UART on pin 5; cut the strip to open.
    Silk label "JPn P5 CUT". Layout rebuilt (DRC: 0 unconnected, 0 parity,
    same 19 cosmetic warnings) and fab files regenerated.
    - Drive hub: blind bore deepened to clear the 24 +/- 1 mm shaft (it was sized
    for 22 mm and would push the wheel 1-3 mm out); hub fitted with a 2 mm shim
    against the bracket plate to keep the radial load ~18 mm from the flange.
    - Main fuse 10 A -> 7.5 A (Samsung 35E max discharge 8 A).
    - PSU spec >= 75 W, chosen Delta DRL-24V120W1EN (120 W); P24 35 -> 39 US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
    [parts.csv, rbg3-motion.kicad_pcb, rbg3-motion.kicad_sch, rbg3-motion.step]
2026-10-17 Add the design review pack and SPICE checks of the power path
    - docs/review/: electrical (12 questions) and mechanical (5 questions) review briefs
    with board and robot renders, plus a "how this design has been verified" section.
    - pcb/motion-board/sim/: ngspice netlists (KiCad's bundled library) for battery
    hot-plug, E-stop with drivers loaded, charger backfeed, ADC dividers and UART.
    run.sh writes results.md and plots; all checks pass.
    - BACKLOG: EE review before the JLCPCB order.
2026-10-18 Plan JLCPCB SMD assembly and print-service hole tolerances (spec v0.1.20, v0.1.21)
    v0.1.20: motion PCB SMD parts assembled by JLCPCB (Economic) on 2 of the 5
    boards; P22 25 -> 40 USD, P23 through-hole only; budget ~479 USD. Layout PDF
    added to the fab exports.
    v0.1.21: caddy drive-screw slots 3.4 -> 3.7 mm (6-32 UNC HDD screws), mast
    collar socket 0.1 -> 0.3 mm per side, drive hub bore 5.15 -> 5.3 mm. Print
    rule: >= 4 walls + >= 20 % gyroid/cubic, 100 % scale, no hole compensation.
    Fit test checklist updated. Mechanical spec parts table keyed to parts.csv IDs
    and a per-part reference section added.
    [parts.csv]
2026-10-18 Tidy the motion board schematic so labels no longer overlap
    Each switch input, sense divider, decoupling pair and servo/I2C/LED/buzzer
    passive is now a horizontal row with its labels at the pin ends. Connector,
    TVS and driver values are moved clear of the pin labels, the two diagonal
    divider wires are replaced by named labels (VMOT_SENSE, DOCK_V_SENSE), and
    the title block is filled in. Layout only: the exported netlist is identical
    (76 nets), ERC is clean and DRC schematic parity reports 0 issues.
    [rbg3-motion.kicad_sch]
2026-10-18 Add the 90 s pitch film as a Remotion project
    The film animates the real CAD (exported to GLB) through the spec's swap
    sequence, with kinetic type and a synthesised music bed. Generated meshes
    and audio are committed so it renders without re-running the exporters.
2026-10-18 Move the charging dock to the spare station (spec v0.1.22)
    The spare station becomes the robot's home: it waits and charges there, so
    a job starts with the pick from S1 and ends after placing the RMA caddy in
    S2. Each swap now drives spare -> rack -> spare instead of four legs; the
    simulated cycle drops from 163 s to 107 s.
    - Dock contacts and the dock switch (PLC X4) go on the spare-station dock
    block; the rack dock keeps its funnel and stop only. The dock relay stays
    on the rack DIN rail, so the rack E-stop still cuts dock power.
    - Pi app: HOME = "spare"; TO_SPARE is gone, RETURN only drives after an
    abort. Simulator and tests follow.
    - Parts: P30 adds a 2-core dock power lead (8 ->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
    [parts.csv]
2026-10-20 Start the pitch film's swap at the robot's base station
    The spare station now sits ~3.2 m down the aisle and doubles as the
    robot's charging base. The robot picks the spare there, drives an
    L-shaped route to the rack (reverse swing out of the dock, aisle run,
    one 90° turn) and back, so it never spins 180° in place. The planned
    route is drawn on the floor and new wide and tracking shots cover the
    bigger floor.
    Backlog: move the charging dock from the rack to the spare station.
2026-10-22 Add the electrical review pack PDF with a project overview and PCB renders
    - docs/review/build_pack.py builds electrical-review-pack.pdf: cover with
    contents, project overview (new project-overview.md, robot renders), review
    brief, schematic, layout, 3D renders, electrical spec, board README, SPICE
    results and the datasheet cross-check. Markdown goes through pandoc and
    headless Chrome; merge_pdf.swift joins the parts with bookmarks.
    - export_fab.sh also exports a multi-page layout PDF (one layer per page with
    the outline, 1:1, title block) and top, bottom and isometric 3D renders.
    - PCB title block filled in to match the schematic (text only; copper and
    gerbers unchanged).
    Co-Au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
    [rbg3-motion.kicad_pcb]
2026-10-22 Apply the motion board schematic review (spec v0.1.25)
    Motion PCB:
    - Servo rail 220 uF / 25 V + 100 nF (C18/C19): the servo buck is off-board
    on a lead, so MG90S start/stall pulses would sag the rail at the servos.
    - +5V and +3V3 decoupling, 10 uF + 100 nF each (C20-C23).
    - 10 k pull-down on the buzzer transistor base (R25), so GPIO48 floating
    at reset cannot half-drive Q1.
    - Seven SMD test pads (TP1-TP7: VM, 5V, 6V, 3V3, UART, EN, GND).
    - Notes on the schematic sheet (UART addresses, NC switches, J18 pin 2,
    E-stop upstream of J1, power tree).
    - JLCPCB assembly 39 -> 45 SMD parts, all basic (C15850 for the 10 uF).
    Layout build: Freerouting treated the bottom GND pour as one plane, so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
    [parts.csv, rbg3-motion-bom.csv, rbg3-motion-jlc-bom.csv, rbg3-motion.kicad_pcb, rbg3-motion.kicad_sch, rbg3-motion.step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]
2026-10-22 Fix the V-wheel axle stack and list the fit-test fasteners (spec v0.1.23)
    Eccentric spacer holes 5.3 -> 7.3 mm (Z +x pair, Y lower pair) so the
    7.12 mm boss can turn. A fixed 7 mm stack (6 mm spacer + 1 mm 5x8 shim)
    plus a 0.6 mm pad on the Z plate and a 0.4 mm recess in the Y plate put
    every wheel on its groove centre. P04 adds plain spacers and shims
    (8 -> 10 USD), budget about 482 USD. Sourcing adds Tokopedia links for
    the fit-test fasteners (P11).
    [parts.csv]
2026-10-23 Mark XT30 polarity on the motion board and switch P16 to the Rajacell N8R2
    - Silkscreen: + / - above J1's pads (VMOT IN label moved up 0.9 mm); fab outputs regenerated.
    DRC: 0 errors, 0 unconnected, 0 parity issues (20 warnings, unchanged).
    - P16: Rajacell N8R2 (N16R8 sold out); the firmware needs 8 MB flash and no PSRAM. Listing
    photos checked: same pin order as the footprint, RGB LED on GPIO48 (buzzer), harmless.
    - Backlog: the human EE review reply and the XT30 bring-up check.
    [parts.csv, rbg3-motion.kicad_pcb, rbg3-motion.step]
2026-10-23 Add harness polarity steps to the motion board bring-up and use XT30/XT60 pigtails
    - Board README: JLCPCB assembles 2 of the 5 boards; new "Harness polarity" steps before bring-up
    (factory-made pigtails, colour-only wiring, meter every lead, bench supply first).
    - P21: XT30/XT60 pairs as ready-made pigtails (shopping list updated); budget unchanged.
    - Backlog: XT30 polarity item points to the pigtails.
    [parts.csv]
2026-10-23 Drill the StepStick sockets 1.0 mm so female-header tails fit
    The library Pololu_Breakout-16 footprint drills 0.8 mm, which can be too small for female-header
    tails (~0.6 mm square, ~0.85 mm across). scripts/fix_text.py now sets U2-U5 to 1.0 mm holes and
    keeps the 1.6 mm pads, so copper and routing are unchanged. DRC: 0 errors, 0 unconnected, 0 parity
    (24 warnings: 4 new library mismatches on U2-U5, expected). Fab outputs regenerated.
    [rbg3-motion.kicad_pcb, rbg3-motion.step]
2026-10-23 Fix D1's rotation in the JLCPCB placement file
    JLCPCB's placement preview showed D1 (SMBJ18A, D_SMB) with its cathode band on the GND pad. The 180°
    offset for D_SMB was wrong: D_SMB, like D_SOD-123, needs no offset; SOT-23 keeps 180°. D1 is now
    placed at 90° and was checked in the preview (band on the VMOT pad).
    [rbg3-motion-jlc-cpl.csv]
2026-10-23 Rework the budget: buy the Pi, ESP32 rack controller, no router (spec v0.1.27)
    - The Pi 3 is not team-owned, so a 3B+ is bought (P12, +70 USD); add one
    month of Claude Pro (P39, +23).
    - PLC access looks unlikely: the ESP32 rack controller (P40, 18 USD) is now
    counted, with the modules and wiring in 02 4.4.
    - Drop the travel router (P29, P31): the Pi is the Wi-Fi access point and the
    rack controller joins it. Tower light replaced by 3 x 22 mm 24 V panel
    lamps (P27, 8 -> 3). Budget about 548 USD, 48 over.
    - Deck: 6 M3 holes for the trays and battery box, positions shared in
    robot_dims (fixes Pi tray holes in its window / over the rail and battery
    box holes over the rear cross membe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
    [deck.dxf, parts.csv]
2026-10-23 Record the motion PCB order (P22): JLCPCB, FedEx, 32 USD
    Ordered 23 Oct with Economic assembly of 2 boards; Q1/D1/D2 orientation checked in JLCPCB's
    preview. Paid 32 USD after discount (43 USD list), under the 40 USD estimate.
    [parts.csv]
2026-10-23 Add the prototype review report and system diagrams
    - Corvin-project-review.pdf: 15-slide prototype-level review of the whole
    project (mechanical fit, 3D-print materials and structure, electrical,
    software, parts and budget, timeline to 12 Nov, MVP cuts, pitch fixes).
    - RBG3-motion-schematic-review.pdf: the first motion-board schematic review
    (its fixes are already in the ordered board: C18-C23, R25, TP1-TP7, E-stop on J13).
    - img/system-map.png, img/robot-simple.png: system and power diagrams.
2026-10-24 List 3D print services and compare prices for the R3 print package
    Adds sourcing-options §6: Tokopedia shops with beds of at least 300 mm
    (its basic, JAP3D, 3DTEC, BeauxButton, DTRON3D, K3D) with PETG/TPU
    price per gram and an estimated R3 total, cheaper small-bed shops for a
    split order, Bali/online options, and why JLC3DP doesn't fit this order.
2026-10-25 Model holes oversize after fit test 1 and file new datasheets and 3D models
    Fit test 1 (25 Oct, PETG, Bekasi print shop) printed small holes 0.2-0.65 mm
    under size. The hole sizes now live in dims.py and are enlarged so they print
    at the intended size: M2 pilot 1.95, M3 self-tap 2.85, M3 clear 3.6, M3 insert
    4.4, M5 clear and drive-hub bore 5.5, M5 insert 7.0, eccentric spacer hole
    7.6. Also finger horn screw 2.5, anti-backlash nut pocket 10.8/22.4 and the
    button-head counterbores. All parts rebuild; bay_fit and robot_assembly pass.
    Add the 17HS4401S, KFL08, KW11-3Z, Camera Module 3 Wide, Arducam B0310,
    XL4015 rev 2.0 and ESP32-S3-DevKitC-1 v1.1 files to docs/datasheets, and STEP
    models (KF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
    [BOM(V0.3)_ESP32-S3-DevKitC-1_XX_TTNNVV.xlsx, Fabrication_Requirements_ESP32-S3-DevKitC-1_20220429.xls, P01_nema17_openbuilds.step, P04_bearing-105zz_openbuilds.step, P04_mini-eccentric-spacer-6mm_openbuilds.step, P04_mini-v-wheel_delrin-assembly_openbuilds.step, P04_mini-v-wheel_xtreme_openbuilds.step, P04_precision-shim-8x5x1_openbuilds.step]
2026-10-25 Fit the tray camera slot to the Waveshare IMX708-120 board
    wirogix confirmed the camera is the Waveshare IMX708-120, the same board as the
    Camera Module 3 Wide drawing (25 x 23.862, lens 14.4 above the bottom edge).
    The old slot was exactly 25.0 wide, assumed the lens 12 above the edge and had
    no room for the rear connector.
    The PCB now drops into a 25.8 wide slot (0.4 mm per side) and rests on its
    floor at the lens height; 1.5 mm edge strips hold it, with a front window for
    the lens holder, a rear connector pocket and an 18 mm ribbon slot. The board
    dimensions live in CAM_BOARD, and the assembly placeholder uses them. No
    overlaps at Z min or Z max.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
2026-10-25 Fix the design-review blockers: tray axle-nut pockets, fittable slot switches
    From the independent design review (25 Oct):
    - Tray back plate: Ø12 x 9 pockets for the lower Z-wheel axle nuts. The M5
    axles end past the Z plate's front face, where the tray bolts flush, so the
    tray could not seat.
    - Tray slot switches: the KW11-3Z pockets were closed, so a switch could not
    be fitted. Each switch now lies flat in a pocket open to the back face, held
    by 2 x M2 self-tapping screws through access holes in the bottom (slot B) or
    top (slot A) face, with a wire groove down the back face. The Z plate closes
    the pockets. The body also moves forward so the lever reaches 6.6 mm past the
    sto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
    [parts.csv]
2026-10-25 Add a KiCad schematic of the whole electrical system (robot, rack, ESP32 rack fallback)
    Generated by pcb/system/scripts/gen_system.py from spec 02. The motion board is one block whose
    connector pins match the board netlist (J1-J19). ERC: 0 violations.
    [rack-esp32.kicad_sch, rack.kicad_sch, rbg3-system.kicad_sch, robot.kicad_sch]
2026-10-25 Add Z/Y home-switch mounts, nose switch holes, keyed finger, Pi tray fixes
    Pre-print fixes from the independent design review (25 Oct):
    - Z home switch: KW11 on a hanger under the Z carriage's nut block, lever
    down onto the Z-motor mount plate. Triggers at Z 101 (new Z_HOME), 0.4 mm
    above the hard stop; M2 holes slotted +/-1.5 mm. Firmware z_home 100 -> 101
    (was the hard stop itself); tests and docs updated.
    - Y home switch: KW11 lying flat on a post on the rail bracket, pressed by
    the carriage frame's rear face at Y = 0; M2 holes from the top, slotted.
    - Nose dock-detect switch: the bracket had no holes; now slotted M2 pilots,
    free lever 3 mm past the nose tip.
    - Finger keyed to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
    [pi_tray.py, rail_bracket.py, tray_stack.py, y_carriage.py, z_carriage.py]
2026-10-25 Spec v0.1.24-v0.1.29: schedule re-plan, review parts fixes, second XL4015
    Pending spec work from the parallel session:
    - v0.1.24 schedule re-plan (04 §2): all orders out on 23 Oct, parts in hand
    by 2 Nov, integration 3-6 Nov.
    - v0.1.26 NEMA17 mounts checked: M3 x 8 motor screws, rail bracket boss
    Ø22.5 -> Ø23; firmware Y speed 50 -> 60 mm/s to match the spec.
    - v0.1.28 parts fixes from the prototype review: front caster 23.5 mm, P11
    adds V-wheel axle bolts + nylocks and the belt-clamp M3 x 16, P16 x2.
    - v0.1.29 servo buck -> a second XL4015 CC/CV at 5.8 V (the MP2482 module is
    fixed at 5 V); CAD buck envelopes per module (BUCK_SIZE).
    - Budget (04 §1) and parts.csv / shopping lis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
    [parts.csv]
2026-10-25 Add the pitch poster, pitch video project, guidebook and cart notes
    - docs/poster: A2 poster (HTML source, PDF, PNG, images).
    - video: Remotion project for the pitch video (node_modules/ and out/ are
    gitignored; GLB models and the audio bed are regenerable with
    export/export_glb.py and audio/make_bed.py).
    - Delta Cup 2026 guidebook for applicants (PDF).
    - docs/cart-batch-2.md: Tokopedia batch-2 items, priced 24 Oct.
    - P16 ESP32-S3-DevKitC-1 dimension drawing.
2026-10-26 Budget from the actual cart and quotes, savings plan, budget PDF (v0.1.30)
    04 §1.0 (new): spending and forecast at Rp 18,000 = 1 USD from the Tokopedia
    cart (Rp 6.5M incl. ≈ Rp 1M shipping to Bali), the items still to add, the
    paid JLCPCB order (32 USD), the BeauxButton print quote (Rp 2.0M, shipping
    free) and the remaining estimates: ≈ 575 USD, ≈ 75 over the 500 target.
    Explains that 500 USD is the team's own target (the finalist grant; the
    guidebook has no cap or penalty), why the budget is over, and a tiered
    savings plan that reaches ≈ 495-500 USD while keeping the Pi and camera.
    The old per-category tables stay as the v0.1.28 planning estimate.
    00-overview: C2 constraint update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
2026-10-27 Tolerant parts, stronger nut block and brackets, OpenBuilds STL models
    - Caster spacers (22 mm rear, 3.5 mm front) for the bought 20 mm casters; nose caster holes; battery box,
    Y-carriage washer gap, Z-carriage nut block made tolerant of unmeasured parts
    - Z-carriage nut block: 30 x 30, two gussets to the plate, flange recess with >= 3.6 mm walls, 4 x M3
    self-tapping pilots on a 16 mm circle (replaces the merged 3/4-hole slots with a 0.3 mm wall)
    - Drive bracket webs 14 mm so the M5 head-access bore no longer breaks out of the sides
    - Rail bracket: Y-switch post covers the whole switch (0.4 mm wall at a pilot); edge rib under the
    Y-motor plate (wider breaks the 230 mm bag limit)
    - Open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
    [P01_nema17_openbuilds.stl, P02_vslot_2020_l0300_openbuilds.step, P02_vslot_2020_l0300_openbuilds.stl, P03_vslot_2040_l0500_openbuilds.step, P03_vslot_2040_l0500_openbuilds.stl, P04_bearing-105zz_openbuilds.stl, P04_mini-eccentric-spacer-6mm_openbuilds.stl, P04_mini-v-wheel_delrin-assembly_openbuilds.stl]
2026-10-27 Z carriage: mount the OpenBuilds-style anti-backlash nut block (P05)
    The bought nut is a 34 x 33 x 12 block (OpenBuilds 1055 copy), not a round flange nut. The Z carriage now holds it
    on a fin beside the screw (2 x M5 x 20 into the block's nylock pockets) with its body end up against a shelf that
    carries the lift load; the shelf has an access hole for the preload screw. The assembly uses the block's STEP and
    the drawing is in docs/datasheets. P05/P11 updated (M5x20 + nylocks), Notion synced. robot_check: 41 pass.
    [P05_anti-backlash-nut-block_openbuilds.step, parts.csv]
2026-10-27 Docs for v0.1.31: nut block, tolerant parts, bracket fixes
    Changelog entry and status v0.1.31; P05 row, part sizes and bracket notes in 01-mechanical; backlog item for the nut
    block (replaces the flange-hole count); cross-check row against the OpenBuilds 1055 drawing; datasheet index lists the
    drawing, nut STEP, V-slot STEPs and STL copies; budget/shopping-list wording; P05/P08/P11 at v0.1.31 (Notion synced);
    CAD README part list with the caster spacers.
    [parts.csv]
2026-10-27 Fastener model and check, real part models, hole audit (v0.1.31)
    - lib/robot_fasteners.py + checks/fastener_check.py: 115 joints with step.parts screws, nuts, T-nuts and insert
    sleeves; checks holes, seating, thread engagement / bottoming and running clearance over 19 poses. Fixed what it
    found: left-rail deck screws under the battery box and Z motor, battery-box screws under the pack (+x tab),
    Y-motor screws blocked by the plate rib (removed), rail-bracket strip (6 mm counterbores, M5 x 16), idler bracket
    bolt head between the arms (countersunk, 4 mm plate), Z-switch hanger and Z-wheel axle head vs the Z-motor mount
    at the hard stop (hanger shortened, mount notched)
    - Real models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
    [P10_kw11-3z-hinge-lever.step, P12_raspberry-pi-3b.step, parts.csv, print-settings.csv]
2026-10-28 Fix the drive snapping back at drop-offs and the camera whips in the swap
    Hand the caddy to the bay / RMA slot before the finger releases, and replace
    fast camera sweeps across the floor with cuts and slow drifts.
2026-10-28 Pitch film: title cards say Corvin instead of RackBot Gen3
    The opening title and the closing kicker now use the team's brand name, matching the
    senior referee review deck.
2026-11-02 Heat-set inserts (3Din) and the full fastener buy list in P11
    - 3Din insert dimensions saved (docs/datasheets/P11_heat-set-inserts_3din.jpg): M3 OD 4.2, M5 OD 7.0. The pilots
    (4.4 / 7.0, oversized for the fit-test-1 shrink) print about 4.0 / 6.35, the right interference; cross-check row
    added. Fastener model inserts set to M3 x 4 (OD 4.2) and M5 x 8; fastener_check still passes.
    - P11: buy list by size (M2, M2.5, M3, M4, M5, T-nuts, nylocks, corner brackets, inserts) with buy and used
    quantities; robot counts from the fastener model, rack-side counts estimated. Notion synced.
    [parts.csv]
2026-11-02 Adjustable Z nut mount, loose deck rail holes
    - Z carriage: nut-block holes slotted +/-1.5 mm across and +/-0.5 mm vertically, fin moved out 0.75 mm for 0-1.5 mm
    of washer shims behind the block, so the nut can be lined up with the lead screw (screw held at both ends; eccentrics,
    prints and bought parts add up to ~0.5-1.5 mm). Fastener model updated; alignment steps in the backlog (and Notion).
    - Deck: rail screw holes 6.0 mm (PETG shrinks ~0.3 %, ~0.4 mm across the 130 mm rail spacing); DXF regenerated.
    [deck.dxf]
2026-11-02 Z carriage: fin root 2 mm higher, clear of the Z-motor screw heads at the hard stop
    The fin moved 0.75 mm out for the nut-block shims, bringing its root to 0.97 mm from a Z-motor screw head at Z_MIN
    (contact at the hard stop). fastener_check passes again.
2026-11-13 Add the 150 s Corvin technical film (CorvinTech) with SFX and music
    New Remotion composition in video/src/tech: per-subsystem CAD meshes (export/export_tech_glb.py),
    exploded view, focus ghosting, wheel rotation, blue poster palette, scene overlays with spec rows and
    design reasons, animated power tree, full swap simulation, SFX cues derived from the robot's motion and
    a bar-aligned music edit. The keyframe engine moved to src/engine.ts and is shared with the 90 s film.
    Also keeps the fix for the failed drive vanishing at the RMA drop in the 90 s film.
    [CREDITS.csv, sfx-cues.csv]
